PiyushPapaya/Cheirograph/08-ble-wireless-dashboard/README.md

# 08 - BLE Wireless Dashboard

**Phase 7.5, live wireless visualization, ahead of real data collection.**

Once the glove was wired and mounted, I wanted a way to actually see it working, untethered, in real time, in a browser, before committing to the effort of collecting a labeled training set. This stage streams all six IMUs over Bluetooth LE to a live dashboard that renders a 3D hand model plus per-sensor accel/gyro traces. It's also where the hardest debugging session of the whole project happened.

**Status: v4 firmware live on the glove since 2026-08-07, streaming at ~47 Hz.** Open issues are listed at the bottom.

**Firmware:** [`08_ble_dashboard.ino`](08_ble_dashboard.ino). Flash it with the Arduino IDE using the Seeed nRF52 Boards package (the Adafruit-based core, see Toolchain below).
**Dashboard:** `handrig_dashboard.html`, open it directly in Chrome or Edge, desktop or Android, no build step, no server. The canonical copy is `tools/handrig_dashboard.html` (the `tools/verify_*.mjs` scripts read it). Byte-identical copies sit [here](handrig_dashboard.html) (this stage's deliverable) and in `Data/html/`; copy the canonical file over both after every edit and compare with `md5sum`.

## Why this is v4, not v1

The first two firmware attempts fed all six IMUs through the same library I'd used since Phase 2, and got garbage back from four of the five fingers. Not noise, actual stuck values. One gyro axis pinned at exactly `246.0938` on every single frame. Another axis ramping by an exact, constant step every frame, like a counter, not like a physical rotation. Real evidence of this is saved in this folder's CSV captures.

I chased this as a fusion or calibration bug for a while, "garbage in, garbage out no matter how I calibrate," and that was the wrong layer to be looking at. The actual problem was two layers below any math: the sensors themselves were never fully waking up.

```mermaid
flowchart TD
    A["Symptom: 4 of 5 fingers stream garbage"] --> B{"Assumed cause: fusion or calibration bug"}
    B -->|hours of tuning, no fix| C["Root cause is two layers lower"]
    C --> D["Read WHO_AM_I on all five fingers"]
    D -->|4 report 0x72, 1 reports 0x68| E["Same clone-family discovery as Stage 02, now at full scale"]
    E --> F["Library never sends the wake-up write these clones need"]
    F --> G["Drive fingers with raw I2C register writes instead"]
    G --> H["All five fingers read clean"]
```

**Root cause:** the five finger modules are MPU-6500/9250-family clones, same discovery as Phase 2, just five sensors deep into the build before it mattered this much. The library I'd been using talks to them fine at the bus level, I²C acknowledges, addresses respond, but it never sends the specific register write that fully wakes this chip family. So the clones boot into a half-asleep state and return a fixed internal pattern instead of live sensor data. One finger, the pinky, happened to be a genuine MPU-6050 and worked from the start. That "always the same four broken, always the same one working" pattern was the actual clue that pointed at initialization, not wiring or a bad batch.

**The fix:** drop the library for the fingers and drive them with raw I²C register writes: explicit reset, wake, enable-all-axes, configure. That last step, enabling all six accel and gyro axes explicitly, is the one the clones specifically need and the library was silently skipping.

## What changed between v3 and v4

v3 fixed the wake sequence but still assumed every write actually landed. v4 closes that assumption, one gap at a time:

- **Every I²C write's acknowledgment is now checked.** Previously a failed write, including a failed mux channel select, passed silently. A NACKed mux select is a specific kind of dangerous, since it means one finger's configuration can get written to whichever channel was still latched from before.
- **Config gets read back and compared after every init.** An acknowledgment only proves something on the bus answered. It doesn't prove that specific chip actually stored what you sent it. A matching readback does. This is what makes "the sensor initialized successfully" something you can actually trust instead of hope.
- **A runtime "stuck" watchdog runs continuously, not just at boot.** The earlier boot-only check couldn't catch a sensor that froze ten minutes into a session. Now, all six raw values are compared frame to frame, and 50 consecutive bit-identical frames, about one second, means the sensor is frozen. The reasoning behind that threshold isn't a guess: at this sensor's resolution, one unit of precision represents about 122 micro-g, while the chip's own noise floor is several milli-g. A working sensor physically cannot repeat exactly, even sitting motionless on a table. This test is meaningfully stronger than just checking "is the reading close to 1 g," the original stuck thumb passed that weaker check just fine, which is exactly why it went unnoticed for a while.
- **The bus can now recover from a wedge.** If a sensor holds its data line low mid-transaction, the entire bus locks up and every sensor starts reading garbage at once, which looks like total hardware failure but is actually a twenty-line software fix: bit-bang the clock line a few times to force the stuck line free.
- **A cleared "valid" bit now actually means invalid.** Before, a failed read still got sent as zeros with the validity flag left on, meaning a value of exactly zero gravity got fused into the orientation math as though it were real data, a claim that gravity briefly vanished, which is a much worse failure than just dropping the frame.
- **A checksum byte was added to the BLE frame.** The frame's sync byte isn't rare enough to trust on its own, it shows up inside normal sensor payload data often enough that one dropped byte can cause the parser to lock onto the wrong position and render a full screen of plausible-looking garbage.

```mermaid
stateDiagram-v2
    [*] --> OK
    OK --> OK: new frame differs from last
    OK --> Stuck: 50 consecutive identical frames
    Stuck --> Reinit: soft re-init attempt
    Reinit --> OK: reads differ again
    Reinit --> HardReset: every 4th failed attempt
    HardReset --> OK: full wake sequence succeeds
    HardReset --> Reinit: still stuck, retry later
```

## Boot diagnostic

Every boot, before BLE advertising starts, the firmware checks all six channels and prints the result to serial at 115200 baud, with the glove held flat and still:

```
#   sid 1 who=0x72  |a|=1.01g  -> OK
#   sid 2 who=0x72  |a|=1.00g  -> STUCK (bit-identical, output registers frozen)
#   sid 3 who=0x72  |a|=0.98g  -> RAMP (constant per-frame delta = digital artifact)
#   sid 4           -> NOT FOUND (no ACK / init or readback failed)
# 5/6 sensors initialised.
```

Read this after every flash before trusting anything downstream of it. If a channel isn't `OK` here, the problem is now electrical, a cold solder joint, wiring, wrong mux channel, not firmware. The init path is verified by readback at this point, so software is no longer a plausible suspect.

## Sensor mounting axis convention

The firmware always streams raw, sensor-frame data. The axis remap into a common frame lives in the dashboard, not the firmware, so every capture stays reinterpretable even if the remap changes later. Measured directly on the mounted glove: for the finger sensors, the sensor's own −Y axis points toward the fingertip and +Z points up. The hand sensor uses a different convention entirely, it's a different chip, mounted differently, which is confirmed by it reading roughly −0.98 g on its Z axis with the glove lying flat, palm down.

## Pre-collection checklist

Before any real labeled-data session, the checklist below has to pass. Bad data collected now becomes an unexplained problem in the classifier much later, far more expensive to catch there than here.

1. Flash the current firmware, hold the glove flat and still, and confirm the boot diagnostic reports all six sensors `OK`.
2. Connect the dashboard, run the calibration routine once, glove flat and still. Every sensor should calibrate clean, no flag raised on any card.
3. Record 60 seconds flat and still, export the CSV, and run it through the noise-baseline check script. It has to print GO. On a NO-GO, fix the flagged sensor's connection and repeat from step 1 rather than pushing ahead anyway.
4. Only once that passes: start real data collection.

## The evidence that cracked it

These two captures are the actual raw data that made the clone-chip diagnosis possible, exported directly from the dashboard before the fix landed.

- [`capture_01_pre_fix_garbage.csv`](capture_01_pre_fix_garbage.csv)
- [`capture_02_pre_fix_garbage_calibrated.csv`](capture_02_pre_fix_garbage_calibrated.csv)
- [`data-notes.md`](data-notes.md), original notes on what these captures show.

## First live session (2026-08-07)

The first time v4 ran on the glove, the dashboard connected and sat at 0 Hz with bad frames climbing. The serial report line showed why. Reading all six sensors took a flat ~5.9 ms the whole time, but `bleuart.write()` blocked for over 100 ms and the loop rate fell from 50 to 8.3 Hz. The sensors were fine. The BLE link was configured far below what the chip can do. `Bluefruit.configPrphBandwidth(BANDWIDTH_MAX)` before `begin()` plus a relaxed connection interval fixed it: **~47 Hz, 3.7 KB/s, confirmed live.** Reasoning in [DECISIONS.md](../DECISIONS.md#2026-08-07--widen-the-ble-link-instead-of-shrinking-the-data).

## Still open

- **Pinky accel reads 25–28 % low** (`|a|` ≈ 0.72–0.77 g instead of ~1.00 g), on and off. The dashboard flags it and freezes that finger instead of drawing garbage. Next step: check the solder joint at the knuckle.
- **Curl sign and model hand** (left vs. right) are options in the dashboard. The model hand defaults to left. The hand axes are no longer an option: since 2026-10-31 the dashboard measures how the XIAO sits (tilt from gravity at calibration, in-plane angle from the gyros).
- **Tilted, palm-down hand drifts on its own.** Needs a controlled flat-vs-tilted retest at a known β.
- The October dashboard redesign and several August features (curl readout, thumb pose, gesture rule) haven't been tried live.
- No classifier yet. That depends on clean data from this stage, collected with [stage 09](../09-firmware-hardening/)'s firmware.

## Toolchain

Read from the build machine on 2026-10-19 (Arduino IDE, `%LOCALAPPDATA%/Arduino15`), not logged at flash time.

- Board package: **Seeed nRF52 Boards 1.1.13** (the Adafruit-based core; `bluefruit.h` only exists in this one), board *Seeed XIAO nRF52840 Sense*.
- Libraries: Seeed Arduino LSM6DS3 **2.0.7**. Bluefruit and `Wire` come with the board package. The finger IMUs use the sketch's own raw-register driver, no MPU-6050 library.
