PiyushPapaya/Cheirograph/02-single-mpu6050/README.md

# 02 - Single MPU-6050 Test (Direct I²C)

**Phase 2. Status: done. Sensor alive, raw accel and gyro verified and plotted. No mux yet.**

Before wiring five sensors behind a multiplexer, I wanted one working sensor I actually understood. Debugging one chip is a lot easier than debugging five behind a mux, so this stage is deliberately narrow: wire a single MPU-6050 straight to the XIAO, no mux, and get clean data out.

This is also where I ran into the first real problem of the project.

## Wiring

Four wires, plus one that fixes the address.

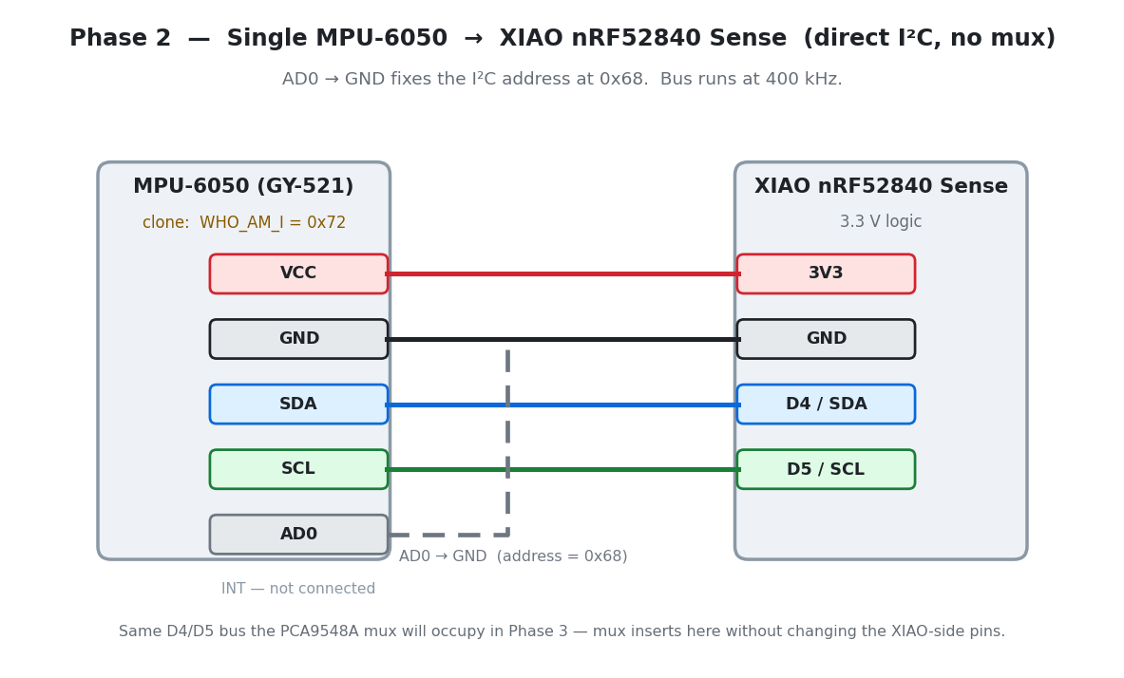
[picture p11: hardware/wiring_mpu6050_direct.png]
MPU-6050 → XIAO direct wiring


| MPU-6050 pin | XIAO pin | Purpose |
|---|---|---|
| VCC | 3V3 | Power |
| GND | GND | Ground |
| SDA | D4 / SDA | I²C data |
| SCL | D5 / SCL | I²C clock |
| AD0 | GND | Sets I²C address to `0x68` |
| INT | (unused here) | |

This is the same D4/D5 bus the mux sits on later. Proving one bare sensor here means that if a finger misbehaves once the mux is in, the sensor and driver are already known good. The mux becomes the first suspect, not the last.

## The clone chip

My first attempt used the Adafruit_MPU6050 library. It printed `Failed to find MPU6050 chip!` and stopped dead. I ran an I²C scanner and it clearly found something at `0x68`, so the wiring wasn't the problem. Then I read the `WHO_AM_I` register (0x75) directly instead of trusting the library's judgment, and it came back `0x72`.

```mermaid
flowchart TD
    A["Adafruit_MPU6050.begin()"] -->|"Failed to find MPU6050 chip!"| B[Run I2C scanner]
    B -->|device found at 0x68| C[Wiring is fine]
    C --> D["Read WHO_AM_I register directly (0x75)"]
    D -->|returns 0x72, not 0x68| E[This is an MPU-6500/9250 clone]
    E --> F[Switch to MPU6050_light, which doesn't gate on chip identity]
    F --> G[Sensor works immediately]
```

A genuine MPU-6050 reports `0x68` there. `0x72` belongs to the MPU-6500/9250 family. What I had was a clone, a very common situation with cheap "MPU-6050" breakout boards, and Adafruit's library checks that register strictly and refuses anything that doesn't match exactly.

Switched to `MPU6050_light`, which doesn't gate on that check, and it worked immediately. It's lenient about chip identity and still does bias calibration in one call. Full reasoning is in [DECISIONS.md](../DECISIONS.md#2026-07-14--mpu6050_light-over-adafruit_mpu6050). All five finger modules came from the same order, so I assumed they were all the same clone. That assumption mattered a lot later: in [stage 08](../08-ble-wireless-dashboard/) the same clone issue broke four of five fingers.

## What's in this folder

| File | What it prints | Role |
|---|---|---|
| [`02_single_mpu6050_test.ino`](02_single_mpu6050_test.ino) | `millis,sensor_id,aX,aY,aZ,gX,gY,gZ` | The real milestone sketch, full serial contract |
| [`diagnostics/i2c_scan/`](diagnostics/i2c_scan/i2c_scan.ino) | text | Scans the bus and reads `WHO_AM_I`, the sketch that found the clone |
| [`diagnostics/gyro_raw/`](diagnostics/gyro_raw/gyro_raw.ino) | `gX,gY,gZ` | Minimal gyro-only stream, used to build the gyro plot below |
| [`diagnostics/accel_raw/`](diagnostics/accel_raw/accel_raw.ino) | `aX,aY,aZ` | Minimal accel-only stream, used to build the accel plot below |

Arduino IDE only compiles one sketch per folder, which is why the diagnostics are split into their own subfolders instead of living side by side.

## How I knew the sensor was actually healthy

- Sensor answers at `0x68`, streams cleanly, no I²C hangs or garbage values.
- Flat and still, accel reads roughly `0, 0, 1` g, gravity sitting on Z. Tilting moves the axes the way you'd expect.
- Gyro sits near 0 deg/s at rest (after calibration), swings out to a couple hundred deg/s on a fast twist, comes back down.
- Both captures saved and plotted in 3D below.

## The plots

Built with a small Python script (`plot_imu_3d.py`, in the project's `tools/`) from the two diagnostic captures. Each point is one sample; color goes from dark to bright over time, so you can read the order of motion, not just where the points ended up.

Accelerometer 3D trajectory

This is the real sanity check. Gravity has constant magnitude, so every point should sit roughly on a sphere of radius 1 g, and it does. The bright cluster is where I set the sensor down and let it sit still at the end. The couple of points past 2 g are real linear acceleration from a quick shake, not sensor noise.

Gyroscope 3D trajectory

The gyro path loops out during each twist and comes back toward zero once I stop moving, angular rate, not angle, so it's tracking speed of rotation, not position. It never quite returns to a perfect zero. That small leftover bias, a couple deg/s, is exactly the kind of drift the Madgwick filter has to fight later.

## Still missing

No mux, no fusion, no other sensors. One sensor, proven honest.

## What's here

- CSV captures: [`accel_raw.csv`](accel_raw.csv), [`gyro_raw.csv`](gyro_raw.csv)
- [`data-notes.md`](data-notes.md), original notes on how these captures were taken.
- [`story.md`](story.md), the narrative version of this session.

## Toolchain

Read from the build machine on 2026-10-19 (Arduino IDE, `%LOCALAPPDATA%/Arduino15`), not logged at flash time.

- Board package: not recorded when this stage was flashed. This machine has both **Seeed nRF52 Boards 1.1.13** and **Seeed nRF52 mbed-enabled Boards 2.9.3** installed; either builds this sketch. Use 1.1.13 to match stage 08.
- Libraries: MPU6050_light **1.2.1**.
