PiyushPapaya/Cheirograph/DOCUMENTATION.md

# Build log

The dated ledger of this project: what I planned each session, what actually worked, and what broke. Newest entry first.

Rules I keep:
- One entry per work session.
- Failures go in. A log that only shows wins is useless as evidence.
- The log is updated in the same commit as the code it describes.
- Past entries aren't edited to look better. The 2026-10-31 docs pass changed wording and fixed old paths to match the current folder layout. Facts and results were left as they were.

Roadmap: [GENERAL_PLAN.md](GENERAL_PLAN.md). Design choices: [DECISIONS.md](DECISIONS.md).

---

## Where things stand (2026-11-07)

| Area | State | Evidence |
|---|---|---|
| Six IMUs on one I²C bus via mux | Works, ~94 Hz raw | [04](04-all-six-imus-raw/) |
| Madgwick fusion per sensor | Works on the bench, roll/pitch drift ≤ 0.35 °/min | [05](05-madgwick-fusion/) |
| Glove mount | 30 min wear test passed | [07](07-full-glove-assembly/) |
| BLE stream + live 3D dashboard | Live on the glove since 2026-08-07, ~47 Hz | [08](08-ble-wireless-dashboard/) |
| Hand-relative quaternion | In the dashboard (JS), not in firmware | [tools/](tools/) |
| v5 firmware (runtime fault recovery) | **v5 plus the self-healing dashboard works on the glove (user-observed, 2026-10-31). Motion tests not re-run, no new numbers.** Dashboard also learns accel offsets live (synthetic test only). Flashed 2026-10-31. Motion tests found gyro clipping, a 17 Hz frame rate and a dashboard calibration bug. Fixes written and compiled (gyro ±2000 °/s, BLE link requests, closed-form calibration settle). Updated v5 flashed: serial shows 50 Hz connected, MTU 527, 15 ms interval. Dashboard RATE and CSV rate not yet confirmed, motion tests not re-run. Dashboard now has self-healing (stillness-based bias tracking, adaptive snap-back, auto re-zero on a flat hand, HEALTH readout): replay on the old captures cut end-of-test finger error to under 5 deg in most tests, not yet tried on the glove. Recovery paths still untested | [09](09-firmware-hardening/) |
| Thumb rig (dashboard) | Reworked twice on 2026-11-07 (see the correction in that entry). Now: anchor under the palm, tip sensor's rotation split over base and tip joint (`THUMB_BASE_FRAC` 0.5, a guess). Checked offline with `tools/verify_thumb_rig.mjs`. **Not yet tried on the glove (unverified).** The single measured flex axis was dropped | [tools/](tools/) |
| Thumb tracking | **Dashboard changes made 2026-11-07 (anchor under the palm, rotation split over two joints, readout is total rotation). Not tried on the glove, no clean 50 Hz thumb CSV yet.** Verified only with injected rotations and `tools/verify_thumb_rig.mjs`. The thumb sensor is on the tip segment per the user (not visible in the July photo). | [tools/](tools/), [motion tests](09-firmware-hardening/motion-tests/README.md) |
| Thumb curl | Works on the glove (user-observed, 2026-11-07, no CSV). The split rotation fix is confirmed visually only | [tools/](tools/) |
| Touch detection | Built 2026-11-07: pose-to-touch label table, trainer, dashboard readout, guided calibration (now 17 steps, about 4.6 min, no stillness gate) that records per-session touch templates, plus Self-test, coach, live "04 Touch" section and Export calibration (now v3, the black box). **First real export 2026-11-07:** 13 of 15 holds kept, replay detection right on all of them (old capture). **First v3 session 2026-11-07:** guided calibration 16 of 16 holds kept, but Self-test 0 % on all four touches (flat hand 100 %). Repeat touches land 2.1x to 3.5x the template radius from their hold, about as far as the near miss, so no radius separates them. Open, see DECISIONS.md. The trainer's gate failed on first synthetic data, see the 2026-11-07 entry | [10-touch-detection](10-touch-detection/). Dashboard audited the same day, five bugs fixed (see the audit entry). Nothing from the audit has run on the glove (unverified) |
| Dashboard black box | Export calibration saves raw frames of all six sensors, events, stage marks, holds and self-test as version 3 JSON, even after a stopped or disconnected run. `tools/analyze_touch_calibration.py` reports frozen sensors and pinned gyros. Tested on simulated runs (`tools/verify_blackbox.mjs`). **Ran on the glove 2026-11-07:** 15609 frames, 0 lost, 0 bad, 50.0 Hz, no clipping. The export was enough to find the cause of the Self-test failure offline | [10-touch-detection](10-touch-detection/) |
| 3D hand and contact display | `fitHand` was removed after the real hand rejected it (gap 0.83). Now: learned thumb base movement (pose-space interpolation of offsets learned from the touch holds), finger roll from the fist hold, 3-segment fingers, display-only contact correction. Replay of one real session: mean tip gap 1.84 default, 0.11 learned, 0.009 drawn (small partly by construction). **2026-11-07 live test:** the 3D thumb lay along the palm during a thumb-to-middle ring. Fixed in the dashboard with nearest-anchor weights and a near-pair contact (detection unchanged). On the recorded file the drawn thumb gap during self-test touches is 0.03 to 0.46, down from 0.20 to 0.47 (guided holds stay at or under 0.045). **Fix not tried on the glove (unverified).** Joint shares, `NEAR_GAP` and `THUMB_BASE_FRAC` are guesses | [10-touch-detection](10-touch-detection/) |
| Dataset tooling (checker, kNN baseline) | Built, tested on synthetic data only | [tools/](tools/) |
| Real labelled data, classifier, BLE HID | Not started | |

Pinky accel "25–28 % low" (2026-08-07): explained on 2026-10-31. It is a zero-g offset of about (0.250, 0.190, -0.165) g, not a scale error. Corrected by a constant in the dashboard. Root cause of the offset is unverified. Not yet re-checked on the glove.

---

## Entry template

```
### YYYY-MM-DD | Phase N: short name

**Plan:** what I meant to do.
**Achieved:** what actually works, with evidence.
**Problems:** what broke or surprised me.
**Next:** the first thing to do next session.
```

---

## Entries

### 2026-11-07 | Phase 8: first real black box session, thumb display

**Plan:** run the new guided calibration and Self-test on the glove, export the v3 black box, and see whether the detector holds up.

**Achieved:** the black box worked. File: `10-touch-detection/calibration_2026-11-07_v3.json` (3.8 MB, mirrored in `Data/csv/`), report: `10-touch-detection/report_2026-11-07_v3.txt`.
- Link: 15609 frames, 0 lost, 0 bad, firmware at 50.0 Hz. No clipping, no errors.
- Guided calibration: 16 of 16 holds kept, replay 100 % on every hold, 0 retries.
- Flat check read 10.7 deg bent. The first export's SPREAD read about 25.
- Hand IMU mount tilt 16.6 deg. Finger rolls: index 0, middle 4, ring 2, pinky -7 deg.
- Pinky learned offset (0.257, 0.186, -0.161) g, matching the (0.25, 0.19, -0.17) g from 2026-10-31.
- Template radii 0.072 to 0.193, all limited by the near-miss holds.
- Thumb display fixed (below), checked by replaying the file (`tools/verify_selftest_replay.mjs`). All `tools/verify_*.mjs` and `verify_*.py` exit 0, the three dashboard copies match by md5, the page loads with no script errors.

**Problems:**
- Self-test: all four touches 0 %. The flat hand was 100 % (150 of 150 frames read nothing).
- I also saw the 3D thumb lying along the palm face during a live thumb-to-middle ring.
- Cause of the 0 %: I replayed the raw frames through the dashboard's real pipeline. It reproduces all 16 holds within 0.058 per digit, so it is not a code bug. A repeat touch lands about as far from its guided hold as the near-miss hold does. Distance vs radius: TI 0.33/0.156, TM 0.47/0.179, TR 0.36/0.102, TP 0.25/0.072, so 2.1x to 3.5x. A near miss sits at 2x by construction, so no radius accepts these touches without accepting the near misses.
- Ruled out: timing (distance is flat before scoring) and a global shift (on the flat step the fingers sit 0.06 to 0.10 from FLATCHECK). The error is in the touching digits: thumb heading 6 to 31 deg off its hold, in a different direction per pair, and the target finger 8 to 23 deg less curled. Each self-test touch sits closest to its NEAR hold. The right pair was still the nearest relative to its radius in 4 of 4 touches.
- Cause of the thumb on the palm: the thumb warp weights had a 1e-3 floor. Once the pose was more than about 0.6 from every anchor, all weights fell under it and the thumb went back home.
- Unverified: 16 s between the end of the guided run and Self-test were not recorded. The live meters were 0.1 to 0.27 worse than the replay. A zero of all sensors in that gap fits better (rms 0.17 to 0.11) but that is a guess. At FLATCHECK the hand and thumb were 13 and 11 deg off the calibration "up", outside the 8 deg auto re-zero gate.

**Display fix (dashboard only, detection unchanged):**
1. `thumbWarp` weights are relative to the nearest anchor: `w_i = exp(-(d_i^2 - d_min^2) / 2 sigma^2)`, normalised. The weight floor is gone. Rest poses still stay home because FLAT, FIST, SPREAD and FLATCHECK are anchors with zero offset.
2. New `nearPair`, `NEAR_GAP` 0.75 (about two finger widths, a guess). With no detected touch, the fingertip nearest the drawn thumb tip gets the existing contact correction if it is within 0.75. A detected touch still wins. The 40 deg cap stays.
3. Result on this file: drawn thumb-tip gap during self-test touches TI 0.33 to 0.12, TM 0.46 to 0.07, TR 0.37 to 0.03, TP 0.20 to 0.12. Guided holds stay at or under 0.045. Flat hand: no contact drawn.
4. Detection stays at 0 % on these touches. The data cannot separate them, so I did not fake it. See "Open: separating a touch from a near miss" in DECISIONS.md.
5. Known risks, unverified on the glove: thumb to middle may draw closing onto the ring finger (seen in one replay variant, gap 0.55), a fist may draw the thumb snapped onto a finger, and `NEAR_GAP` and `THUMB_BASE_FRAC` 0.5 are guesses. A near miss is now drawn closed too.

**Next:** on the glove, reload, run guided calibration, go straight into Self-test with nothing in between, and use the same firm curled pose as in the guided hold. Watch whether the 3D thumb lands on the right fingertip, especially thumb to middle, and whether a fist snaps the thumb onto a finger. Record that session. Then decide the open detection question (several holds per touch, drop the radius cap, or fingertip pads).

### 2026-11-07 | Phase 8: dashboard audit and black box

**Plan:** end the day with a dashboard that works on the next glove run, and make one run produce everything needed to find what is still wrong. An earlier attempt stopped partway: the recording code was done, but the audit was unfinished and never tested end to end.

**Achieved:**
- Black box (`DASH_VERSION` "touch-calibration v3 · black box · 2026-11-07"). Export calibration now saves a version 3 JSON with raw frames of all six sensors, the event log, stage marks, session facts, holds, results and the self-test. It works after a stopped or disconnected run. Caps: 20000 frames (6.7 min at 50 Hz) and 3000 events. A 5 minute run is about 3.5 MB (scaled from 1.61 MB measured for 6800 frames). Raw values are rounded to 3 decimals in the file.
- Report script `tools/analyze_touch_calibration.py`: new `raw_faults` flags a sensor with 50 or more identical frames in a row, and a gyro axis pinned at 240 deg/s or more for 5 or more samples. Each report section now runs on its own, so a partial or damaged file prints what is missing instead of crashing. It still reads the version 1 file.
- New test `tools/verify_blackbox.mjs`. It runs the page's real export code on simulated 17-stage runs and feeds the result through the Python report. Passing cases: clean, stopped, disconnected, frozen sensor, invalid sensor, frame loss, clipped gyro, buffer full, self-test failure.
- Audit of the dashboard. Five bugs fixed in `tools/handrig_dashboard.html`:
  - `onNotify`: a throw in `parseFrame` left the bad frame in `rxBuf`, so every later packet hit it and the stream froze. Now caught, logged with `noteError("frame")`, skipped.
  - `setTouchModel` was called but never defined (also in the last commit). The touch model file picker always showed "not a valid touch model JSON", and a saved model never reloaded. Added.
  - `validTouchModel` accepted unknown pair names, which would have made `contactFix` throw in `render()` on every frame. Now rejected.
  - The 3D loop had no try/catch, so one throw would stop the view for good. Wrapped, reported with `noteError("render")`. I found no real way to trigger this, and its check only inspects the page text.
  - Coach text from the previous run stayed on screen during a new guided run. Cleared in `startGuided`. No automated check, it needs the DOM.
- Audited with no bug found: buttons and state conflicts, timers and listeners, disconnect mid-run, bad sensors, left/right model switch, on-screen text, render helpers, batch quality gate logic.
- Accepted, not fixed (low risk): `setMountTilt` gives NaN if two fingers saw exactly opposite up; Zero stays enabled during batch capture; `rawHist` is not cleared on reconnect; a drop between `startNotifications()` and `onConnected()` would leave `linkUp` true.
- Verification: all `tools/verify_*.mjs`, `verify_touch_model.py` and `verify_check_dataset.py` exit 0. The three dashboard copies match by md5. The page loads in a real browser with no console errors and the 3D canvas is present.

**Problems:**
- `verify_touch_js.mjs` broke after the pair name fix. It loaded only the touch section of the page and `PAIR_FINGER` sits outside it. The page itself was fine. The test now loads that constant. With no argument it prints "skipped", because `verify_touch_model.py` supplies its fixture.
- Limits, all unverified: nothing here has run on the glove. Simulated exports leave replay, rolls and flat check empty, so those report sections have only run on the version 1 file or on missing data. The live frame handler's lost-frame and clip counters were not exercised by the black box test. Self-test has never run on the glove.

**Next:** hard-reload the dashboard, connect, run Guided calibration, run Self-test, Export calibration, then `python tools/analyze_touch_calibration.py <file>`. Compare with the first export (kept holds, SPREAD reading, flat check, rolls, replay). Then record the pose set. Steps are in `10-touch-detection/PLAN.md`.

---

### 2026-11-07 | Phase 8: README rewrite, thumb rig check

**Plan:** rewrite the main README from scratch. The project has come a long way since the first version, there are new images and videos, and the front page should work as a full tech showcase: explain everything and be impressive to a recruiter. Also record the thumb rig and flex-axis fix.

**Achieved:**
- `README.md` is fully rewritten. Structure: centered hero with the glove photo and badges, "In one minute", an "At a glance" table, a 2x2 "See it" media grid, the `q_rel` idea, a mermaid pipeline (including the planned ML branch), a status table, measured results with the before/after table from the 2026-10-31 motion tests, the 7 bugs, a stage table with thumbnails, an ASCII roadmap, scope, skills, hardware, run steps and a repo map.
- The media grid uses committed images only: the stage 04 gif, `docs/media/dashboard-before.png` and the two stage 07 photos (finger wired, hand top).
- Every number was carried over from the old README. Nothing new was measured today.
- New status row for the thumb rig and flex-axis fix. Findings: the thumb sensor data is healthy (best T5 error of all five digits, mount tilt only 16 deg). The problem was interpretation. The model thumb was buried inside the palm box, and thumb bend was read as pitch, while the real thumb moves about an axis close to the palm normal. This is fixed in the dashboard.
- `tools/verify_thumb_rig.mjs` (new) checks the thumb rig and flex-axis maths offline.
- Video is now on the front page (second request today). Source: a finished 9:16 before/after clip of the T2 fast fist (13.1 s, glove video on top, dashboard 3D model below, cut from before to after at 7.47 s, hook text "My hand was flat. My glove said my ring finger was bent 163°."). From it I made three small files in `docs/media/`: `t2-fast-fist-before-after.mp4` (540 px wide, CRF 28, silent, 1.4 MB), `t2-fast-fist-before-after.gif` (270 px, 10 fps, 64 colours, 3.8 MB) and `t2-fast-fist-cover.jpg` (4:5 cover frame).
- README "See it" shows the GIF inline and links the mp4 and the cover. It says the 163° is read off the dashboard by eye, and that the after run is video only, not re-measured.
- The raw before/after screen and hand recordings (45 MB and 50 MB) are too big for git and stay local.
- Resolved the open README-video item in [DECISIONS.md](DECISIONS.md): committed GIF for inline playback plus committed mp4 for quality.
- New photos and a fresh dashboard screenshot (third request today). I got a current-dashboard screenshot and eight phone photos, had them rotated where needed, and saved them in `docs/media/` with plain names. The photos are compressed JPEGs (max 1600 px, about 220 to 340 KB each).
  - `dashboard-current.png`: the live dashboard at 50 Hz, with the health readout, calibration and batch capture.
  - `glove-live-in-front-of-dashboard.jpg`: the glove worn in front of the dashboard.
  - `hand-worn-flat-fingers-up.jpg`, `hand-worn-thumb-out-fingers-up.jpg`, `hand-worn-cupped-side-view.jpg`: these three were sideways, so I rotated them 90 degrees clockwise to put the fingers up. Checked by eye.
  - `glove-back-flat-wired.jpg`, `glove-back-curled-on-table.jpg`, `glove-side-view-xiao-and-breadboard.jpg`, `finger-imu-closeup-status-leds.jpg`: bench views.
- The README "See it" section is rebuilt in four parts: the dashboard now vs before, the glove worn in front of the dashboard, a 3x2 grid of the glove (worn poses and bench views), and earlier-stage media. The hero photo is now `hand-worn-flat-fingers-up.jpg`.
- The originals stay untouched in the Downloads folder. The new media adds about 2.6 MB to git history. No data was measured.

**Problems:**
- The thumb fix is not tried on the glove (unverified). `THUMB_FLEX_AXIS` was derived from the 17 Hz captures. Superseded later the same day: that axis was removed, see "Correction" in the "thumb tracking" entry below.
- The motion-test mp4s (`before-fix_2026-10-31` and `after-fix_2026-10-31`, T0 to T6) are gitignored, so the README cannot embed them. Only the T2 fast-fist clip is shown, as the small copies in `docs/media/`. The other tests link to the motion-tests folder for protocol and findings.
- How the GIF renders on GitHub is unverified until pushed. GitHub does not play repo mp4 files inline in a README, which is why the GIF is the inline version. The GIF is 270 px and 10 fps, so it is soft and the fast snap looks choppy.
- `glove-back-curled-on-table.jpg` is saved but not used in the README yet. How the new image grid renders on GitHub is unverified until pushed.
- The edited clip folder `edited_2026-10-31/` from the 2026-10-31 entry was not found on disk under `09-firmware-hardening/motion-tests/`. Where it went is unverified.

**Rock-and-roll pose not detected (user report, later 2026-11-07):**

Report: on the glove I made a rock-and-roll style pose, ring finger touching the thumb with the other fingers straight, and the system cannot detect it. I asked why and how to fix it. I also proposed many more tests (ring to thumb, middle to thumb, ring and pinky, and so on) to fully configure the hand to the glove, so every action is picked up and ML gets easier.

Findings:
- No recording of this pose exists: no CSV newer than 2026-11-01 in the repo or Downloads. "Cannot detect" is my visual report, so the exact symptom is unverified.
- The glove measures the orientation of six segments. It has no contact sensing, so touch is never measured, only inferred.
- The dashboard has one rule, thumb-to-index (`detectGesture`, thresholds are guesses). Nothing exists for ring, middle or pinky, and no classifier exists yet.
- The 3D hand uses generic proportions, not mine. Model geometry check (curl 0 to 130 deg, thumb reach 1.8 units from its base), closest fingertip distance to the thumb base: index 0.68, middle 1.13, ring 1.66 (only at about 130 deg curl), pinky 2.19 (0.39 units short, cannot reach). This is a calculation on model geometry, not glove data.
- One sensor per digit, so joint angles are estimated and position errors stack up.
- The thumb's sideways motion is gyro-only when the hand is flat, so it can drift.

Conclusions:
- The test idea is good, but its purpose changes. The classifier does not need the 3D fingertips to touch. It needs each pose to give repeatable, distinct readings.
- "Every action perfectly" is not reachable with 6 IMUs. Touching and nearly touching may look identical (unverified until tested).
- Scope stays static hand shapes.

Plan: a "Touch-pose test set" section in [ml/future-data-collection-plan.md](ml/future-data-collection-plan.md). Planned, nothing recorded. 13 poses (references, thumb to each fingertip, rock pose and two other combinations, two 1 cm near misses), 10 reps each, 2 sessions, 130 reps per session. Prerequisite: confirm the thumb curl fix on the glove. Unverified: whether Batch Capture and `check_dataset.py` accept non-letter labels. After recording: leave-one-session-out with `train_baseline.py`, then optionally fit the 3D model using the touch poses as constraints, and only if the data cannot separate touch from near miss, add fingertip contact pads. Both are in [DECISIONS.md](DECISIONS.md) as open items (guided functional calibration, real contact sensing vs inferred touch).

**Touch detection built (user requests, later 2026-11-07):**

Reports and requests, in order:
- Thumb curl now works on the glove (user-observed, no CSV). The split rotation fix is confirmed visually only.
- I want the computer to detect touching, for example thumb and index forming a ring, and I want dataset labels that say which fingers touch, for better recognition and more possible gestures. I asked for a detailed plan, then for it to be implemented.
- My own idea, also implemented: calibrate in several stages. First still, then touch each finger with the thumb and hold 10 s, once as a ring and once with both digits as straight as possible.

Built (all uncommitted, tools and dashboard only; the three dashboard copies are identical, md5 `ac92366b0d80de339ab76e7c40176d89`). Plan in [10-touch-detection/PLAN.md](10-touch-detection/PLAN.md).

Dataset path:
- `tools/pose_labels.py`: 14 poses mapped to touch sets over four pairs (TI, TM, TR, TP). The CSV format does not change, the touch labels come from the pose name.
- Dashboard: pose list on the batch label, pose coverage cells (goal 20 reps).
- `tools/train_touch.py`: one logistic regression per pair on the 15 `dir` numbers, leave-one-session-out. Prints GATE PASS or GATE FAIL (recall >= 90 %, near-miss false alarms <= 10 %) and exports JSON.
- Dashboard "touch model" file input with a live readout. `check_dataset.py` accepts `POSES` files. `make_synthetic_batch.py` has `--poses`, `--curl-offset-sd`, `--near-deg`.

Live path (guided calibration, added today, not in the first plan):
- New button "Guided calibration": 20 s still, then 8 stages (index, middle, ring, pinky, each as a ring and as straight as possible), 5 s to get into position, 10 s hold. About 140 s in total.
- Samples count only while the hand, thumb and that finger are still. A hold needs 30 samples and a spread of 0.2 or less, otherwise it repeats, up to 3 tries, then it is reported as missed.
- Each hold becomes a template of this session. A pair touches when the thumb and that finger are near one of its templates. Only those two digits count, so several pairs can be on at once.
- Radius = max(0.3, 3 x spread), capped at half the distance to the flat hand. Templates under 0.15 are reported as too close to flat. Leaving a touch takes 1.3 x radius, and only when no other touch matches.
- GESTURE readout order: session templates, then the loaded model, then the old thumb-index rule. `touchStatus` shows the nearest template, its distance and its limit, for tuning.
- Auto re-zero is blocked during the guided run. Templates are cleared on disconnect and live in memory only.

Findings:
- The first synthetic run of `train_touch.py` printed GATE FAIL. The implementer stopped instead of weakening the gate. I then checked whether the linear model was the limit, leave-one-session-out on synthetic poses, recall / near-miss false alarm:
  - No session offset, near miss 30 deg: linear 1.00 / 0.00 on all pairs. kNN: TI 1.00 / 0.15, TR 1.00 / 0.12.
  - Session curl offset sd 6 deg, near miss 12 deg: linear TI 0.90 / 0.28, TR 0.76 / 0.25.
  - Plus yaw drift 10 deg, near 12: linear TI 0.95 / 0.53, TR 0.46 / 0.03. Near 30: TI 1.00 / 0.23, TR 0.76 / 0.12.
  - So the model is not the limit. Session-to-session offset is. Linear beats kNN on near misses. This is synthetic data, a warning and not a glove result.
- The gate was not changed. `verify_touch_model.py` now checks both ways: clean data must print GATE PASS, and data with offsets bigger than the near-miss gap must print GATE FAIL. Shuffled labels must also fail.
- The offset finding is why session templates are the better live path: a template and the live pose share the session offset. Verified on synthetic numbers only: a 15 deg offset is still detected by a same-session template and defeats a template from another session.
- A real bug showed up in the browser run and was fixed test-first: moving from an index touch to a straight middle touch showed both pairs, because hysteresis kept the old one.

Verified: `verify_touch_model.py`, `verify_guided_touch.mjs`, `verify_thumb_rig.mjs`, the batch and noise verify scripts and `verify_check_dataset.py` all exit 0. Real page with simulated sensors and simulated time: 8 of 8 stages, the retry fired on a deliberately moving hold, and the live readout was right for ring TI, ring TR, and thumb on middle and ring (both pairs). Flat, fingers only and fist read no touch.

**Problems:**
- Nothing is verified on the glove. Model file loading through the real file picker and the saved-model restore were not exercised. The 0.3 radius is a guess. The guided timing was simulated, not run in real time.
- It detects "this pose matches your touch pose", not contact. Touching and nearly touching may look alike.
- Straight touches may sit close to a flat hand, so they may be flagged weak.
- Auto re-zero can still erase a straight touch held on a flat hand after about 1 s, outside the guided run.
- Sideways drift ages the templates during a session. Rerun guided calibration if detection degrades.
- Guided holds are not saved to the dataset yet. Batch Capture is still the dataset path.

Decisions logged in [DECISIONS.md](DECISIONS.md): touch labels from the pose name, and session templates as the live detector.

**Touch not drawn, hand fit and self-check (user report, later 2026-11-07):**

Report: on the glove the 3D model does not show the touch when fingers touch, as a ring or straight. I feel the touch, but touch and finger position recognition is not fully realised and I cannot check it. I asked for a deep dive, all flaws listed and fixed, more calibration steps to map out my fingers and hand, and a smart assistant for touch recognition and display accuracy.

Flaws found and fixed (all in `tools/handrig_dashboard.html`, three copies identical, uncommitted):
1. Touches were never drawn. Detection only changed a label. Added a contact correction: while a touch is detected, the touching digits turn at their base toward the point between the tips (8 passes, capped at 40 deg per digit, eased in and out). Display only.
2. The hand was generic. Added `fitHand`: Levenberg-Marquardt over thumb base, thumb length and 4 finger scales, using each touch hold as the constraint that two tips are in the same place. Bounds: base +-0.5, length 2.2 to 3.1, scale 0.85 to 1.2. Starts from the default each session. Rejected when the mean gap stays over 0.35. Saved in `localStorage`.
3. Fingers bent wrongly. A middle-phalanx sensor's rotation was applied at the knuckle in 2 segments with a cosmetic 40 % tip bend. Now 3 real segments (0.45 / 0.30 / 0.25), joint shares q^0.5, q, q^1.35. The shares are guesses, only the sensor's segment is measured.
4. The thumb was too short. It pivots near the wrist but had only the phalanges' length, so it reached the index only at about 100 deg of curl and a straight touch could not be drawn. Now len 2.6, z -1.1 (a 2.6 palm is about 10 cm, unverified against my hand).
5. The touch radius was a blind guess. Guided calibration now has near-miss, fist and spread stages. Each template's radius is capped at half the distance to the nearest non-touch pose. A pair's tightest radius applies to all its poses, because only ring poses have a near-miss hold.
6. Combined touches had no stage. Added a rock stage. A two-pair template needs all its digits.
7. Auto re-zero could erase a held straight touch. It is now blocked while a touch is detected.
8. The mount check was outside calibration. Added a hand-turn stage.
9. It could not be checked. Added Self-test (5 prompts, pass at 70 %), a coach (plain rules naming weak or missed holds and the fit status), a live meter for all four pairs (for example `TI 0.18/0.30`), and Export calibration (JSON: holds with rows, templates, fit, self-test).

Guided calibration is now 20 s still plus 16 steps of about 15 s, about 4.5 minutes.

Found by testing, also fixed: the first full run showed a fit dragging the thumb base onto the palm on poses that were not real touches, and an off-template pose reading as a touch through a wide straight radius. Both got tests first, then the fixes above (rejection, tighter bounds, shared pair radius). The coach also said "learned cleanly" above a rejected fit. Fixed.

Measured, simulated only:
- Before: on a simulated different hand the old model left ring-pose tips about 0.64 to 0.73 apart (finger width about 0.38). The simulation was rough, indicative only.
- `tools/verify_hand_fit.mjs` (new), on a second parameter set of the same joint model, 7 of 8 holds real, 2 deg noise: default gap 0.46, fitted 0.03, with contact 0.001. A nearly straight touch beyond thumb reach: 1.01 to 0.18. This shows the fit and solver work. It does not show the joint model matches a real hand.
- Real page, simulated sensors and time, default hand with deliberately non-touching fake poses so the fit was correctly rejected: 16 stages ran. Scene vs maths 0.0000 with and without a touch. Drawn gaps (before to after correction): ring TI 0.80 to 0.01, ring TM 1.12 to 0.00, ring TR 1.75 to 0.01, ring TP 2.50 to 0.56, straight TI 1.35 to 0.32, straight TM 1.69 to 0.61, straight TP 1.67 to 0.57, rock 1.08 to 0.18. Near misses, fist, flat, spread and an off-template pose read no touch. Corrections release to 0 deg. Self-test passed.
- All verify scripts exit 0.

Limits:
- Nothing here has been tried on the glove.
- One sensor couples the thumb's joints, so its tip reaches a thin shell of positions. Straight touches depend on the capped correction, so a gap can remain (up to about 0.6 in the fake-pose run, where the fit was rejected).
- Touch is inferred, not measured. Near-miss separation depends on real data.
- Radii on real data will differ. Sideways drift ages the templates during a session.
- Guided holds are in the JSON export, not in the Batch Capture dataset.
- The thumb-index gesture rule was not retuned. Model loading through the real file picker has not been exercised.

Decisions logged in [DECISIONS.md](DECISIONS.md): three finger segments, fitted hand with rejection, contact correction as a display-only cap. The thumb length change updates the earlier anchor decision, and the "guided functional calibration" open item has an update.

**First real calibration, and a third pass (user report, later 2026-11-07):**

Report: I ran guided calibration on the glove and exported it. It did not work out well. The coverage grid sat on top of the 3D view and covered the thumb. I asked for an additional section, a plan to fully improve the dashboard, and both problems fixed, especially calibration.

**Correction to the entries above.** The "fitted hand" (`fitHand`, thumb base, thumb length, 4 finger scales, rejected at a mean gap over 0.35) was built on simulated data and the real hand refused it. It is deleted, see below. The "Next" list from the previous pass is done: the export exists (`10-touch-detection/calibration_2026-11-07.json`, mirror `Data/csv/10-touch-detection__calibration_2026-11-07.json`).

What the first real export showed (analysed with a replay, numbers from that one file):
- 13 of 15 holds kept. NEARTM and NEARTP were missed.
- Samples kept per hold: 35 to 82 of about 100. Spread was only 0.007 to 0.017. So the stillness gate was far too strict, not the hand. Cause of the strictness beyond that is unverified.
- Self-test was not in the export (null). It has never run on the glove.
- Detection replay on those holds: every touch 100 %, every non-touch 0 %, rock read both pairs. Ring and straight are close (distance 0.25 to 0.33): on this hand they are nearly one pose.
- Hand fit rejected, gap 0.83. Exploring it offline: current bounds 0.88, wide bounds 0.59, wide plus a free joint share 0.51 (per-hold up to 0.92). So a rigid length fit cannot work. The thumb sensor turned only 29 to 45 deg for every touch. The thumb's base joint travels, and a sensor on the tip cannot see it.
- The fist hold shows the finger sensors are rolled: 11, 27, 29, 34 deg for index to pinky. The T5 gyro fit gave the same pattern (10, 17, 21, 30 deg). This reopens the open item on mount correction, and for display it is now solved from the fist hold.
- SPREAD read about 25 deg bent on all fingers. Cause unknown (unverified). The new flat check should show whether it is drift.

Changes (all in `tools/handrig_dashboard.html`, three copies identical, uncommitted):
1. New section "04 Touch" at the top of the right column: a live bar per thumb-finger pair (distance / limit), status, coach notes, and the coverage grid. The grid no longer overlays the 3D view. Checked at 1400 px and 375 px, no overflow.
2. Capture: the stillness gate is gone. The last 7 s of each 10 s hold are used and spread <= 0.1 decides. New final FLATCHECK stage, so 17 steps, about 4.6 min.
3. Finger roll: `rollFromFist` and `unrollQs` correct the drawn fingers. Display only. Detection and exports keep the raw orientation.
4. `fitHand`, `solveN` and the saved hand are deleted. Replaced by a learned thumb movement: each touch hold stores the thumb base offset that puts the tip on the fingertip. Live poses blend those offsets with a Gaussian weight on whole-hand similarity (sigma 0.18). Non-touch poses anchor at zero, near misses use their pair's ring offset. This is pose-space interpolation, not a model of the thumb.
5. A replay check runs after each guided run, and the coach reports it, plus a drift warning over 15 deg. Export is now version 2: q for all holds, replay, flat check, rolls and anchors.

Results:
- `tools/verify_real_calibration.mjs` (new, runs on the real export): held-out rows (templates from the first half of each hold, tested on the second) 13 of 13 holds correct. Mean tip gap on the real holds: 1.84 default, 0.11 with the learned thumb, 0.009 drawn.
- The real page was fed the real holds through the actual guided code: 17 steps, 9 touches learned, none missed, replay 16 of 16. NEARTM and NEARTP were synthesised because the real ones were missed, and the flat check was synthetic too. Drawn gaps 0.000 to 0.026. Fist, spread and near misses read no touch. Fist sideways lean at most 0.05. A flat thumb moved 0.
- All verify scripts exit 0.

Limits:
- All of this replays one session. The gaps are small partly by construction, because the offsets were learned from those same holds. Poses between the holds are blended and unmeasured.
- The new capture, flat check and live behaviour have not run on the glove.
- Touch is inferred, and this is one person and one fit of the glove.
- Self-test has never run on the glove.
- Guided holds are still not in the Batch Capture dataset.

Decisions logged in [DECISIONS.md](DECISIONS.md): learned thumb base movement (supersedes the fitted hand), finger roll from the fist hold, stillness gate removed from guided holds. Open items updated: per-finger mount correction, guided functional calibration, and a new one for SPREAD at 25 deg.

**Next:**
- Rerun guided calibration on the glove (17 steps), run Self-test, export, and compare with `calibration_2026-11-07.json`. Check the flat check and the SPREAD reading.
- Then record the pose set (14 poses, see [ml/future-data-collection-plan.md](ml/future-data-collection-plan.md)).
- After the first push, check how the GIF and the mp4 link render on GitHub. If the GIF is too soft, swap it for a better one.
- Re-run the motion tests on the current dashboard and firmware, then start Phase 8 data collection.

---

### 2026-11-07 | Phase 7.5/8: thumb tracking

**Plan:** status check, then fix the thumb before any data collection. The rest of the hand looks right on the glove (visual only, no CSV recorded on the current dashboard). The thumb is the one part with bad bending and tracking.

**Achieved:**

Status given: phases 0-3 and 7 done, v5 firmware live, dashboard self-calibrating. Caveats: "works" is a visual observation. 50 Hz is confirmed only by the serial report, not by the dashboard or a CSV. Phase 8 has tooling and no real data. Recovery paths, the Phase 5 closing test and the curl sign are still open.

Thumb diagnosis, from the 2026-10-31 before-fix CSVs (17 to 43 Hz, gyro at +-500 deg/s, so indicative only).

Ruled out:
- Bad sensor. Thumb T0 gyro std 0.7 / 0.7 / 1.4 deg/s, bias under 2.1 deg/s, |a| 0.992 g.
- Bad mounting. The T5 gyro fit puts the thumb sensor 16.0 deg from the hand frame (yaw -6.5, pitch -2.9, roll 14.5). Middle 16.7, ring 20.7, pinky 29.8, index 10.2.
- Bad tracking. T5 finger-vs-hand p90, Python replay of Madgwick and `q_rel` without healing: thumb 14.3 deg, index 20.3, middle 20.3, ring 21.7, pinky 32.0. The thumb is the best of the five.
- A per-finger mount correction. Gravity mount gives thumb p90 12.2, full gyro mount 12.7. Index 17.4 / 15.3, middle 16.9 / 16.9, ring 17.8 / 17.6, pinky 29.2 / 27.9. Not a clear win on these captures, so not added. Re-test on a clean capture.

Two root causes found:
1. **Rig geometry.** The model thumb pivoted level with the palm at x 1.45, y 0.1. I walked its axis in 200 steps. Inward swing about Y: 15 deg puts 65.0 % of the thumb inside the solid palm box, 30 deg 77.5 %, 45 deg 82.5 %, 90 deg 86 %. The 2026-08-08 check only covered the rest pose (7.5 %). Screen recording t3 of the after-fix run shows the thumb mostly hidden at rest and visible only when it swings outward. The default camera (camYaw 0.7) also looked from +X, while the left model's thumb is at -X, so it sat behind the palm.
2. **Wrong bend axis.** The curl readout and tip bend used pitch about X. PCA of the thumb gyro on thumb-dominant samples: T3 axis (0.16, 0.95, 0.28), 93 % explained, 19 deg off Y. T4 axis (-0.02, 0.89, 0.45), 91 % explained, 27 deg off Y. So the thumb bends about roughly Y, not X. Range per capture, old pitch vs new flex: T1 -9.0..21.7 vs -25.3..44.8; T2 -11.4..22.4 vs -13.7..51.9; T3 -14.0..4.1 vs -39.8..2.1; T4 -25.6..1.0 vs -44.3..40.4; T6 -17.2..39.2 vs -29.9..18.0. These are unhealed replays, and T4 and T6 include drift. Fists read positive, outward spreads negative.

Changes in `tools/handrig_dashboard.html`, copied to `08-ble-wireless-dashboard/` and `Data/html/` (md5 `a1c9bcf0bd19bbe53ca896f0e2447e18` on all three):
- THUMB anchor now x 1.3, y -0.6, z -0.9, yaw 0.11 (measured rest direction, 6.5 deg outward). It passes under the palm: 0.0 % buried at 0 / 15 / 30 / 45 deg about the measured axis.
- New `THUMB_FLEX_AXIS` (mean of the T3 and T4 axes, normalised) and `thumbFlexRad(q) = 2 atan2(v.n, w)`, wrapped. It drives the thumb's curl readout and tip bend. The tip bends inward only.
- The card's curl sign control no longer applies to the thumb (inward is positive).
- Default camera on the thumb's side for the left model (camYaw -0.7).
- Display only. Raw CSV, `S[].rel` and the batch export do not change.
- New `tools/verify_thumb_rig.mjs`. It failed before the fix and passes now. All other verify scripts pass.

Browser check with injected rotations, no glove: page loads, no console errors, flex reads 0 / 30 / -30, tip joint x -1.41 / -0.93 / -1.85, thumb visible at rest and tucks under the palm.

**Problems:**
- **Not tried on the glove.** There are no thumb numbers from a clean 50 Hz capture.
- `THUMB_FLEX_AXIS` comes from low-rate captures and mostly from outward motion. It is stored in the thumb sensor frame, so it can shift if the sensor is remounted.
- One IMU sits on the proximal phalanx. The tip joint is cosmetic, and the sensor sees only the proximal segment. **Wrong, see the correction below: the sensor is on the tip segment per the user.**
- Physics: the thumb's main axis is near vertical when the hand is flat, so gravity cannot correct it. It is gyro-only there and will drift. The T4 replay ended 53.7 deg off before healing and 13.9 deg after (17 Hz capture).
- **Auto re-zero may erase small thumb poses.** `HEAL_POSE_DEG` 8 cannot tell a held thumb pose from drift. With the axis 19 to 27 deg off vertical, about 18 to 25 deg of thumb motion still looks like "home" and slides to zero after about 1 s still, on a flat hand only. A gate was considered and not added, because it would also stop re-zero from healing real drift like T4. Calculated, not measured on the glove. See the open decision.
- **ML blind spot.** The `curl` feature set in `train_baseline.py` uses d_y only, so it is nearly blind to the thumb's main motion. Letters that differ by thumb position need `dir` or `quat`, which carry yaw drift. Open.
- The thumb-index gesture rule's thresholds (TOUCH_DIST 0.9, UP_MIN 0.35) were guesses, and the anchor moved, so the rule may behave differently now. Unverified, not retuned.
- **Correction to the 2026-10-31 note on `alignHeadings()`.** That entry says it cut T5 p90 from 15 to 12 deg. Algebra and a numeric check (difference 5.6e-17) show that premultiplying the same yaw onto `qRef` and `q` cancels in `rel = qRef^-1 q`, which is also what its own code comment says. So under formula (a) it cannot change the displayed angles. The cause of the earlier 15 to 12 deg change is unknown (unverified). The code was not changed.
- The folder `09-firmware-hardening/motion-tests/edited_2026-10-31/` described in the uncommitted notes was not found on disk during this session.

**Next:** (updated after the correction below)
1. Reload the dashboard (Ctrl+F5, local file), reconnect, recalibrate. No firmware re-upload: today's changes are dashboard only.
2. Glove test of the thumb on the current dashboard.
3. The thumb re-test in the [motion tests README](09-firmware-hardening/motion-tests/README.md). Record before Calibrate.
4. From that CSV: check the tip direction against the video and the joint split, check thumb return error, decide the re-zero gate and the ML feature items (DECISIONS.md, open items).
5. Then the first Phase 8 session.

#### Correction (later the same day)

Parts of the text above are wrong. They stay visible on purpose.

**What I got wrong.** On the glove the user reported that the thumb does not curl while the fingers do. I explained it by saying the sensor sits on the proximal phalanx and cannot see the tip joint, and recommended moving it to the tip. That was wrong. The claim came from the docs (the pre-build decision, `hardware/WIRING.md`, the 2026-10-31 note "one IMU on the proximal phalanx") and I did not check it against the glove. The user corrected it: the thumb sensor is already at the tip, which is why the thumb "points straight down" when bent. The July photo does not show the thumb clearly, so the position rests on the user's report (unverified by photo). When the sensor moved there is unknown (unverified). So the lines above that say "one IMU on the proximal phalanx, the tip joint is cosmetic" no longer hold.

**Root cause of "points straight down".** The model applied the tip sensor's full rotation to the whole digit from its base, then added an extra cosmetic tip bend. The whole thumb went where the tip points.

**The single-axis idea was incomplete.** Thumb axis per capture (relative to the hand, thumb sensor frame), X / Y / Z energy share: T1 0.16 / 0.74 / 0.10, T2 0.12 / 0.65 / 0.23, T3 0.07 / 0.90 / 0.03, T4 0.05 / 0.78 / 0.17, T6 0.62 / 0.28 / 0.09. T1 to T4 are mostly sideways swing, T6 is mostly about X (downward bend). The thumb moves on two axes, so one measured flex axis cannot describe it. These are still low-rate captures. Fist rotation vs hand, T1, p95: thumb 32, index 93, middle 120, ring 118, pinky 122 deg (rough). The numbers stay valid, the earlier explanation of them does not.

**Dashboard changes** (`tools/handrig_dashboard.html`, all three copies identical):
- Removed `THUMB_FLEX_AXIS` and `thumbFlexRad`. This supersedes the decision "thumb bend as twist about a measured axis".
- New: the rotation is split over the two joints. The base gets `q^f`, the tip gets the rest, with `THUMB_BASE_FRAC = 0.5`, because `q^f q^(1-f) = q`. The tip segment ends exactly where the sensor points, about any axis. `f = 0.5` is a guess at how the joints share the bend. Only the tip direction is measured.
- The thumb bend readout is now the total rotation from rest, `2 acos|w|`. It has no direction, so an outward swing also reads as bend. The curl sign control does not apply to the thumb.
- The anchor below the palm and the camera change stay as they were.
- `tools/verify_thumb_rig.mjs` was rewritten. It failed first and passes now: 0.0 % inside the palm for swing up to 90 deg and tip bend up to 90 deg. The other verify scripts pass.
- Browser check with an injected 90 deg bend, no glove: tip direction (0, -1, 0), base (-0.08, -0.71, 0.70), bend reads 90.0, only a favicon 404 from the test server.
- **Not tried on the glove after this change.**

**Re-upload question.** The user asked if code must be re-uploaded. No: the changes are dashboard only. Reload with Ctrl+F5 using the local file, reconnect, recalibrate.

**Lesson.** I trusted a documented sensor position without checking the glove, and recommended a physical move because of it. When the docs and the hardware could disagree, ask the user or look at the glove first. Any statement about where a sensor sits needs a source from the glove, not from the docs.

**New problems.** The joint split of 0.5 is a guess. The readout has no direction. If the thumb tip is on the tip segment, the earlier ML note (curl feature blind to the thumb) still holds, but the cause is the axes, not the flex axis.

---

### 2026-10-31 | Phase 7.5/8: v5 flashed, finger drift found

#### Motion-test videos edited and synced (evening)

**Plan:** cut every motion-test video down to the essential part, with the glove video and the dashboard recording of each test synced, oriented the same way and directly comparable before vs after.
**Achieved:** the result is in `09-firmware-hardening/motion-tests/edited_2026-10-31/` (local only, mp4 is gitignored, about 1.1 GB). Its README lists every trim, sync offset, rotation and crop.
- `clips/`: per test and run, a 1080x1080 real-glove clip and a 1080x1080 dashboard 3D-model clip, trimmed and frame-synced. Cut: calibration countdowns, black and blurry frames (T3 before), a browser context menu (T5 before) and long idle ends. A short still hold stays at the end of each test, because it shows whether the model returns to the rest pose. Hand videos are rotated so the fingers point up.
- `sync/`: side-by-side glove | dashboard per test (T0 to T6 before, T1 to T6 after).
- `picks/`: before-vs-after comparisons for T2 fast fist, T4 spread and T6 mixed fast (9:16 and 4:5 videos plus an end-frame PNG).
- Sync method: cross-correlation of motion energy in the glove video and the dashboard 3D view, then checked by eye on distinct poses.
- Mapping of the after-fix run, found while syncing: screen recording tN = test TN, hand video tN = TN (t1 to t6). The exception is T6: the hand video t6 matches screen recording t7 (offset -0.6 s), not t6. With t6 the model ends curled while the real hand is flat. With t7 both end flat. So t7 is the dashboard recording of the T6 hand video, and screen t6 is another T6 attempt without a hand video. This was found by matching poses on video, not with data.
- What the videos show (visual only): T2 before, the real hand ends open and flat while the model ends with fingers splayed in different directions. T2 after, the model ends flat. T6 before ends with the model's fingers crossed while the hand is flat. T6 after ends flat. T4 before droops, T4 after is flat. T1 before is a weak comparison, because the hand ends clenched.

**Problems:** the after-run hand videos t3 to t6 are blurry and the glove fills the frame. The after-run recordings also predate the mount-angle learner and the tilt fix, so they do not show the final dashboard.
**Next:** no numbers were re-measured. For numbers, record the dashboard CSV on the current dashboard and run `analyze_motion_test.py`.

---

#### What changed today, and why the glove works now

**The symptom.** With v5 flashed, the fingers drifted while held straight. After big or fast moves they did not come back to the rest pose. The pinky worked only some of the time. After the fixes below were flashed and the new dashboard loaded, it works on the glove. That is a visual, qualitative observation. No new CSV has been recorded, so there are no new numbers yet.

There was no single bug. There were four, and a missing safety net on top.

1. **The glove sent 16.7 frames per second, not 50.**
   - Cause: the firmware waited on every Bluetooth write. The link was moving small packets (most likely the default 23-byte MTU), so one 80-byte frame took four packets, at one packet per 15 ms. That is one frame per 60 ms.
   - Why it hurts: gyro integration loses angle when samples are far apart. Even the hand IMU, which never clipped, ended 24 to 35 deg off in two tests.
   - Fix: on connect, the firmware now asks the browser for a 247-byte MTU, 2M PHY, longer packets and a 15 ms interval.
   - Evidence: the serial report now shows `mtu=527 ci_ms=15.0 hz=50.0 tx_fail=0`.
2. **The gyros clipped at ±500 deg/s.**
   - Cause: a fast finger snap goes well past that. In the fast-fist test 11 to 15 % of finger samples sat at the limit, and those fingers ended 43 to 127 deg off.
   - Fix: ±2000 deg/s on all six sensors. Firmware and dashboard scale were changed together.
3. **The dashboard's calibration was wrong by 17 to 27 deg on every sensor.**
   - Cause: it "settled" each filter with 40 small steps that can turn about 92 deg in total. Every sensor starts about 100 deg away (the model's up is +Y, the filter's is +Z). So the model kept moving after every calibration and never sat at zero.
   - Fix: compute the settled orientation directly (shortest rotation from the measured up to +Z).
   - Evidence: it matches a fully converged filter within 0.2 deg.
4. **The pinky's accelerometer has a fixed offset of (0.25, 0.19, -0.17) g.**
   - Cause: its scale is fine (sphere radius 1.005 g), but the zero point is off. That tilted its gravity reading by up to about 20 deg. Its |a| of about 0.75 g also sat right on the dashboard's "bad accel" cutoff, so the sensor was switched off in some tests and not in others. That is the "pinky worked sometimes".
   - Fix: subtract the offset before fusion.
5. **Self-healing on top (all in the dashboard).**
   - Snap-back: when a finger stops, trust the accelerometer more, scaled by how far off it is. It settles in about a second without jitter.
   - Auto re-zero: hand flat and still for about 1 s slides every finger's zero back. This is the only cure for sideways (yaw) drift, because the sensors have no yaw reference.
   - Live gyro-bias tracking, trust flags with the HEALTH readout, and a smoothed 3D display.
   - Evidence (replay of the 7 recorded tests, worst finger at the end): T0 9 to 2.5 deg, T1 16 to 5, T3 15 to 0.8, T5 5.5 to 0.4, T6 94 to 0.5. T2 is unchanged because the hand never held still for a full second at the end of that recording.

**What is still limited.** Yaw has no absolute reference, so only the re-zero fixes it. Fingers spread on a flat palm-down hand get zeroed too. All thresholds are first guesses tuned on the old captures. The motion tests have not been re-run on the fixed system, so the glove is "works by eye", not measured.

---

**Plan:** Compile and flash v5 on the glove for the first time and see how it behaves with the current dashboard.

**Achieved:**
- v5 (`09-firmware-hardening/09_firmware_hardening/09_firmware_hardening.ino`) compiles and is flashed. The Arduino IDE moved the sketch into a subfolder with the same name as the sketch (it requires that), so the folder layout changed.
- Wrote a motion test protocol in `09-firmware-hardening/motion-tests/README.md`. Tests T0 to T6: still baseline, slow fist, fast fist, single fingers, spread, whole-hand rotation, mixed movement then hold. Each test records a hand video, a dashboard screen recording and the dashboard raw CSV. The CSV is the raw sensor frame (g and °/s), so clipping would show as a gyro trace sitting flat at ±500. The CSVs get committed, the videos stay local.
- Decided to run the dashboard's full 20 s calibration before every motion test, not once per session (DECISIONS 2026-10-31). Order per test: ● Record, Calibrate (20 s), clap, 5 s flat, movement, 5 s flat, Stop. The dashboard clears its buffer on Record, so one test is one CSV. The CSV is raw (no bias correction, no remap, no calibration markers), so keeping the calibration hold inside the recording lets the analysis recompute the bias and zero the dashboard used. The clap marks the end of calibration.
- Checked in `tools/handrig_dashboard.html`: `finishCalibration()` re-estimates gyro bias, noise and accel offset per sensor, flags bad sensors (|a| off by more than 0.25 g, bias over 40 °/s, noise over 15 °/s), re-settles each Madgwick filter from the averaged gravity vector and captures a new zero reference.

**Problems:**
- The first compile failed with `'LSM6DS3' does not name a type`. Two libraries ship an `LSM6DS3.h`, and the IDE picked `Arduino_LSM6DS3` instead of `Seeed_Arduino_LSM6DS3` 2.0.7. Fix: uninstall `Arduino_LSM6DS3`. After that it compiled and flashed.
- With v5 and the current dashboard, the fingers drift and tilt by themselves while held straight. Small movements look fine. After big movements the fingers don't return to the rest pose. Nothing is confirmed yet. Suspects:
  - **Gyro clipping.** The finger gyros are at ±500 °/s (`GYRO_CONFIG 0x08`, `GYR_SCALE 65.536` in firmware and dashboard), and the hand LSM6DS3 is at 500 dps too. A fast finger snap can go over 500 °/s. A clipped rate integrates less rotation, so the finger ends up in the wrong place. Accel slowly pulls pitch and roll back, but yaw never comes back. That fits "small is fine, big doesn't return".
  - **Leftover gyro bias** that moves with temperature after the one-time calibration.
  - **Yaw drift.** No magnetometer, so nothing anchors yaw (DECISIONS 2026-07-14).
  - **Weak accel correction.** The dashboard smoothing slider (Madgwick β) defaults to 0.1, range 0.1 to 0.3.
  - **Tape wobble** on a single finger.
- Not tested yet: the v5 recovery paths (SDA-to-GND test, hand IMU re-init). Unverified.
- Recalibrating every test hides bias drift between tests (for example gyro warm-up). T0 and T6 still show drift inside one test. Mitigation: power the glove about 5 minutes before the first calibration (unverified for these sensors).
- If the dashboard flags a sensor after calibration, the calibration is redone before the test starts.

**Motion tests, later the same day (evening).** I ran all seven tests (recorded as t1 to t7, renamed to T0 to T6) with a hand video, a dashboard screen recording and the dashboard CSV each. What I saw: fingers drift and don't return after movement, and the pinky "didn't work in between but at the end it did". Deviations from the protocol: calibration was done before pressing Record (so no 20 s hold in the CSVs, only about 3 s of stillness), no clap, and the hand-axes setting differed between tests (T0 "fwd +X, up -Z", T2 "fwd +Y, up -Z"). Results are in `09-firmware-hardening/motion-tests/README.md`. I wrote two scripts to analyse them: `tools/analyze_motion_test.py` (rate, dropped frames, clipped samples, |a|, return error) and `tools/fit_accel_offsets.py` (sphere fit of accel zero-g offsets).

**Findings:**
1. **Frame rate collapsed.** Six of seven tests ran at 16.5 to 20 Hz instead of 50 Hz (median dt exactly 60 ms). T5 ran at 43 Hz. The dashboard showed RATE 15 to 17 Hz, LOSS 0.0 %, BAD FRAMES 0. Zero loss with a steady 60 ms means the firmware itself only sent a frame every 60 ms, so `bleuart.write()` blocks until the link drains. 60 ms fits an unraised 23 byte MTU (an 80 byte frame is 4 packets) at one packet per 15 ms connection event. **Unverified:** needs the firmware's 2 s serial report line (mtu, hz, write_us, tx_fail). v4 reached about 47 Hz with the same BLE config, so link conditions vary between connections.
2. **Gyro clipping at ±500 °/s confirmed.** T2 fast fist: 84 to 120 clipped samples per finger (11 to 15 % of samples). T6: 13 to 34 per finger. Single samples elsewhere.
3. **Return error** (gyro integrated from the start hold to the end hold, compared with the accel-measured up direction, yaw not included). T0 still: 2 to 4 deg. T1 slow fist: hand 7, thumb 4, index 15, middle 24, ring 37, pinky 30. T2 fast fist: thumb 18, index 127, middle 95, ring 43, pinky 69. T3: middle 29, pinky 25, others 3 to 8. T4: 14 to 25. T5 (43 Hz): 10 to 15. T6: 25 to 35, pinky 78. The hand IMU (LSM6DS3, never clipped) still lost 24 to 35 deg in T4 and T6 at 16.7 Hz, so the low sample rate is a cause on its own, not only clipping. Slow fist already fails (T1), so clipping is not the whole story.
4. **Dashboard calibration bug.** `finishCalibration()` settled each filter with 40 Madgwick steps at beta 1.0, dt 0.02. One step turns at most 2 * beta * dt = 0.04 rad, so 40 steps cover about 92 deg. Every sensor starts about 97 to 109 deg away (viewer "up" is +Y, the Madgwick reference is +Z). Replaying the CSVs left 17 to 27 deg of error in every sensor's zero. The live filter then corrected it slowly, so the model drifted after every calibration and never sat at zero. 100+ steps converge to under 1.6 deg.
5. **Pinky accel zero-g offset.** Sphere fit over all quasi-static samples: pinky centre (0.250, 0.190, -0.165) g, radius 1.005 g, rms 0.014. The other five sensors are within 0.025 g of zero with radius 0.98 to 1.01. So the pinky's scale is fine and its zero point is off. This is the old "pinky reads 25 to 28 % low" item. It tilts the measured gravity direction by up to about 20 deg. It also explains "pinky works sometimes": the dashboard flags a sensor "bad accel" when calibration |a| is off by more than 0.25 g, and the pinky's calibration |a| was 0.74 to 0.82, right at the 0.75 cut, so it was dropped in some tests and not in others. **Unverified:** why the offset exists (the pinky is the only genuine MPU-6050, `WHO_AM_I` 0x68).
6. **Video vs dashboard.** At the end of T2 the real hand is flat, the dashboard shows index pitch 44 deg and yaw -105 deg, middle pitch 58 deg. Yaw is never corrected (6-DOF, no magnetometer). Pitch is corrected by Madgwick at beta 0.1 (about 11 deg/s at most), so it recovers over seconds.
7. **No firmware dropouts** (no all-zero frames) and no accel clipping in any test.
8. **Tried in a replay, not changed:** switching the finger-vs-hand formula from `rel_h^-1 * rel_f` to `(qRef_h^-1 qRef_f)^-1 (q_h^-1 q_f)`, beta 0.3, and removing the deadband. None was a clear win on these captures. Left open (DECISIONS, open).

**Changes (committed and pushed the same day, `e344839` firmware, `cf04ace` dashboard):**
- Firmware `09_firmware_hardening.ino` (compiles: 133312 B flash, 14688 B RAM, `Seeeduino:nrf52:xiaonRF52840Sense`): gyro ±2000 °/s (`GYR_SCALE 16.384`, finger `GYRO_CONFIG 0x18` plus its readback check, hand LSM6DS3 `gyroRange 2000`). `connect_callback` now asks the central for 2M PHY, data length update, MTU 247 and a 15 ms connection interval (non-blocking SoftDevice requests, the central may refuse). The 2 s report line also prints `ci_ms`.
- Dashboard `tools/handrig_dashboard.html` (copied byte-identical to `08-ble-wireless-dashboard/` and `Data/html/`, md5 `0c660afef0af30e9457dab7fa8eada33`): `GYR_SCALE 16.384` to match v5. **Breaking:** this dashboard now reads v4 (stage 08) gyro 4x too large (v4 sends 65.5 counts per deg/s, the dashboard divides by 16.4). Corrected later the same day, it first said "too small". `ACC_OFFSET` per sensor (pinky [0.250, 0.190, -0.165], others 0) subtracted in the raw sensor frame before remap, fusion and calibration checks. The CSV export stays raw. Calibration settle is now a closed form: shortest rotation taking measured up onto +Z, `q = normalise(1+uz, uy, -ux, 0)`, upside-down case handled. Checked against the dashboard's own Madgwick run to convergence: within 0.2 deg including heading. A frame with dt == 0 (same-ms catch-up) now integrates 0 instead of 0.02 s. Not seen in these captures, preventive.
- Verification done: firmware compiles. All existing `verify_*.mjs` and `verify_check_dataset.py` tests pass with the new dashboard. The closed-form settle was compared with the iterative one offline. Not done: flash, link rate, anything on the glove.

**Result of the updated v5 (serial log, 14:15 to 14:17):**
- Before the browser connects: `# link=down hz=50.0 read_us=3906 write_us=0 tx_fail=0 bus_rec=0 stuck=none failing=none`.
- After connecting: `# link=up mtu=527 ci_ms=15.0 hz=50.0 read_us=3906..3925 write_us=0 tx_fail=0 bus_rec=0 stuck=none failing=none`.
- So the loop holds 50 Hz while connected. The central granted a 15 ms interval and offered an MTU of 527, more than the 247 the firmware asked for. No tx failures, no stuck or failing sensors, no bus recoveries. Reading all six sensors takes about 3.9 ms.

**Problems (additional):**
- `write_us=0` while connected is suspicious (unverified). A real notify should take tens of microseconds. It may mean the dashboard had not subscribed to notifications yet, so the firmware skipped the writes. Until the dashboard RATE readout and a recorded CSV show about 50 Hz, the throughput fix is not verified.
- The motion tests were recorded with the wrong order (calibrate before Record), so the bias and zero the dashboard used cannot be recomputed from the CSVs.
- Data recorded before these fixes should not be used for ML training: 17 Hz frames, clipped gyro, off pinky accel and a wrong calibration zero.

**Self-healing dashboard (later the same day).** After the 50 Hz serial line I asked for the dashboard to fix drift on its own, using what the seven test captures showed, and to do it during live viewing so the hand looks smooth. Everything is in a "self-healing" block in `tools/handrig_dashboard.html` (copied byte-identical to `08-ble-wireless-dashboard/` and `Data/html/`, md5 `f1f6480f8a8cac7a6e2a8b99648b366a`). None of it changes the raw CSV.
1. **Stillness detector** per sensor. A sensor is still if its gyro is within max(3 °/s, 4x its calibration noise) of its own recent average on every axis, its accel direction is not creeping (fast average vs slow average differ by under 0.03 g, so a slow steady turn does not count), and |a| is within 0.1 g of 1. Time is measured in seconds of frame time, not frame counts. Counted in frames, "1 s" took 3 s at the 16.7 Hz of the motion tests and short end holds never qualified.
2. **Live gyro-bias tracking.** After 1 s still (and calibrated), the bias moves toward the current reading by 0.002 per frame (about a 10 s time constant at 50 Hz), only for residuals under 1.5 °/s. It fine-tunes warm-up drift and cannot swallow real motion.
3. **Adaptive snap-back.** After 0.2 s still, Madgwick beta rises from the slider value toward 1.0 in proportion to the tilt error (full at 20 deg, 2 deg gives 0.19, 0.5 deg gives about 0.12). A fixed big beta chatters once converged, because Madgwick steps a fixed beta along a normalised gradient. Tilt error is the angle between the filter's predicted up and the smoothed accel. Max correction is 2 * beta rad/s, 115 °/s. The beta slider now sets the user value.
4. **Auto re-zero on a flat hand.** When every non-bad sensor (hand required) has been still for 1 s or more, has tilt error under 2 deg, and its up is within 8 deg of the up it had at calibration, each sensor's zero is slerped toward its current orientation with a 0.4 s time constant (about 95 % in 1.2 s, no visible jump). This removes yaw drift, which a 6-DOF IMU cannot observe. Letter poses are not palm-down flat, so they do not trigger it.
5. **Trust and HEALTH readout.** Each sensor records the time of its last clipped gyro sample (|g| at or above 1990 °/s) and its last dropped frame. A sensor is trusted if neither happened since its last zero (calibration, Zero Orient or auto re-zero). The header has a new HEALTH cell: "—" disconnected, "slow link" under 40 Hz, "re-zero" while auto re-zero runs, "zero? index,pinky" for untrusted sensors, else "OK". Batch Capture now rejects a rep (flashes red, stays armed) if the link is under 40 Hz or any sensor is untrusted. The batch CSV format is unchanged.
6. **Display smoothing.** The drawn palm and finger rotations ease toward the true ones (slerp, 40 ms time constant, frame-rate independent). The fingertip curl uses the same easing. Display only: stored quaternions, cards and exports keep the unsmoothed values.
7. The Connect panel text now says to flash `09-firmware-hardening` (v5) and that v4 gyro reads 4x too large in this dashboard.

Verification so far:
- Replay of all seven motion-test CSVs in a Python port of the pipeline (with ACC_OFFSET and the closed-form settle). Displayed finger-vs-hand angle averaged over the last 1 s, in degrees, thumb/index/middle/ring/pinky, before then with healing:

| Test | Before | With healing |
|---|---|---|
| T0 still | 6.4 / 9.0 / 8.8 / 6.0 / 6.7 | 2.5 / 2.1 / 2.1 / 1.5 / 1.7 |
| T1 slow fist | 1.5 / 5.6 / 7.7 / 15.7 / 11.6 | 0.4 / 1.9 / 2.5 / 4.9 / 3.6 (re-zero still sliding when the CSV ended) |
| T2 fast fist | 26.8 / 106.4 / 70.0 / 78.8 / 162.0 | unchanged (hand never still for a full second at the end) |
| T3 each finger | 5.6 / 9.8 / 4.7 / 1.9 / 14.5 | 0.4 / 0.6 / 0.4 / 0.2 / 0.8 |
| T4 spread | 53.7 / 2.8 / 10.0 / 6.9 / 18.6 | 13.9 / 0.8 / 2.5 / 1.5 / 5.1 |
| T5 hand rotate | 3.4 / 4.1 / 5.5 / 3.3 / 1.3 | 0.4 / 0.1 / 0.4 / 0.4 / 0.3 |
| T6 mixed | 8.1 / 18.0 / 16.8 / 5.4 / 93.7 | 0.4 / 0.3 / 0.4 / 0.3 / 0.5 |

- Synthetic frames through the real dashboard code in a browser, no console errors. Pinky with its offset calibrates to |a| 0.998 and is not flagged. A 40 deg sideways drift on a flat hand fell to 2.2 deg after 2.5 s still (auto re-zero fired). A clipped burst over 2000 °/s (115 deg error) fell to 1.2 deg after 3 s, sensors untrusted after the clip and trusted again after re-zero. A held 90 deg curl stayed at 90 deg for 3 s (no re-zero). A slow 2 °/s turn changed the bias by 0.008 °/s or less.
- Existing `verify_*.mjs` tests: 0 failures.

**Live accel-offset learning and a stricter rep gate (later the same day).** The pinky offset above was a constant from an offline fit. The dashboard now learns it live (`learnAccOffset`, `solve4` in `tools/handrig_dashboard.html`, three copies byte-identical, md5 `08e1b8bf40872c65133454cf94b659da`).
- It is the same sphere fit as `tools/fit_accel_offsets.py`, running while the glove is worn. A sensor counts as "quiet" when its gyro is steady and its accel is not creeping, for 0.5 s. While quiet, one raw accel sample is added every 0.25 s to running sums of the least-squares normal equations (`|a|^2 = 2 a.b + c`, row `(2ax, 2ay, 2az, 1)`). No samples are stored. It refits every 10 samples after the first 60.
- "Quiet" and not "still", because "still" also wants |a| near 1 g, and a sensor with a big unknown offset never shows that.
- The fit is only trusted when the samples cover enough directions (two axes spanning at least 1.0 in unit-vector terms) and it is a clean sphere (radius within 0.05 of 1 g, radial rms under 0.03 g, computed from the sums: SSE = yy - 2 x.v + x.M.x, divided by 2r).
- Once trusted, the offset is applied and saved in the browser (localStorage key `gestura_acc_offset_v1`), so later sessions start from it. The old constants are the defaults. If the offset moves by more than 0.02 g, a status message asks to recalibrate.
- Verified in a browser with synthetic frames: pinky offset wiped to 0, 14 orientations held 5 s each. It learned (0.2512, 0.1906, -0.165) against the true (0.25, 0.19, -0.165), radius 0.9975, rms 0.006, after the 5th orientation. The other five sensors stayed within 0.002 g of zero. The value was saved. **Real-glove behaviour is unverified.** It needs about 15 s of total still time spread over different hand orientations.
- Batch Capture reps now also need every sensor's tilt error under 2 deg (filter settled), so a rep grabbed mid snap-back is rejected.
- Checks: all `verify_*` tests pass, 13/13 dataset checks pass.

**Problems (self-healing):**
- Fingers spread sideways while the hand lies flat palm-down look identical to gravity, so auto re-zero erases that spread too. T4 shows it: the thumb stays at 13.9 deg and the pinky at 5.1 deg after healing.
- T2 (fast fist) is unchanged. The recording ends before the hand is still for a full second, so nothing fires. This is a test-protocol gap, not proof that healing fails there.
- Not verified in numbers on the glove. It looks right by eye (user-observed). The thresholds (8 deg pose, 2 deg tilt, 1 s still, 0.03 g creep) are first guesses tuned on these captures, which were recorded at 17 Hz with ±500 °/s clipping, not on the new firmware.
- **Tried, not kept:** down-weighting the accelerometer when |a| is far from 1 g during fast moves (a standard trick). On the 7 recordings it changed nothing measurable and made the fast-fist index slightly worse (106 to 116 deg). The error in this data comes from clipping and yaw, not from linear acceleration. Revisit with clean 50 Hz, ±2000 deg/s data. See DECISIONS 2026-10-31.

**Next (added, in order):**
- Re-run the motion tests on the fixed system, with at least 3 s of stillness at the end of each.
- Move the hand through many orientations for about 30 s so the offset learner can confirm the pinky value.
- Then start Phase 8 data collection.

**Next (earlier list, still valid):**
0. Try it live. Move fast, lay the hand flat for 1 to 2 s, and watch HEALTH go "re-zero" then "OK". Check the 3D hand looks smooth and not laggy. Then re-run the motion tests with at least 3 s of stillness at the end of each, so the end-of-test numbers can be compared with the table above.
1. Confirm 50 Hz where it counts. Connect the dashboard, check that RATE shows about 50 Hz, record a short CSV and run `python tools/analyze_motion_test.py <csv>` (expect about 50 rows per second, median dt 20 ms). Also check that `write_us` becomes non-zero once the dashboard is subscribed. If the dashboard still shows about 16 Hz, the central or browser is the limit: shrink the frame or try another host (open decision, DECISIONS).
2. Re-run the motion tests with the new firmware and dashboard. Press Record before Calibrate so the 20 s hold is in the CSV, clap at the start, use one hand-axes setting for all tests. Run `python tools/analyze_motion_test.py <csv>` on each (default `--clip 2000`). Success: 50 Hz, 0 clipped, T1 and T2 return error under about 5 deg.
3. Re-fit `ACC_OFFSET` after the re-run, using the T5 hand-rotate CSV, to check the pinky offset is stable.
4. For ML: yaw relative to the hand still drifts by physics. Use gravity-referenced features plus the re-zero pose before each capture (DECISIONS 2026-07-14). Do not train on data recorded before these fixes.
5. Later: the guided calibration routine (open decision). It comes after the re-test, otherwise it calibrates against bad data. Background gyro-bias tracking from this item is done (self-healing block above).

**Hand axes, left model and thumb (later the same day).** After the first live use I reported that there is still some drifting, the fingers keep going off, and the thumb movement looks bad. I asked to make "hand: fwd +X, up -Z" the default, since that is the option I had picked on the glove.
- **Hand axes measured, not guessed.** In T5 (whole-hand rotation, fingers straight) every finger is rigid to the hand, so each finger's gyro is the hand's gyro rotated by a fixed mount rotation. I fitted that rotation (Kabsch on the gyro vectors, 1032 samples) for all four hand-axes options:

| Hand axes | Finger tip direction vs hand forward (thumb / index / middle / ring / pinky) |
|---|---|
| fwd +Y (old default) | 84 / 81 / 88 / 80 / 86 deg |
| fwd -Y | -97 / -99 / -92 / -100 / -94 deg |
| **fwd +X** | **-7 / -9 / -2 / -10 / -4 deg** |
| fwd -X | 174 / 171 / 178 / 170 / 176 deg |

  So fwd +X is correct, and the old default was about 85 deg wrong. With the wrong hand frame, turning the hand shows up as fake finger motion. Also, switching the dropdown resets the hand's calibration (bias zeroed), so anyone who switched and did not recalibrate got an uncorrected hand gyro, which drifts. fwd +X is now the default. The fit residual is 0.20 to 0.30 (relative), so the angles are good to a few degrees. Measured on the 43 Hz T5 capture, before the firmware fixes.
- **Model hand defaults to left.** The 3D model was drawn as a right hand, thumb on the wrong side for this glove, so thumb spread swung the wrong way. The left option already existed (mirrored geometry, see the comment in the dashboard). It is now the default. The display setting's storage key moved to `gestura_display_v2` so an old saved "right" is not reused. The curl sign resets to "|pitch|" once because of that.
- **Heading alignment at calibration.** Gravity fixes each filter's tilt, but not its heading. The closed-form settle gives each sensor whatever heading the shortest rotation happens to give, which differs per sensor when a sensor sits rolled or tilted (thumb 13 to 21 deg off the hand's tilt at rest, pinky 25 to 27). `q_rel` only cancels whole-hand motion if all filters share one heading, otherwise tilting the hand moves the fingers on screen. After calibration, each finger filter is now turned about world up until its tip points the same horizontal direction as the hand's (`alignHeadings()` in `tools/handrig_dashboard.html`). Tilt is untouched (checked: 0.0000 deg change, heading difference 21.8 to 0 deg in a unit check).
- Replay on T5 (fingers should stay at 0 while the hand turns), 90th percentile finger-vs-hand angle, thumb / index / middle / ring / pinky: before 15.1 / 17.6 / 19.4 / 20.7 / 27.7 deg, with alignment 12.2 / 16.3 / 17.0 / 19.0 / 21.7 deg. A modest gain. Most of the remaining error in that capture is gyro integration at 43 Hz with ±500 °/s, which the firmware fix addresses. The other formula from the open decision (`(qRef_h^-1 qRef_f)^-1 (q_h^-1 q_f)`) was worse on T5 (thumb p90 18.9), so it stays open with (a).
- Checks: all `verify_*.mjs` tests pass, the page script parses, three copies byte-identical (md5 `a9db16398be6d8559ff1e49e60452ccf`). **Not verified on the glove.**
- What this does not fix: sideways (yaw) drift between re-zeros is physics (no magnetometer). The thumb has one IMU on the proximal phalanx, so the model can only show that segment's rotation. The tip bend is cosmetic.

**Hand IMU mount angle learned live (later the same day).** The XIAO (hand IMU) is held on by velcro and double-sided tape. It comes off and goes back on, so its orientation on the hand changes between sessions. It always sits flat on the back of the hand, but it can be straight, sideways or anywhere in between. A fixed hand-axes setting can't follow that. With the hand frame turned, a hand pitch reads as part pitch and part roll, so the finger-vs-hand math stops cancelling whole-hand motion and the fingers move on screen when only the hand moved.
- **Fix:** the dashboard learns the mount angle psi (rotation of the XIAO about the hand's up axis) from the gyros (`learnMount()` in `tools/handrig_dashboard.html`). When the whole hand turns with the fingers straight, the mean gyro of index to pinky equals the hand gyro turned by psi. The least-squares psi has a closed form: `psi = atan2(sum(hz fx - hx fz), sum(hx fx + hz fz))` over the in-plane (x, z) parts.
- **Gating:** a sample counts only if the hand turns faster than 60 °/s, the four fingers agree with each other (within 30 %) and with the hand in size (ratio 0.7 to 1.3), and nothing clips. Fists and single-finger moves fail that, so finger motion can't teach a wrong angle. The thumb is left out. The sums fade over 20 s, so a re-stuck XIAO is picked up. About 1 s of turning is enough.
- **Applied at the output only:** bias, calibration, fusion and self-healing stay in the sensor frame. The hand's relative rotation is re-expressed in the hand frame, `rel_h' = M rel_h M^-1` with `M = Ry(psi)`. The angle is saved in the browser (`gestura_hand_mount_v1`) as the starting guess for the next session. Heading alignment now uses the hand's true forward and works on the zero pose (`qRef`), turning both the filter and its zero, so it can run at any time without moving the picture. It also runs during auto re-zero.
- **Visible check:** after calibration the status line asks to tilt and roll the whole hand for about 2 s. HEALTH shows "turn hand" until the angle has been checked once this session, then "hand IMU mount checked" or "updated: X°". Batch Capture rejects reps until then, so training data can't be recorded with an unchecked mount.
- **Evidence:** offline on T5 with the hand data turned by 0/35/90/180 deg, the learner recovered 4/39/94/-176 deg (the extra ~4 deg is how the XIAO sat that day), stable within ±3 deg once learned. On T0 to T4 and T6 (still, fists, single fingers, spread) it never triggered. In the browser with synthetic frames (XIAO turned by 0, 70, 180 deg, hand tilting and rolling at 120 °/s, fingers rigid): it learned exactly 0, 70, 180 deg. Finger-vs-hand error before learning was up to 0 / 74 / 134 deg, after learning 0 / 0.4 / 0.3 deg. No console errors, all `verify_*.mjs` tests pass. Copies byte-identical, md5 `a0c86fffc01531207d7425f8e1db8b0b`.
- **Not covered:** a XIAO stuck on upside down or tilted out of the hand plane. A small tilt is absorbed by the calibration zero. **Not verified on the glove.**

**Hand IMU tilt measured at calibration, hand-axes picker removed (later the same day).** On the glove the whole 3D hand moved wrong. I tested three moves from a flat, calibrated hand: tipping the fingertips up made the 3D hand swing sideways, turning the hand 90 deg left made it tip up or down, and roll looked correct. I asked for that mapping to be fixed and to be the only option.
- **Cause:** up/down and left/right swapped with roll intact is exactly what a hand frame rolled 90 deg about the forward axis does: the dashboard has the XIAO's "up" axis wrong. That happens when the XIAO goes back on tipped (for example on its edge) instead of flat. The fixed remap assumes sensor -Z is up. The in-plane learner from earlier today only covers a XIAO that lies flat. Nothing compared the XIAO's measured up with the fingers' measured up, so calibration accepted it silently. **The real mount was not checked by eye or in a capture.** The diagnosis comes from the symptom pattern.
- **Fix:** instead of hard-coding a 90 deg swap, which breaks again at the next remount, every calibration now measures the tilt. The XIAO's measured up `u_h` (its own frame) is compared with the mean measured up of index to pinky `u_f`. `mountT` is the shortest rotation taking `u_h` onto `u_f` (`setMountTilt()`, closed form `normalise(1 + u_h.u_f, u_h x u_f)`). The in-plane angle psi is then learned from the gyros as before, on the tilted-back data. The full mount is `M = Ry(psi) mountT`, applied to the hand's relative rotation (`rel_h' = M rel_h M^-1`). Together this covers any mount: flat, turned, tipped or upside down. If the tilt is over 15 deg, the status line says so ("XIAO sits tipped 90°, corrected").
- **Only one option:** the hand-axes dropdown is gone. The hand has one base remap (fwd +X, up -Z), and the actual mount is measured on top of it. The other remaps (fwd +Y, -Y, -X, raw) are deleted. The saved angle moved to `gestura_hand_mount_v2`, since psi is now measured after the tilt correction.
- **Evidence (browser, synthetic frames, fingers rigid, hand tilting and rolling at 120 °/s):**

| XIAO mount (turn / tip) | Tip measured | Palm vs real hand after a 30 deg pitch up, before any turning | Fingers vs hand after learning | psi learned |
|---|---|---|---|---|
| 0 / 0 deg | 0 deg | 1.2 deg | 0 deg | 0 deg |
| 0 / 90 deg (your case) | 90 deg | 1.2 deg | 0.3 deg | 0 deg |
| 0 / -90 deg | 90 deg | 1.2 deg | 0.3 deg | 0 deg |
| 40 / 90 deg | 90 deg | 20 deg (turn not learned yet) | 0.4 deg | 40 deg |
| 25 / 0 deg | 0 deg | 12.7 deg (turn not learned yet) | 0.3 deg | 25 deg |

  The palm matched the real hand within 2.4 deg in every case after learning. A tipped XIAO is fixed immediately at calibration. A turned one needs about 2 s of turning the hand. All `verify_*.mjs` tests pass, no console errors, copies byte-identical (md5 `a8c4ec4ad9277e1e109ccacf749f4fa5`). **Not verified on the glove.**
- **Limit:** the tilt fix assumes the hand is flat with straight fingers during calibration. That is the calibration pose, so it holds as long as calibration is done properly.

**Motion tests re-run after the fixes (afternoon, videos only).** I re-ran the motion tests on the fixed system and saved them as the "after" set: 8 dashboard screen recordings (t0 to t7) and 6 real-hand videos (t1 to t6). They are logged in `09-firmware-hardening/motion-tests/README.md` ("Second run, after the fixes") and stored locally in `09-firmware-hardening/motion-tests/after-fix_2026-10-31/` (gitignored, about 286 MB). No CSVs were recorded, so there are no numbers, and the mapping of t0 to t7 onto T0 to T6 isn't recorded. From the file times, the recordings came before the mount-angle learner and the tilt fix, so they don't show the final dashboard (unverified).

**Ideas raised today, not built yet:**
- Keep sideways spread on a flat hand. Auto re-zero erases it (T4). Option: only re-zero yaw for fingers that were straight at calibration, or skip re-zero while the spread gesture is active. Needs the re-run data first.
- Revisit accel down-weighting during fast moves once there is clean 50 Hz, ±2000 °/s data (rejected for now, DECISIONS 2026-10-31).
- If a browser refuses the link requests and the rate stays near 17 Hz: shrink the frame or send fewer sensors per frame (open decision, DECISIONS).
- Hardware watchdog for a stuck SCL line (open decision).
- Find out why the pinky has its offset at all. It is the only genuine MPU-6050 (`WHO_AM_I` 0x68). Unverified.
- Re-tune the healing thresholds (1 s still, 2 deg tilt, 8 deg pose, 0.03 g creep) on the re-run data. They were tuned on 17 Hz, clipped captures.

**Known loose ends:**
- Two comments in `09_firmware_hardening.ino` are stale: the header says the frame works with either dashboard (the gyro scale changed, so the v4 dashboard reads v5 gyro 4x too small, and this dashboard reads v4 gyro 4x too large), and the MTU comment says the firmware never requests an MTU exchange (it now does). Code is correct, comments are not.
- The thumb's tip bend in the model follows the pitch of its one IMU, like the fingers. Thumb flexion across the palm is mostly a sideways rotation, so the bend may look off for the thumb. Display only. Revisit if it looks wrong on video.
- Before and after per test, with an empty column for the re-run: `09-firmware-hardening/motion-tests/README.md`, "Before and after the fixes".
- The motion-test folder is split into two sibling folders: `before-fix_2026-10-31/` (first run: 7 CSVs and videos, moved there from the folder root) and `after-fix_2026-10-31/` (second run, videos only). The `Data/csv/` mirror names are unchanged.

---

### 2026-10-31 | Docs pass: public ledger, plan and decision log

**Plan:** Bring the docs in line with reality and make the repo readable for someone seeing it for the first time.

**Achieved:**
- GENERAL_PLAN.md, DOCUMENTATION.md and DECISIONS.md are now tracked and public. Before this they were gitignored, so nobody on GitHub could see the actual engineering record.
- Fixed the phase status. Phase 7.5 had said "v3 not yet reflashed", but v4 has been streaming live since 2026-08-07. Phase 4 still described the first `delay(20)` sketch.
- Fixed a merged DECISIONS entry (the readback/watchdog decision had lost its heading) and added open decisions: the watchdog, the numpy pin and samples per letter.
- Replaced pre-reorg paths (`firmware/…`, `data/phase…`, `docs/media/…`) with the current stage folders, in the docs and in code comments.
- Rewrote the README for a first-time reader.

**Problems:** The Phase 8 drop-in folder from 2026-08-13 (`data/phase8_labelled_gestures/`) didn't survive the folder reorg. Its README now lives at `ml/future-data-collection-plan.md`. Exports will go in `ml/dataset/`, where `ml/**/*.csv` is already gitignored.

**Next:** The glove. Compile and flash v5, then work through the next-steps list in GENERAL_PLAN.md.

---

### 2026-10-19 | Phase 8/9 prep: dataset checker, kNN baseline, drift tool, v5 firmware (no hardware)

**Plan:** Do the work that doesn't need the glove: a quality gate for batch exports, a baseline classifier, the Phase 5 drift A/B tool, version pinning, and the firmware recovery bugs from the 2026-10-06 review.

**Achieved:**
- **`tools/check_dataset.py`** (+ `batch_io.py` loader). Fails on:
  - pre-2026-10-06 exports (not hand-relative)
  - NaN
  - quaternions that aren't unit length or have `qw < 0`
  - a sensor not reading ~1 g
  - raw values identical to the previous rep (frozen register)
  - duplicate rows
  
  It also prints a letters × sessions coverage table. `verify_check_dataset.py` plants each fault in synthetic data: **13/13 caught**.
- **`tools/make_synthetic_batch.py`**: fake exports in the exact format, with 10 rough letter shapes, random hand tilt and a per-session yaw error. Every file is marked `# SYNTHETIC` and the checker warns about it.
- **`tools/train_baseline.py`**: kNN on three feature sets. `quat` is the raw `q_rel`, `dir` is the finger direction in the hand frame, `curl` is only the palm-ward part. Synthetic only, not a glove result:
  - A random split scores 100 % at every yaw error, which shows how optimistic it is.
  - Leave-one-session-out for `quat` drops 100 → 96 → 87 % as yaw error goes 0 → 10 → 25°.
  - `curl` holds ~90 % but can never split U from V.
  
  That's the 2026-07-14 yaw tradeoff, now measurable.
- **`tools/analyze_drift.py`** fits a line instead of comparing the first and last sample, and has `--compare` for the bias on/off pair. Re-running the old capture corrected a number: finger 1 roll drift was 1.70 °/min by endpoints and **0.01** by line fit. Roll/pitch are all ≤ 0.35 °/min now, yaw is 0.03–2.2.
- **Toolchain versions** added to every stage README: Seeed nRF52 Boards 1.1.13, LSM6DS3 lib 2.0.7, MPU6050_light 1.2.1.
- **`09-firmware-hardening/` (v5):**
  - runtime I²C bus recovery
  - hand IMU re-init (the old loop started at sensor 1)
  - a hand read that can actually report failure
  - checked `bleuart.write()`
  - re-init for sensors whose reads keep failing
  - the MTU on the report line
  
  The BLE frame is unchanged.
- Reading the core's source showed two things. First, the hand IMU is on **Wire1**, not the finger bus, so v4's `tcaDisable()` before each hand read did nothing. Second, with SDA stuck low the nRF52 sees every ACK, so a jammed bus reads as zeros, not errors. The bus check now uses "all six axes exactly 0".
- Later the same day:
  - Firmware fixes 14–16: the full name in the scan response, the MTU logged from the exchange event, and `loop()` sleeping in `delay()` instead of spinning.
  - The dashboard got display options for the curl sign and for a left vs. right model hand. Both are display-only. Export and noise-check output is identical in every mode (checked in headless Chromium).
  - `verify_*.mjs`: 24/24 pass.

**Problems:**
- v5 is **not compiled or flashed**. An `arduino-cli` build stalled in library detection, and the retry was stopped when the machine ran low on memory.
- A stuck SCL hangs the nRF52 `Wire` driver forever, so only a hardware watchdog can recover from it. That's an open decision.
- `requirements.txt` pins numpy 2.2.6, but the scripts were tested on 2.5.3.
- The coverage target is read two ways: 90 per letter in the plan, 30 in the dashboard.

**Next:** Compile and flash v5 and run its test plan. On the dashboard, set the hand axes, curl sign and model hand on the glove. Then the first real Phase 8 session.

---

### 2026-10-06 | Phase 8: dashboard redesign and bug sweep

**Plan:** Redesign `tools/handrig_dashboard.html` as a clean black-and-white UI, and hunt for bugs across the code.

**Achieved:**
- **Redesign:** monochrome, 1 px lines, one monospace font, no gradients or shadows. State never depends on colour: ● LIVE / ○ NO DATA / ▲ CHECK / ▲ FAULT. X/Y/Z are solid/dashed/dotted everywhere. The 3D hand is a hidden-line wireframe. Checked at 1440, 820 and 390 px.
- **Document hygiene:** proper doctype (it was rendering in quirks mode), one font request instead of three, an SRI hash on Three.js r128, and a clear error if the library fails to load.
- **Bugs fixed (17):**
  - Reconnecting kept stale buffers, which showed a false loss %.
  - Listeners were added after notifications started, so the first packets were lost.
  - A failed connect left the GATT link up behind a "Connect" button.
  - Recording and calibration survived a disconnect.
  - A dropout latch froze a finger until recalibration.
  - Changing the hand axes kept a bias measured in the old frame.
  - Calibration finished on `requestAnimationFrame`, so it stalled in a hidden tab.
  - One exception in the refresh loop froze the UI.
  - The stuck detector was off by one (49 frames vs. 50).
  - A NaN could poison the filter.
  - **The big one: batch export wrote each sensor against its own zero instead of the hand-relative quaternion. Tilting the hand changed the finger features in the training data.** It now exports `conj(q_hand) ⊗ q_finger` with `w ≥ 0`, and the storage key was bumped so old and new rows can't mix.
- **Evidence:** the three `verify_*.mjs` scripts pass (24 checks). A headless-Chromium harness feeds synthetic 80-byte frames through the real parser and mocks `navigator.bluetooth`: 26 behaviour checks and 22 connection-flow checks pass.
- "Before" screenshot: `docs/media/dashboard-before.png`.

**Problems:**
- Not tested on the glove. Everything ran against synthetic frames and a mocked Bluetooth stack.
- Curl uses `|pitch|`. Which pitch sign means "curl" hasn't been measured.
- The model is a right hand (thumb at +X), but the glove is a left hand. Spread may look mirrored.
- Firmware bugs found but not fixed here, since they need a reflash. They became v5 (2026-10-19).

**Next:** Connect the real glove, calibrate, and check the curl sign and the thumb side. Take an "after" screenshot.

---

### 2026-08-13 | Phase 8: letter coverage grid and data folder

**Plan:** Show A–Z coverage in the dashboard and set up a folder and naming rule for exports.

**Achieved:**
- An A–Z grid on the 3D stage. Each letter shows its rep count and turns "done" at 30. It refreshes from the same function as the batch counter, so the two can't disagree.
- A drop-in folder and naming rule: `handrig_batch_<letter>_<session#>_<timestamp>.csv`.
- `tools/verify_batch_persist_js.mjs` covers the localStorage round trip and the grid math: 12/12 pass.

**Problems:** None. UI and tooling only.

**Next:** A real labelling session on the glove.

---

### 2026-08-12 | Phase 8: batch capture survives a crash

**Plan:** A tab crash between exports would lose every rep since the last one. For a 30+ rep session that's the biggest risk to collection.

**Achieved:**
- Batch rows are mirrored into localStorage after every capture and restored on page load.
- The backup is cleared once the CSV is exported.
- Labels are uppercased at capture time.

**Problems:** None.

**Next:** The coverage grid and the drop-in folder.

---

### 2026-08-11 | Phase 7.5: Batch Capture needs a GO noise check first

**Plan:** Make it impossible to collect training data before the noise floor has passed this session.

**Achieved:**
- `window.BatchGate`, a small state machine. A GO from the noise check unlocks Batch Capture until the next disconnect.
- A later NO-GO doesn't undo an earlier GO.
- The capture function re-checks the gate itself.
- Merged as two PRs to keep the diffs reviewable.
- `tools/verify_batch_gate_js.mjs`: 8/8 pass.

**Problems:** None.

**Next:** Keep the GO result across page reloads.

---

### 2026-08-10 | Phase 7.5: noise check moved into the dashboard

**Plan:** Port the GO/NO-GO checks from `tools/analyze_noise_baseline.py` into the browser, so a recording can be checked without exporting it first.

**Achieved:**
- `nbAnalyze(frames)`, pure math with no DOM or BLE. It checks dropped and stuck frames, per-sensor gyro bias and noise, and a 50 s minimum length.
- The thresholds are named constants copied from calibration, so the two can't drift apart.
- A "Noise Check" button shows a GO/NO-GO overlay with the same per-sensor breakdown as the Python script.
- `tools/verify_noise_baseline_js.mjs` tests three synthetic cases:
  - a clean 60 s capture → GO
  - a bit-identical capture → NO-GO
  - a 5 s capture → NO-GO

**Problems:** None. The only trap was the column order, which I checked against the parser's loop.

**Next:** Run a real 60 s still capture through both the browser and Python checks and confirm they agree.

---

### 2026-08-09 | Pre-Phase-8 checks (2/2): capture length

**Plan:** The noise baseline needs a 60 s still hold, but the script never checked how long the capture actually was.

**Achieved:** Under 50 s now forces NO-GO, however clean the stats look. Verified with a 10 s capture (now NO-GO, before it was a false GO) and a 60 s capture (still GO).

**Problems:** None.

**Next:** Run the full checklist on the glove.

---

### 2026-08-09 | Pre-Phase-8 checks (1/2): real exit code

**Plan:** `analyze_noise_baseline.py` must "print GO" before collection, but it always exited 0. The rule depended on someone reading the output correctly.

**Achieved:** It exits 0 on GO and 1 on NO-GO, so the gate can be scripted. Verified with a clean synthetic capture and a stuck one.

**Problems:** None.

**Next:** Check the capture length too.

---

### 2026-08-08 | Live dashboard: thumb geometry and calibration gate fix

**Plan:** Fix two bugs seen while wearing the glove. The 3D thumb looked wrong, and every finger showed a fixed 20–29° pitch right after calibration, even though the hand didn't move.

**Achieved:**
- **Thumb, four iterations.** I checked each one with coordinate math in a scratch Node script after the first guesses failed:
  1. The bend rotated about X, which lifted the thumb out of the hand's plane.
  2. Switched to Y, but with the sign backwards, so it flared away from the index.
  3. The anchor sat inside the solid palm box, so most of the segment was hidden.
  4. A two-axis kink cleared the box at the endpoint, but a 200-step walk along the segment found 22.8 % still buried.
  
  The final version is a straight segment anchored outside the box, with 7.5 % clipping at the tip only. See DECISIONS.md.
- **Calibration gate.** The pitch offset came from motion at the start of the 10 s hold getting averaged in.
  - My first fix rejected samples with raw gyro above 6 °/s. **That was a regression.** A still MPU-6050 reads its own bias, not zero, and the pinky's bias is over 6 °/s. It never got 5 good samples, stayed uncalibrated, and showed −105° roll on a still hand.
  - The real fix gates on deviation from each sensor's own rolling average.

**Problems:** Debugging 3D geometry from phone screenshots is slow. Several plausible fixes covered the wrong failure mode. Doing the math first is the default from now on. Also, before filtering on a threshold, check whether the value has a real non-zero baseline.

**Next:** Verify the thumb and the calibration gate on the glove across several calibrations, including moving on purpose during the hold.

---

### 2026-08-07 | Dashboard renamed Gestura, visual pass

**Plan:** A visual pass on the dashboard now that it's stable enough to demo.

**Achieved:**
- Renamed from "HandRig" to Gestura, the public product name. See DECISIONS.md.
- A copper brand palette driven from one token object, so CSS and the 3D scene can't drift apart.
- Redesigned the telemetry and finger cards.
- Fixed an invisible bar track and a grid-row clipping bug.
- BLE parsing, calibration and gesture logic are unchanged. The palette was later replaced by the monochrome redesign on 2026-10-06.

**Problems:** About 440 lines of CSS/JS. Real UI fixes and pure rebranding went into one change instead of two. Not re-checked on the glove after the restyle.

**Next:** Open it against the live glove and check that nothing broke under real data.

---

### 2026-08-07 | Phase 7.5: calibration settle fixed properly, curl readout, first gesture rule

**Plan:** Confirm the earlier settle fix, and add the missing curl readout and thumb fix.

**Achieved:**
- **The calibration settle bug was actually fixed this time.**
  - The hand model kept rotating slowly even with the glove dead still.
  - Waiting a fixed time after resetting the filter (600 ms, then 2.5 s) can't work, because convergence time depends on the smoothing slider and the pose.
  - `finishCalibration()` now runs `Madgwick.update()` ~40 times on the calibration gravity vector with β = 1 and grabs the reference immediately. **Confirmed working on the glove.**
- **Accel low-pass before fusion.** Raw accel noise (~0.02 g) was nudging the orientation every frame. An EMA on the accel input fixes it without adding lag to the output.
- **Accel shown relative to calibration.** Cards show `raw − accBias`. The filter still gets raw accel, because it needs gravity.
- **Curl readout per finger:** a bar, a percentage and a label, from the same relative pitch that drives the model.
- **Thumb rig fix.** The render loop was overwriting the static rest pose every frame. The rig is now split into a static parent and a live child.
- **First gesture rule**, on request: thumb bent up against the index. It's a threshold on the 3D rig's geometry, not ML. The thresholds are guesses.

**Problems:**
- The settle bug took two sessions and two wrong fixes. A fixed wait for a process whose speed depends on user settings is a gamble, not a fix.
- The pinky accel issue is still open.
- Only the settle fix was confirmed on the glove. The accel smoothing, curl readout, thumb fix and gesture rule are implemented but unverified.

**Next:** Test the unverified items on the glove. Inspect the pinky solder joint.

---

### 2026-08-07 | Phase 7.5: first live BLE session on the glove

**Plan:** Flash v4 and get a live BLE session working end to end. This was the first time the hardened firmware touched the glove.

**Achieved:**
- **BLE throughput collapse found and fixed.** The dashboard sat at 0 Hz with bad frames climbing.
  - The serial report line made it obvious. `read_us` (all six sensors) stayed flat at ~5.9 ms, while `write_us` (inside `bleuart.write()`) grew past 114,000 µs and `hz` fell from 50 to 8.3.
  - The sensors were never the problem. The BLE link was starved.
  - Fixed with `Bluefruit.configPrphBandwidth(BANDWIDTH_MAX)`, a relaxed connection interval (12, 24), and callbacks that log the MTU and interval.
  - **Confirmed live: ~47 Hz / 3.7 KB/s.**
- **Calibration settle, first attempt:** the wait went from 600 ms to 2.5 s. Not confirmed. It was replaced later the same day by the real fix above.
- **New issues from the live session:**
  1. **Pinky accel reads 25–28 % low** (`|a|` ≈ 0.72–0.77 g where 1.00 g is expected) in every pose. The per-axis ratios don't match one simple failure. The dashboard flags it `bad accel` and freezes that finger instead of drawing garbage. It's intermittent.
  2. **The thumb doesn't point sideways at rest.** The suspect is the cosmetic rest yaw fighting the real sensor rotation. Fixed later that day.
  3. **The hand drifts on its own when tilted palm-down.** It could be the same settle issue or a real weakness of Madgwick near vertical. Not separated yet.
  4. No curl readout yet. Added later that day.

**Problems:** Several new problems showed up at once. I avoided guess-fixing them all in one pass and kept them separate for controlled retests.

**Next:** Controlled tilt-drift test (flat vs. tilted, known β). Fix the thumb rest pose. Add the curl readout. Check the pinky wiring.

---

### 2026-07-25 | Phase 7.5: hardening the IMU path (v4) and the axis remap

**Plan:** Review the v3 fix before reflashing. It started with "would new IMUs fix the bad readings?" The answer is no: the chips are fine, the init was wrong.

**Achieved:**
- **New hardware wouldn't help.** Replacements from the same market would be the same 0x72 clones with the same bug. "Replace the part" was the tempting wrong answer.
- **`08-ble-wireless-dashboard/08_ble_dashboard.ino` rewritten as v4.** v3 wrote the right registers but ignored every `wReg()` return, so a NACK looked like success. That includes a NACKed mux select, which configures the wrong finger. v4 adds:
  - **Config readback:** `PWR_MGMT_1/2`, `GYRO_CONFIG` and `ACCEL_CONFIG` are read back and compared. An ACK proves something answered. A readback proves the chip stored the value.
  - **Runtime stuck watchdog:** 50 bit-identical frames (~1 s) means frozen. At ±4 g one LSB is 122 µg against ~20 LSB of noise, so a live sensor can't repeat exactly. That's stronger than the `|a| ≈ 1 g` check, **which the original stuck thumb passed.**
  - **A full reset for the 6500 family:** poll `DEVICE_RESET` until it clears, then signal path reset and `ACCEL_CONFIG_2`. That register is reserved on a genuine 6050, so one sequence serves both chips.
  - **Checked writes and mux selects**, 3× init retry, and **bus recovery** (9 clocks + STOP) for a slave holding SDA low.
  - **An honest validity mask.** v3 sent zeros with the valid bit still set, which told the filter that gravity had vanished.
  - **A frame checksum** (79 → 80 bytes). `0xAB` shows up inside the payload constantly, so one dropped byte could false-sync the parser.
  - Fixed `whoami[]` being indexed by mux channel instead of sensor id.
- **Axis remap implemented in the dashboard.** Fingers use the measured `(x, y, z) → (x, z, −y)`. For the hand, only "up = `−Z`" was measured, so the four valid options are in a dropdown. All remaps are proper rotations, so the gyro and accel use the same matrix.
- The dashboard validates the checksum, counts rejected frames, skips masked sensors, and calibrates bias in the remapped frame. CSV export stays in the raw sensor frame.

**Problems:**
- **None of this ran on hardware.** That's the same state v3 was left in. Two unverified versions stacked up, and that's worth saying plainly.
- The hand remap default is a guess and will probably need the dropdown.
- The 50-frame threshold and 2 s recovery interval are reasoned, not tuned.
- v4 firmware and the new dashboard must be used together because of the frame length change.

**Next:** Flash v4, read the boot diagnostic with the glove flat and still, and confirm 6/6 `OK`. Then connect the dashboard and set the hand axes.

---

### 2026-07-19 | Phase 7.5: BLE dashboard, and the clone-IMU init bug

**Plan:** With everything on the glove, stream all six IMUs over BLE and render the hand live in a browser, to prove the whole chain end to end.

**Achieved:**
- First BLE sketch: Nordic UART service, 79-byte binary frames, ~50 Hz. Plus `tools/handrig_dashboard.html`: a Three.js hand, live traces per sensor, and 10 s in-browser calibration.
- Got live data, but **4 of 5 fingers were garbage**, either flailing or frozen. I exported two CSVs ([`08-ble-wireless-dashboard/`](08-ble-wireless-dashboard/)) and went through them numerically instead of guessing:
  - `thumb_gx` stuck at exactly `246.0938` on every row.
  - `middle_ay` stuck at exactly `1.9688`.
  - `ring_gx` stepping by exactly `±0x2000` LSB per frame.
  
  Those are digital artifacts, not noise. Only the hand and the pinky were clean.
- **Root cause:** the four bad fingers are MPU-6500/9250 clones (`WHO_AM_I = 0x72`), and `MPU6050_light` never writes `PWR_MGMT_2`, so they boot half-awake. The pinky is a genuine 0x68.
- **Fix:** a raw-register driver (reset → wake → enable all axes → configure), plus a boot diagnostic that prints each channel's health within 2 s. That's v3.
- Confirmed the mux map on the glove: thumb = ch0, pinky = ch4.
- Measured the mounting axes. On the fingers, `−Y` points to the fingertip and `+Z` points up. The hand IMU reads `az ≈ −0.98 g` lying flat, so its Z is flipped compared to the fingers.
- Ruled out the tape. It's non-conductive and can't freeze a register, though it can still cause intermittent dropouts by straining wires.

**Problems:**
- It looked like a fusion or calibration problem ("garbage no matter how I calibrate"). The real fault was two layers below, in the I²C init. Lesson: when calibration "does nothing", check whether the raw bytes are real.
- The axis remap was designed but not implemented.
- v3 was written but not flashed this session.

**Next:** Flash v3, read the boot diagnostic, then implement the axis remap.

---

### 2026-07-18 | Phase 7: everything on the glove, 30-minute wear test

**Plan:** Mount the XIAO and mux on the glove, wire all five fingers with strain relief, and re-run the six-IMU sketch.

**Achieved:**
- All five finger sensors taped on: middle phalanx, and proximal phalanx for the thumb.
- The XIAO, mux and a mini breadboard as a wiring hub went on the wrist strap.
- **All six IMUs power up and read live on the glove.** Each finger module's LED is on and serial data streams. Photos in [`07-full-glove-assembly/`](07-full-glove-assembly/).
- **30-minute wear test passed.** Continuous data, no connection drop. I took the glove off and on several times during the test, which re-flexes every knuckle and re-seats every jumper. That's harder than one continuous wear. **Phase 7 closed.**

**Problems:**
- No capture file was saved from the wear test. It was watched live in the serial monitor.
- The wires are loose jumpers, not taped at every knuckle the way `hardware/WIRING.md` says. Surviving 30 minutes is a good sign, but fatigue builds over many sessions.
- The mux channel map wasn't re-checked against this exact wiring. That was done on 2026-07-19.

**Next:** Strain relief at every knuckle. Save a capture from the glove. Then build a wireless live view.

---

### 2026-07-17 | Phase 5: plot fix, mount angles explained, finger 5 anomaly

**Plan:** Plot the two Phase 5 captures as roll/pitch/yaw, and work out why the hand reads so differently from the fingers on the same breadboard.

**Achieved:**
- **Wrote `tools/plot_fusion.py`.** The first version plotted `millis` as roll (45,000° over 30 s). I fixed the column index.
- **The hand-vs-finger gap is mounting, not a fault.** The finger modules stand upright on their pins and the XIAO lies flat, so gravity lands on a different axis for each. A fixed +90° rotation about each finger's Y (checked with quaternion math) lines up fingers 1–4 with the hand, leaving 9–16° of real tilt.
- **Finger 5 doesn't line up** (yaw stays near 56°). Together with its higher gyro noise, that points to it sitting at a different angle in its slot.
- The correction is in `plot_fusion.py` (opt out with `--no-mount-correction`) and labelled as a visual aid only. Regenerated plots are in [`05-madgwick-fusion/`](05-madgwick-fusion/).

**Problems:** The plotting bug was caught before it reached the docs. The mount-angle theory comes from the data, not from measuring the rig.

**Next:** Check finger 5's seating, then mount on the glove at known angles.

---

### 2026-07-17 | Phase 5 second pass: seeded filter, two-stage β, first drift data

**Plan:** Improve the fusion sketch, then bench-test it with a still drift capture and a movement capture.

**Achieved:**
- **`05-madgwick-fusion/05_madgwick_fusion.ino`:**
  - Each filter is seeded from its own calibration accel (`quatFromAccel()`).
  - Two-stage β: 2.0 for 1.5 s, then 0.033.
  - The output grew to `millis,sensor_id,qw,qx,qy,qz,roll,pitch,yaw` with an optional raw tail.
- **Two bench captures** in [`05-madgwick-fusion/`](05-madgwick-fusion/), analysed with the new `tools/analyze_drift.py`:
  - `capture_01_movement.csv` (~29.5 s): fusion stays stable under motion. No NaNs, no stuck values.
  - `capture_02_drift.csv` (~31.5 s, still): the drift test.
- **Calibration finally works:** gyro bias std is 0.05–0.35 °/s on all six sensors, two orders of magnitude better than Phase 4 (38–84 °/s). The fix was holding the rig still, not code.
- **No dropouts** in either capture. Finger 2's dropout didn't reproduce.
- **Drift:** roll/pitch ≤ ~1.7 °/min, mostly under 0.5. Yaw is 0.2–2.1 °/min, which matches the predicted 6-DOF drift. *(Corrected 2026-10-19: these were endpoint numbers. A line fit gives roll/pitch ≤ 0.35, yaw 0.03–2.2.)*
- **Rate fell to ~84–86 Hz** from ~93.6, because of the filter math, the Euler conversion and the extra columns.

**Verdict on sensor health:** all six IMUs are electrically fine. Finger 2's dropout is "not currently reproducing", not "fixed". Finger 5 is the noisiest unit but not faulty.

**How to get clean readings from here:**
1. Keep `SUBTRACT_GYRO_BIAS=1`. Biases are significant, e.g. −6.98 °/s on finger 5's Y axis.
2. Calibrate with the rig on a table, not in the hand.
3. Re-check finger 2's contact before mounting.
4. Test finger 5 alone to see if its noise is the chip or the contact.
5. For 100 Hz, cut per-tick serial output first.

**Problems:** No same-session bias on/off pair yet. The drift run is 31.5 s, not several minutes. The rate drop isn't profiled.

**Next:** The bias on/off pair, a 5+ minute drift run, then the glove.

---

### 2026-07-17 | Phase 4 re-check and first Madgwick sketch

**Plan:** Confirm all six sensors still read, then write the first fusion sketch.

**Achieved:**
- Re-ran the Phase 4 sketch and saved `04-all-six-imus-raw/capture_03_full_session.csv` (~15 s). Analysed and plotted it.
- **All six sensors initialise and read.**
- **Measured rate ~93.6–93.7 Hz**, not 100. Six sequential mux reads cost more than the 10 ms budget.
- **The calibration window still wasn't still** (gyro std 38–84 °/s). That's the third capture in a row. It's a capture-discipline problem.
- **Finger 2 dropped out again**: all zeros for the last ~340 ms. The same channel in two sessions points to a loose jumper.
- **Wrote `05_madgwick_fusion.ino`**: one Madgwick filter per sensor, β = 0.1, untuned. The Madgwick vs. Mahony vs. complementary choice is in DECISIONS.md.

**Problems:** The fusion sketch isn't flashed yet. The rate shortfall and finger 2's contact are both still open.

**Next:** Flash the fusion sketch, check for NaNs and flat-hold behaviour, and measure drift.

---

### 2026-07-17 | Phase 4: full six-sensor sketch, a "still" capture that wasn't

**Plan:** Add the onboard IMU and the accelerometer, use the real serial format, and add calibration and rate measurement.

**Achieved:**
- Rewrote `04-all-six-imus-raw/04_all_imus_raw.ino` with:
  - all six sensors, accel + gyro
  - the `millis,sensor_id,ax,ay,az,gx,gy,gz` format
  - a `millis()`-scheduled loop
  - a 10 s still calibration with a bias table at boot
  - a periodic rate report
- Wrote `tools/analyze_calibration.py`. All six sensors read ~1.0–1.25 g, so they're alive.
- The full session log turned up as a file (5052 lines) and became `capture_02_full_session.csv`. I added `tools/plot_6imu_3d.py` (a static 3D path plus an animated GIF).

**Problems:**
- **The "still" window wasn't still.** The hand's gZ climbed from −10 to −35 °/s across 160 ms. That's real motion, so the bias table is useless.
- **Finger 2 (ch1), not finger 5, is the one that drops out.** It goes to `0,0,0,0,0,0` at 1468 ms and never recovers (801 of 841 samples). The GIF shows one arrow freezing while the others move.

**Things worth remembering:**
- **The onboard IMU isn't a mux channel.** I thought it shared the external bus and deselected the mux before reading it. (Later, on 2026-10-19, it turned out to be on its own internal bus, Wire1, so that deselect did nothing.)
- **Axis labels differ between chips, and that's fine.** On a flat rig, gravity lands on Z for the onboard chip and on X for the breadboard fingers. Fusion has to handle each sensor's own frame.
- **Exactly 0, 0, 0 accel means a dead sensor, not a calm one.** A live accelerometer always sees gravity. A self-heal retry for that case was designed but not added yet.

**Next:** Fix finger 2's contact. Mount everything on the glove following `hardware/WIRING.md`. Re-run this sketch on the glove. Capture a real still calibration.

---

### 2026-07-16 | Phase 3/4: mux bring-up, all five fingers read together

**Plan:** Bring up the PCA9548A and read all five finger sensors, then mount everything on the glove.

**Achieved:**
- Wired the PCA9548A on a breadboard:
  - XIAO D4/D5 → mux SDA/SCL
  - A0–A2 → GND (address `0x70`)
  - RST → 3V3
  - five MPU-6050s on channels 0–4, all at `0x68`
  
  Photos in [`04-all-six-imus-raw/`](04-all-six-imus-raw/).
- The sketch has a `tcaSelect()` helper and a boot `scanChannels()`. It found `0x68` on channels 0–4, nothing on 5–7, no cross-talk. **Phase 3 closed.**
- Streamed gyro from all five at ~50 Hz (`delay(20)` at this point) and saved `movement_test.csv`. Wrote `tools/analyze_multi_imu.py` and `plot_multi_imu.py`.
- **All five track the same motion.** Correlation vs. IMU0 is 0.999, 0.994, 0.986 and 0.975, dropping with position in the read order, which fits timing skew. Cross-sensor spread is 0.6–1.4 °/s.

**Problems:**
- Gyro only. No serial format yet, and the timestamps are host-side.
- No still baseline.
- The hand IMU isn't in the loop.
- The glove mount didn't happen.

**Next:** Add the hand IMU and accel, use the real format with a timed loop, and capture a still calibration.

---

### 2026-07-14 (evening) | Phase 2: first MPU-6050 alive, and it's a clone

**Plan:** Wire one MPU-6050 straight to the XIAO and get raw data out before adding the mux. One sensor is much easier to debug than five.

**Achieved:**
- Four wires plus AD0 → GND for address `0x68`. The diagram is in `hardware/WIRING.md`.
- Adafruit's library printed `Failed to find MPU6050 chip!`. An I²C scan found `0x68`, so the wiring was fine. Reading `WHO_AM_I` (`0x75`) directly gave **`0x72`**: an MPU-6500/9250 clone. Adafruit rejects anything but `0x68`.
- Switched to `MPU6050_light`, which worked immediately. Added an `i2c_scan` diagnostic so the finding is reproducible.
- The milestone sketch streams the full format at 400 kHz. There are two stripped-down diagnostic sketches for clean gyro-only and accel-only captures.
- `tools/plot_imu_3d.py` draws each capture as a 3D path. The accel points sit on a ~1 g sphere, so axes and calibration look right. The gyro swings to ±100–240 °/s on twists and returns near zero.

**Problems:** The clone could differ from a real MPU-6050 in register defaults. If fusion misbehaves, it's a suspect. It did turn out to matter, on 2026-07-19. The gyro keeps a couple °/s of bias after `calcOffsets()`.

**Next:** The mux, then all six sensors, then the glove.

---

### 2026-07-14 (later) | Repo audit: docs matched to reality, two risks found

**Plan:** A full audit of the architecture, the working sketches, the docs and the plan.

**Achieved:**
- **Yaw drift risk:** 6-DOF sensors have no yaw reference, so the yaw of `q_rel` drifts without bound. The plan is gravity-referenced features plus a re-zero pose (DECISIONS.md).
- **I²C budget:** five muxed reads at 100 kHz take ~10 ms, the whole 100 Hz budget. 400 kHz is required.
- **Toolchain:** the README claimed PlatformIO, but the reality was the Arduino IDE. Fixed, and logged in DECISIONS.md.
- Sketch 01 now uses the serial format. Removed a stale file and added WIRING.md pre-flight checks.

**Problems:** No media captured for Phase 1, and no versions recorded.

**Next:** Phase 2, with the pre-flight checks first.

---

### 2026-07-14 | Phase 1: first light, board and onboard IMU alive

**Plan:** Get the XIAO flashing, then read its onboard IMU.

**Achieved:**
- **The board didn't show up at first.** Double-tapping RESET puts it into UF2 bootloader mode, and then it enumerated.
- **LED test passes** ([`00-led-sanity-test/`](00-led-sanity-test/)): red → green → blue. The LED is active-LOW.
- **Onboard IMU reads** ([`01-xiao-onboard-imu/`](01-xiao-onboard-imu/)) with the Seeed LSM6DS3 library. It answers at **`0x6A`**, not `0x68`.
- Board specs and pinouts saved in `hardware/datasheets/`.

**Problems:** Only the bootloader scare.

**Next:** One external MPU-6050 on D4/D5.

---

### 2026-07-10 | Phase 0: repo scaffold

**Plan:** Set up a repo that documents every milestone from the first run.

**Achieved:** README, plan, decision log and ledger, numbered milestone folders, hardware docs, `tools/`, `ml/`. Remote: `github.com/PiyushPapaya/Cheirograph`.

**Problems:** The parts were soldered but not powered yet.

**Next:** Get the XIAO talking to the laptop.

---

### 2026-07-03 | Phase 0: parts arrive, soldering

**Plan:** Unpack, inspect and solder the headers.

**Achieved:** Headers soldered on the PCA9548A and all five GY-521 boards. No visible damage.

**Problems:** Reviews mention dead-on-arrival units. Unknown until power-on.

**Next:** Set up the repo.

---

### 2025-07-27 | Phase 0: planning and research

**Plan:** Settle the architecture before buying anything. The hard questions were five sensors on one address, noisy IMU data, and running ML on the MCU.

**Achieved:** A PCA9548A mux for the address collision, Madgwick for fusion, and Edge Impulse for on-device ML. Ordered the XIAO nRF52840 Sense, 5× MPU-6050, the PCA9548A, a left half-finger glove, and tape and ties for strain relief.

**Problems:** Some reviews mention dead MPU-6050 units on arrival.

**Next:** Wait for delivery, then inspect and test each part.
