PiyushPapaya/Cheirograph/05-madgwick-fusion/data-notes.md

# 05-madgwick-fusion/ — bench captures

Serial captures from `05-madgwick-fusion/05_madgwick_fusion.ino`:
per-sensor Madgwick fusion (accel-seeded orientation, two-stage beta),
fused contract `millis,sensor_id,qw,qx,qy,qz,roll_deg,pitch_deg,yaw_deg`.

| File | What it is |
|---|---|
| `capture_01_movement.csv` | ~29.5 s bench run with deliberate hand/finger movement, `SUBTRACT_GYRO_BIAS=1`. Includes the boot log (bias table + seed-accel table). |
| `capture_02_drift.csv` | ~31.5 s of the sensors held still after calibration (the drift test). Boot log missing from the saved file — the top of the serial capture (setup + calibration echo) wasn't captured, so we don't have that run's own printed bias table, but the firmware default (`SUBTRACT_GYRO_BIAS=1`) applies unless it was edited before this run. |

Re-run the analysis:
```bash
cd tools
python analyze_drift.py ../05-madgwick-fusion/capture_01_movement.csv
python analyze_drift.py ../05-madgwick-fusion/capture_02_drift.csv
```
Note: both captures were taken with `INCLUDE_RAW=0`, so they carry only the
fused columns (`qw,qx,qy,qz,roll,pitch,yaw`), not raw accel/gyro —
`tools/analyze_calibration.py` (which expects the 8-column raw contract from
Phase 4) doesn't apply here. The gyro bias/noise table for these runs is the
one the firmware itself prints at boot (reproduced below), not something
recomputed from the CSV.

## Findings

### Calibration quality — big improvement over Phase 4

`capture_01_movement.csv`'s embedded bias table (10 s still window, 1001 samples):

| sensor | bias_x | bias_y | bias_z | std_x | std_y | std_z |
|---|---|---|---|---|---|---|
| 0 (hand) | -0.198 | -1.596 | -0.458 | 0.213 | 0.049 | 0.055 |
| 1 | 1.071 | 2.047 | 1.060 | 0.081 | 0.109 | 0.084 |
| 2 | 0.360 | 2.009 | -1.217 | 0.090 | 0.125 | 0.085 |
| 3 | -0.938 | 3.508 | -0.463 | 0.089 | 0.147 | 0.084 |
| 4 | -0.317 | 3.755 | -1.464 | 0.091 | 0.203 | 0.101 |
| 5 | 5.788 | -6.984 | -0.814 | 0.286 | 0.344 | 0.119 |

Std is now **0.05-0.35 deg/s** across all six sensors — two orders of
magnitude better than the Phase 4 captures, where the "still" window std
was 38-84 deg/s because the rig was actually being moved during
calibration. This run's window was genuinely still, and it shows: this is
the first calibration table in the project worth trusting. Finger 5 is
still the noisiest (std ~3x the others, bias also the largest in magnitude)
— consistent with every earlier capture. Not disqualifying, but worth an
isolated single-channel re-check before trusting it as much as the other
four.

### Connection health — no dropouts in either capture

Both files: all 6 sensors report `# sensor N OK` at boot, and every sensor
has the *same* sample count for the full session (2503/2503 in the
movement capture, 2719-2720/2719 in the drift capture — the ±1 is just tail
truncation, not a dropout). No all-zero rows, no NaNs. This is the first
capture where **finger 2's intermittent dead-channel issue (seen in both
Phase 4 sessions) did not reproduce.** That's good news but not proof it's
fixed — it was already intermittent (a full-session dropout once, a
340 ms dropout once, nothing this time), consistent with a marginal
physical contact rather than a resolved fault. Treat it as "not observed
this run," not "fixed," until it survives a longer session or a proper
continuity check.

### Rate — dropped further, ~84-86 Hz (was ~93.6 Hz in Phase 4)

`# rate_hz=` lines across both captures: 84.2-86.4 Hz. Adding the Madgwick
update + quaternion→Euler conversion + three extra printed columns per
sensor per tick costs real time inside the same 10 ms budget — expected,
since Phase 5 does strictly more work per tick than Phase 4's raw read.
Still short of the 100 Hz target from GENERAL_PLAN.md. Candidates to claw
time back, in rough order of expected payoff: drop `INCLUDE_RAW`-style
extra Serial.print calls in the hot loop (each one blocks on UART), profile
whether `quatToEuler` is needed every tick or only for human-readable
debugging, and re-check whether 400 kHz I²C is actually being honored by
every mux channel.

### Drift test (`capture_02_drift.csv`, sensors held still, ~31.5 s)

Run with `python analyze_drift.py`:

| sensor | droll/min | dpitch/min | dyaw/min |
|---|---|---|---|
| hand | 0.00 | 0.10 | 2.12 |
| finger 1 | 1.70 | -0.23 | -2.04 |
| finger 2 | -0.06 | 0.17 | 0.19 |
| finger 3 | 1.20 | 0.02 | -1.73 |
| finger 4 | 0.04 | -0.06 | -0.97 |
| finger 5 | 0.51 | -0.02 | -0.53 |

**Re-run 2026-10-19 with a line fit.** The table above compares only the first
and last sample. `analyze_drift.py` now fits a straight line through the whole
run (skipping the first 2 s of filter snap-in) and reports its slope, so one
noisy endpoint can't move the answer. Same file:

| sensor | droll/min | dpitch/min | dyaw/min |
|---|---|---|---|
| hand | -0.00 | 0.07 | 2.18 |
| finger 1 | 0.01 | -0.05 | -0.48 |
| finger 2 | 0.15 | 0.01 | -0.03 |
| finger 3 | -0.06 | 0.03 | -0.56 |
| finger 4 | 0.11 | -0.02 | -1.01 |
| finger 5 | 0.35 | 0.04 | -0.32 |

Roll/pitch are flatter than the endpoint numbers suggested (finger 1 roll was
1.70, is 0.01: the old figure was endpoint noise). Yaw keeps the same sign and
scale, with the hand still the largest at ~2.2 deg/min. 29.5 s is still too short
to call these final; a multi-minute bias on/off A/B run is what closes Phase 5.

**Roll and pitch are essentially flat** (≤ ~1.7 deg/min, most under 0.5) —
exactly what's expected, since Madgwick's accel correction anchors both
against gravity every tick regardless of gyro bias. **Yaw drifts at
roughly 0.2-2.1 deg/min** — small, and exactly the un-correctable behavior
CLAUDE.md's gotcha list and DECISIONS.md (2026-07-14) already predict for a
6-DOF IMU with no magnetometer: nothing anchors yaw, so any residual bias
after subtraction integrates slowly and without bound. This run used
`SUBTRACT_GYRO_BIAS=1` (the sketch's default); we don't have a same-session
`SUBTRACT_GYRO_BIAS=0` capture to do the full A/B the sketch's own comment
asks for (`# calib_end` header for this run wasn't preserved either), so
"calibration made this better" is inferred from comparison against Phase
4's uncalibrated noise floor, not proven with a controlled pair from the
same sitting. **Still open:** re-run the same still-hold test with bias
subtraction forced off to get a real paired before/after number.

**Caveat on run length:** 31.5 s is short for a deg/min estimate — the
sketch's own comment asks for "several minutes." The numbers above are
consistent in direction and small in magnitude, so the headline conclusion
(roll/pitch hold, yaw creeps slowly) is probably right, but the precise
deg/min figures should be treated as a rough first read, not a final
number, until a multi-minute capture confirms them.

### Visualizations

```bash
cd tools
python plot_fusion.py ../05-madgwick-fusion/capture_02_drift.csv \
    --save ../05-madgwick-fusion/drift_rpy.png
python plot_fusion.py ../05-madgwick-fusion/capture_01_movement.csv \
    --save ../05-madgwick-fusion/movement_rpy.png
# pass --no-mount-correction to see the raw, uncorrected per-sensor angles instead
```

Both plots apply a fixed **+90° rotation about each finger sensor's local
Y-axis** (`q_corrected = q_raw ⊗ q_offset`) before computing Euler angles,
purely to make the fingers visually comparable to the hand sensor — see
"Why hand and finger angles differ so much" below and DECISIONS.md
(2026-07-17) for what this correction is and isn't.

`05-madgwick-fusion/drift_rpy.png` — roll/pitch/yaw vs. time, one line per
sensor, unwrapped so ±180° crossings don't show as vertical jumps. With the
mount correction applied, roll and yaw for fingers 1-4 sit close to the
hand's baseline (within a few degrees), pitch settles to a small residual
9-16° per finger (their real resting tilt, not mounting error) — and
finger 5 visibly does **not** line up the way 1-4 do, sitting apart on all
three axes. Confirms the table above: everything stays flat for the full
31.5 s (no drift), and finger 5 is mounted differently, not just noisier.

`05-madgwick-fusion/movement_rpy.png` — same correction, movement capture.
Useful as a qualitative sanity check ahead of Phase 6: with the mount
correction applied, the five finger traces move together as one cluster
through every swing (finger 5 tracking the same shape but visibly offset),
while the hand sensor's trace diverges independently — exactly the
"fingers move coherently, hand is a separate reference" structure that
`q_rel = conj(q_hand) ⊗ q_finger` depends on.

### Why hand and finger angles differ so much on the same breadboard

Absolute roll/pitch/yaw are **per-sensor-local** - each IMU reports its tilt
relative to gravity in its *own* body frame, not a frame shared across
sensors. Two chips on the same breadboard can report very different
numbers simply because they're tilted differently, and that's exactly
what's happening here: the finger MPU-6050 breakout modules are plugged
straight into the breadboard rows (standing upright on their pin legs),
while the XIAO (hand, sensor 0) sits closer to flat. That's roughly a 90°
difference in physical mounting angle, and it shows up almost exactly that
way in the data - raw finger pitch sits near -75° to -80° while the hand
sits near 0°.

Verified with actual quaternion math (not just eyeballed): applying a fixed
+90° rotation about each finger sensor's local Y-axis
(`q_corrected = q_raw ⊗ q_offset`, `q_offset` = 90° about Y) brings fingers
1-4's roll and yaw into close agreement with the hand sensor, e.g. finger 1
goes from raw `(roll=-2.1, pitch=-80.7, yaw=0.3)` to corrected
`(roll=-0.4, pitch=9.3, yaw=-1.8)` against the hand's `(-1.6, -1.1, 0.0)` -
close on roll and yaw, with the remaining ~9-16° of pitch being each
finger's actual resting tilt on the bench, not mounting error.

**Finger 5 does not follow the same pattern** - the identical correction
leaves it out of alignment with the other four (its yaw stays near 56°
instead of settling near 0 like fingers 1-4's ~-2 to +3°). Combined with
finger 5's consistently elevated gyro noise across every capture so far,
this points at finger 5 being seated in its breadboard slot at a genuinely
different angle than the other four, not merely a noisier unit. Worth a
physical check before glove-mounting.

This is expected behavior, not a bug, and doesn't need fixing for the real
pipeline - it's exactly why Phase 6 computes `q_rel = conj(q_hand) ⊗
q_finger` instead of comparing absolute angles. The `+90°/Y` correction
here is a one-off, hand-picked constant for making *this rig's* plots
readable; it is explicitly not that calculation and won't carry over once
sensors are mounted on the glove at their intended angles.

### Movement capture (`capture_01_movement.csv`)

Used here only to confirm the fusion runs stably under real motion (no
NaNs, no stuck quaternions, all sensors keep reporting through ~30 s of
deliberate movement) — `analyze_drift.py`'s first/last-sample numbers on
this file are not drift figures (the rig wasn't held still), they just
show large swings because fingers were being moved, e.g. finger 1
droll/min of -32.6 is motion, not gyro error. Sanity-check only.
