PiyushPapaya/Cheirograph/tree.md

PS C:\Users\anil1\Downloads\Cheirograph> tree /F
Folder PATH listing
Volume serial number is 00000031 7A9B:7B35
C:.
│   .gitignore
│   CLAUDE.md
│   DECISIONS.md
│   DOCUMENTATION.md
│   GENERAL_PLAN.md
│   LICENSE
│   README.md
│   
├───.claude
│       settings.local.json
│       
├───.dist
├───data
│       .gitkeep
│       README.md
│       
├───docs
│   ├───log
│   │       README.md
│   │       TEMPLATE.md
│   │       
│   └───media
│           .gitkeep
│           
├───firmware
│   ├───01_xiao_imu_test
│   │       main.cpp
│   │       README.md
│   │       
│   ├───02_single_mpu6050_test
│   │       main.cpp
│   │       README.md
│   │       
│   ├───03_mux_channel_test
│   │       main.cpp
│   │       README.md
│   │       
│   ├───04_all_imus_raw
│   │       main.cpp
│   │       README.md
│   │       
│   ├───05_madgwick_fusion
│   │       main.cpp
│   │       README.md
│   │       
│   ├───06_relative_orientation
│   │       main.cpp
│   │       README.md
│   │       
│   ├───07_full_glove
│   │       main.cpp
│   │       README.md
│   │       
│   └───lib
│           .gitkeep
│           README.md
│           
├───hardware
│       BOM.md
│       WIRING.md
│       
├───ml
│       .gitkeep
│       README.md
│       
└───tools
        .gitkeep
        README.md
