PiyushPapaya/Cheirograph/docs/media/glove-back-curled-on-table.jpg

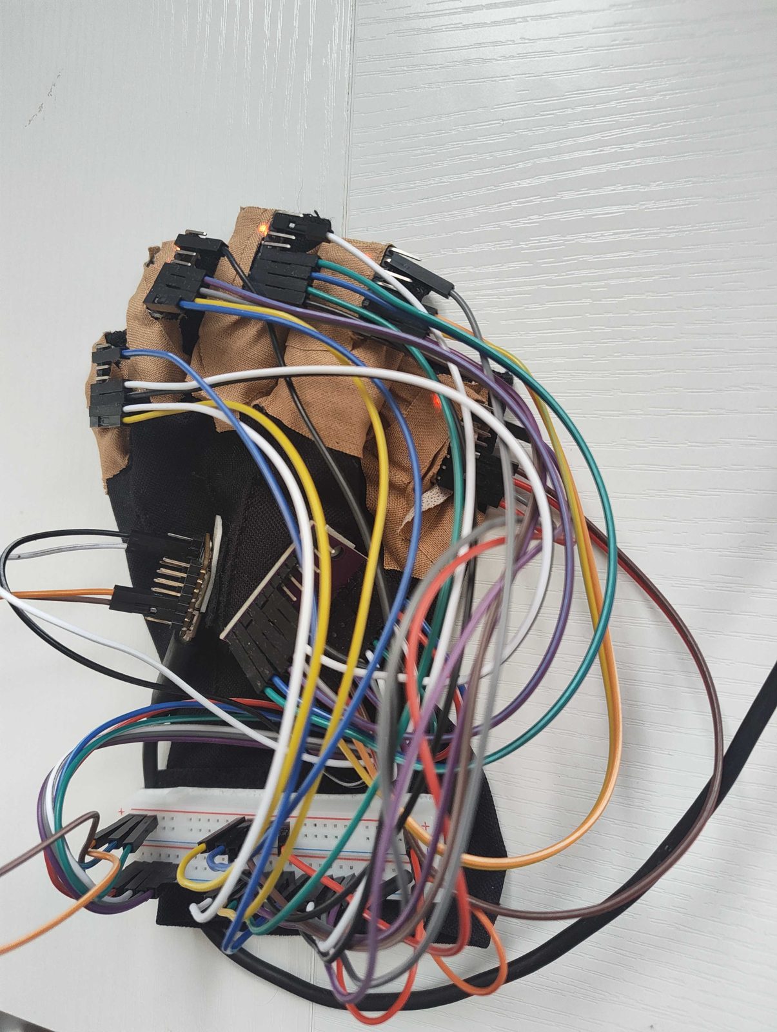
docs/media/glove-back-curled-on-table.jpg
