PiyushPapaya/Cheirograph/docs/media/phase5_drift_rpy.png

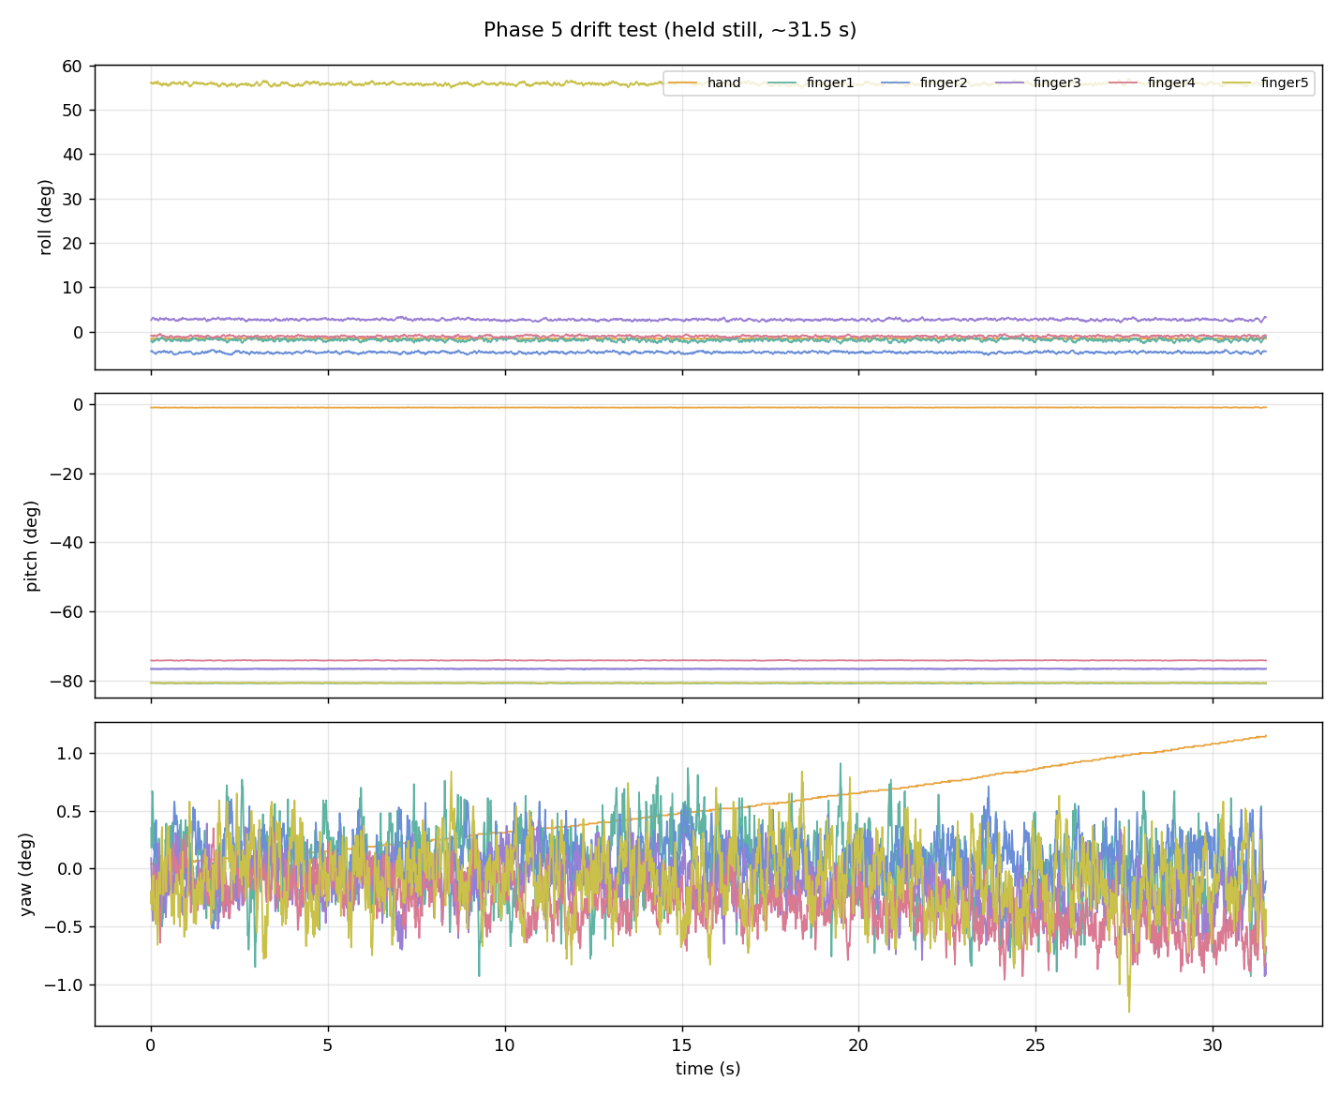
docs/media/phase5_drift_rpy.png
