PiyushPapaya/Cheirograph/docs/media/phase7_glove_mount_fingers_wired.jpg

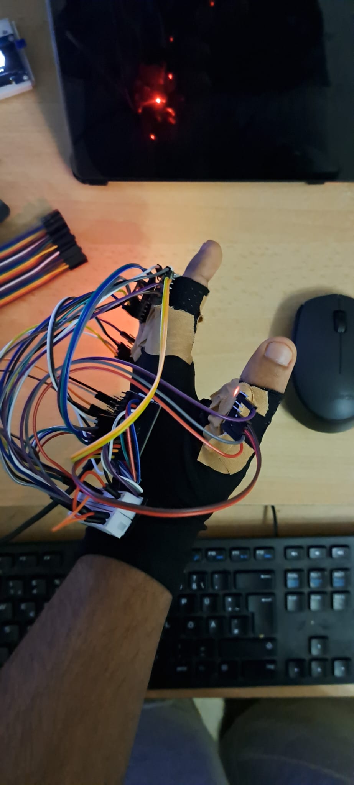
docs/media/phase7_glove_mount_fingers_wired.jpg
