PiyushPapaya/Cheirograph/docs/media/t2-fast-fist-cover.jpg

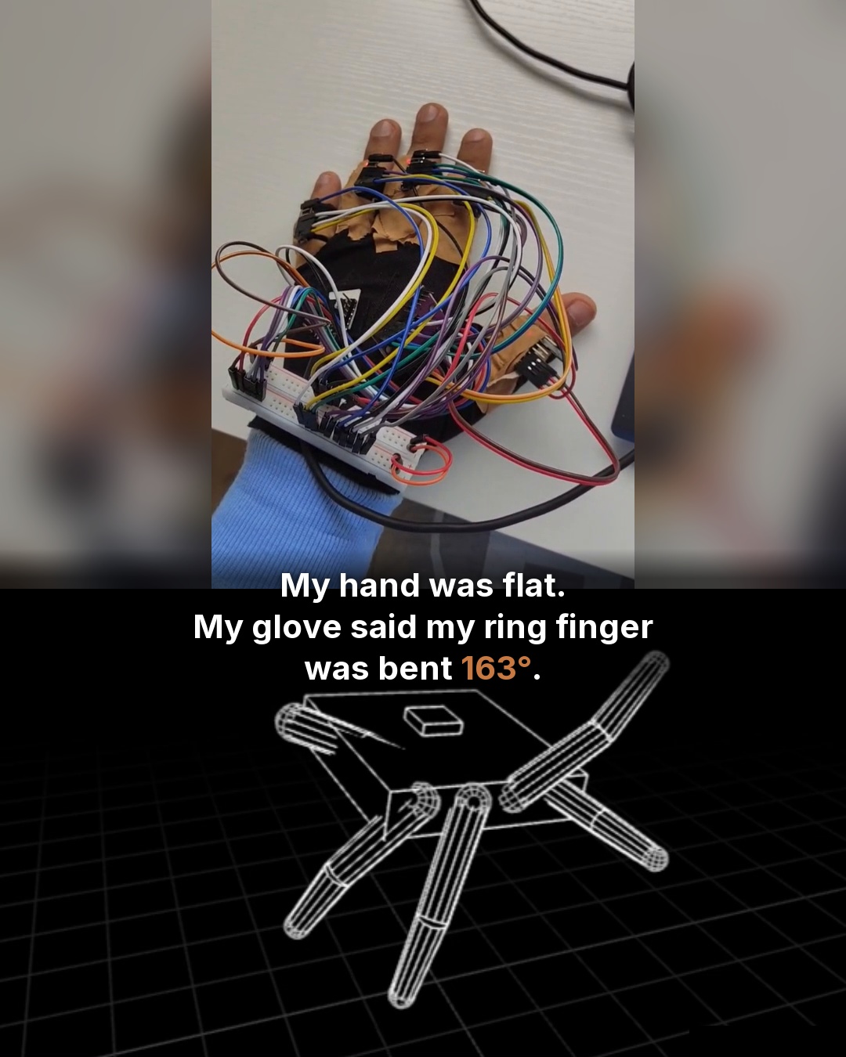
docs/media/t2-fast-fist-cover.jpg
