PiyushPapaya/Cheirograph/hardware/WIRING.md

# hardware/WIRING.md — Wiring Diagram and Pin Map

**This is the single authoritative source for the sensor ↔ mux-channel ↔ finger mapping.**
Keep it in sync with the firmware. If you change a wire, update this file in the same commit.

---

## XIAO nRF52840 Sense pin assignments

| XIAO Pin | Signal | Connected to |
|---|---|---|
| 3V3 | Power | PCA9548A VCC, all GY-521 VCC |
| GND | Ground | PCA9548A GND, all GY-521 GND |
| SDA (D4) | I²C data (external) | PCA9548A SDA |
| SCL (D5) | I²C clock (external) | PCA9548A SCL |
| Internal SDA | I²C data (onboard) | LSM6DS3 (hand reference IMU) — do not expose externally |
| Internal SCL | I²C clock (onboard) | LSM6DS3 — do not expose externally |

---

## PCA9548A channel assignments

> **Confirmed against the glove wiring on 2026-07-19 (thumb = ch0, pinky = ch4). This is the one authoritative mapping.** `sensor_id` in firmware and CSVs: 0 = hand, 1–5 = channels 0–4.

| Mux Channel | I²C Address | Finger | Sensor placement |
|---|---|---|---|
| 0 | 0x68 | Thumb | Tip segment (per the user, 2026-11-07; earlier docs said proximal phalanx; when it moved is unknown, not visible in the July photo) |
| 1 | 0x68 | Index | Middle phalanx |
| 2 | 0x68 | Middle | Middle phalanx |
| 3 | 0x68 | Ring | Middle phalanx |
| 4 | 0x68 | Pinky | Middle phalanx |
| — | — | Hand (back) | XIAO onboard LSM6DS3 |

*Channels 5–7 are unused.*

---

## Wiring diagram

No full-glove schematic yet. Photos of the glove wiring are in [`07-full-glove-assembly/`](../07-full-glove-assembly/).

**Two buses on the XIAO.** The mux and fingers sit on `Wire` (D4/D5). The onboard LSM6DS3 sits on the internal `Wire1` (pins 16/17). The Seeed library quietly does `#define Wire Wire1` for it. A jammed finger bus can't take down the hand sensor, and mux commands do nothing to it.

**Phase 2 — single sensor, direct (no mux), verified 2026-07-14:**

MPU-6050 → XIAO direct wiring

```
        MPU-6050 (GY-521)                 XIAO nRF52840 Sense
        VCC ──────────────────────────────► 3V3
        GND ──────────────────────────────► GND
        SDA ──────────────────────────────► D4 / SDA
        SCL ──────────────────────────────► D5 / SCL
        AD0 ──► GND   (sets I²C addr 0x68)
        INT ──► (not connected)
```

This is the same D4/D5 external bus the PCA9548A will occupy in Phase 3; the mux
inserts between this sensor and the XIAO without changing the XIAO-side pins.

---

**Phase 3/4 — PCA9548A mux + all 5 finger IMUs, bench breadboard, verified 2026-07-16:**

Photos: `04-all-six-imus-raw/breadboard_top.jpg`, `04-all-six-imus-raw/breadboard_angle.jpg`.

```
        PCA9548A                          XIAO nRF52840 Sense
        VIN ──────────────────────────────► 3V3
        GND ──────────────────────────────► GND
        SDA ──────────────────────────────► D4 / SDA
        SCL ──────────────────────────────► D5 / SCL
        A0, A1, A2 ──► GND   (sets mux addr 0x70)
        RST ──► 3V3          (active-low — hold high to keep the mux enabled)

        MPU-6050 #0..#4 (all identical, all AD0 -> GND -> addr 0x68)
        VCC ──────────────────────────────► 3V3 (shared rail)
        GND ──────────────────────────────► GND (shared rail)
        SDA ──────────────────────────────► mux SD0..SD4 (one channel each)
        SCL ──────────────────────────────► mux SC0..SC4 (one channel each)
```

This is a bench bring-up: sensors sit flat on a breadboard, referred to in
firmware/data as `IMU0`..`IMU4` (= mux channels 0-4). **No finger identity is
assigned yet** — that mapping (thumb/index/middle/ring/pinky) happens when
these move onto the glove in Phase 7; the table above is the plan for that
point, not the current wiring.

---

## Physical mounting (Phase 7 — glove)

- **Finger IMUs → leukoplast (fabric tape) only.** Needs to be rigidly coupled to the
  phalanx — any wobble injects noise into that finger's whole orientation signal. Tape
  can go directly over the MPU-6050 chip itself; it does not damage the IC (no pressure
  risk, no static risk from the tape).
- **XIAO + PCA9548A → velcro, or leukoplast if serviceability isn't a priority.** These
  need occasional removal (reflash the XIAO, recharge the battery); leukoplast is
  semi-permanent once stuck down hard. Velcro (hook on the board/enclosure, loop sewn or
  taped to the glove) trades a little rigidity for that removability.
- **PCA9548A has no orientation constraint** — it has no axes, so mount it however wiring
  is shortest: upstream pins (VIN/GND/SDA/SCL) facing the XIAO, channel pins facing the
  fingers.
- **Pin-header orientation on the finger breakouts**: mount so VCC/GND/SCL/SDA sit closest
  to the hand (shortest run back to the mux) and the two unused pins (AD0, INT) point
  toward the fingertip, out of the way.
- **IMU axis convention on the glove**: Y toward the fingertip (down the finger). X and Z
  follow from the board's fixed geometry once Y is chosen — don't try to align them
  independently. Verify empirically after taping: hold the hand flat, palm down, and check
  which raw accel axis reads ~-9.81 (that's local "down"); note the sign per sensor before
  trusting any relative-orientation math.
- **Leave slack in the finger→mux wire runs** and tack the slack loop down with one strip
  of tape — see strain-relief notes below; this is the #1 cause of a glove sensor that
  worked on the bench and died once mounted.

---

## Pre-flight checks (verify at first MPU-6050 power-on, Phase 2)

- [ ] **GY-521 LDO vs. 3.3 V supply:** most GY-521 boards route VCC through an onboard
  3.3 V LDO that expects 5 V in. Feeding 3.3 V *through* the LDO can undervolt the
  MPU-6050 depending on dropout. Verify these specific boards run reliably from 3.3 V
  (measure the MPU-6050 VDD pin); note the result here.
- [ ] **Master-side I²C pull-ups:** each GY-521 has pull-ups on its own (mux-channel)
  segment, but the XIAO→PCA9548A master segment needs its own — check whether the mux
  breakout provides them; add 4.7 kΩ to 3V3 if not.
- [ ] **Pull-ups do NOT parallel across GY-521s** — the mux connects one channel at a
  time, so only one board's pull-ups are ever active. Do not "fix" this.
- [ ] **I²C clock:** plan for 400 kHz (`Wire.setClock(400000)`) — required for the
  100 Hz × 6-sensor budget. Re-verify signal integrity once wiring moves onto the glove
  (long flexible runs at 400 kHz are where marginal edges bite).

---

## Strain relief notes

- All wire runs crossing a knuckle must be anchored with Leukoplast tape on both sides of the flex point.
- Use stranded 28–30 AWG wire for all glove runs; solid-core wire will fracture at the knuckle.
- No solder pad should take a bend directly — the anchor must be on the wire insulation, not the pad.
- After mounting, flex each finger 20× and check continuity before running firmware.

---

## IMU axis convention — confirmed on-glove (2026-07-19)

With all 5 finger sensors taped to the glove and the hand IMU seated flat:

- **Finger sensors**: sensor **−Y points toward the fingertip**, sensor **+Z
  points up** (out of the back of the finger). X follows from board geometry.
- **Hand sensor (XIAO onboard LSM6DS3)**: reads `az ≈ -0.98 g` with the glove
  lying flat, palm down — i.e. its **Z axis points down** in that pose, the
  opposite sense from the finger sensors' Z. The hand IMU and the finger
  MPU-6050/clones are different chips with different internal axis
  conventions; do not assume they share a frame.
- **Consequence**: `tools/handrig_dashboard.html`'s 3D model uses
  `+Z = forward (fingertip), +Y = up`, which does not match either sensor's
  raw frame directly. A per-sensor axis remap is needed before the data feeds
  Madgwick. This is **implemented** in the dashboard (`REMAPS` / `applyRemap`, dashboard v4); the finger
  remap is measured, the hand's forward axis is picked from the UI. See
  `08-ble-wireless-dashboard/README.md` and `DECISIONS.md` (2026-07-19).
- Leukoplast tape used to mount the finger sensors was checked and ruled out
  as a source of bad *initial* readings (non-conductive, can't cause a stuck
  digital register) — see `DECISIONS.md` for the actual root cause found that
  session. Tape can still cause *intermittent* dropouts if it strains a wire
  during finger flex; distinguish the two by checking the firmware boot
  diagnostic with the glove flat and untouched.

## Change log

| Date | Change | Changed by |
|---|---|---|
| 2026-11-07 | Thumb sensor location corrected to the tip segment, on the user's report. The table said proximal phalanx. Docs only, no wiring change. When the sensor moved is unknown (unverified). | Piyush |
| 2026-10-31 | Channel table marked confirmed; noted the hand IMU's separate `Wire1` bus (found 2026-10-19). Docs only, no wiring change. | Piyush |
| 2026-07-19 | All 6 IMUs mounted and wired on the glove; mux channel map confirmed against physical build (thumb=ch0 `SD0/SC0`, pinky=ch4 `SD4/SC4`, matching the table above). Confirmed finger sensor axis convention (`-Y`=fingertip, `+Z`=up) and that the hand IMU uses a different Z sense (`az≈-0.98g` flat, palm down). Axis remap to the visualization's model frame flagged as an open item, not yet applied. | Piyush |
| 2026-07-16 | Added Phase 3/4 mux + 5-finger-IMU bench wiring (breadboard, no finger identity assigned yet). Mux channel switching verified via `scanChannels()` — 0x68 on channels 0-4, no cross-talk. | Piyush |
| 2026-07-14 | Added Phase 2 single-sensor direct-connect diagram (MPU-6050 → D4/D5, AD0→GND = 0x68). Verified on the bench. | Piyush |
