PiyushPapaya/Cheirograph/09-firmware-hardening/motion-tests/T0_still_v5_2026-10-31.csv

# raw sensor frame (no axis remap | no bias correction)
t_ms | hand_ax | hand_ay | hand_az | hand_gx | hand_gy | hand_gz | thumb_ax | thumb_ay | thumb_az | thumb_gx | thumb_gy | thumb_gz | index_ax | index_ay | index_az | index_gx | index_gy | index_gz | middle_ax | middle_ay | middle_az | middle_gx | middle_gy | middle_gz | ring_ax | ring_ay | ring_az | ring_gx | ring_gy | ring_gz | pinky_ax | pinky_ay | pinky_az | pinky_gx | pinky_gy | pinky_gz
789327 | -0.2477 | 0.4137 | -0.8625 | 0.0458 | -1.8005 | -0.6256 | -0.2593 | 0.1267 | 0.9486 | 0.4120 | 2.1973 | -0.9766 | -0.4656 | 0.2053 | 0.8761 | 0.9155 | 2.2125 | 1.0681 | -0.5789 | 0.2582 | 0.7866 | -0.7477 | 3.4790 | -0.9003 | -0.6187 | 0.2292 | 0.7277 | -0.4120 | 3.6926 | -1.4343 | -0.5010 | 0.2404 | 0.4969 | 5.8746 | -7.1259 | -0.8240
789386 | -0.2454 | 0.4143 | -0.8597 | 0.2136 | -1.8616 | -0.5035 | -0.2562 | 0.1276 | 0.9498 | 0.4425 | 2.0905 | -1.2512 | -0.4634 | 0.2054 | 0.8815 | 1.1139 | 2.0905 | 0.9155 | -0.5793 | 0.2566 | 0.7863 | -0.6409 | 3.4332 | -0.9460 | -0.6174 | 0.2286 | 0.7303 | -0.2747 | 3.6316 | -1.5259 | -0.5013 | 0.2395 | 0.4974 | 5.8899 | -7.0190 | -0.8698
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
