PiyushPapaya/Cheirograph/09-firmware-hardening/motion-tests/T1_slow-fist_v5_2026-10-31.csv

# raw sensor frame (no axis remap | no bias correction)
t_ms | hand_ax | hand_ay | hand_az | hand_gx | hand_gy | hand_gz | thumb_ax | thumb_ay | thumb_az | thumb_gx | thumb_gy | thumb_gz | index_ax | index_ay | index_az | index_gx | index_gy | index_gz | middle_ax | middle_ay | middle_az | middle_gx | middle_gy | middle_gz | ring_ax | ring_ay | ring_az | ring_gx | ring_gy | ring_gz | pinky_ax | pinky_ay | pinky_az | pinky_gx | pinky_gy | pinky_gz
1040790 | -0.2374 | 0.4441 | -0.8470 | -0.2747 | -1.6174 | -0.1526 | -0.2866 | 0.1412 | 0.9376 | 0.5341 | 2.1057 | -1.1902 | -0.4901 | 0.2201 | 0.8671 | 1.1749 | 1.8768 | 0.9460 | -0.6178 | 0.2736 | 0.7450 | -0.6256 | 3.7384 | -1.0529 | -0.6650 | 0.2036 | 0.6895 | -0.2899 | 3.9673 | -1.6174 | -0.5500 | 0.2410 | 0.4399 | 5.8899 | -6.9885 | -0.5798
1040850 | -0.2314 | 0.4410 | -0.8325 | -0.4425 | -1.8616 | -0.9155 | -0.2847 | 0.1387 | 0.9346 | 0.7782 | 3.1738 | -0.8240 | -0.4883 | 0.2186 | 0.8588 | 1.2665 | 2.6398 | 1.0376 | -0.6195 | 0.2706 | 0.7369 | -0.6561 | 4.3182 | -1.0376 | -0.6619 | 0.2046 | 0.6833 | -0.3815 | 4.8065 | -1.6785 | -0.5472 | 0.2401 | 0.4325 | 5.6915 | -5.9509 | -1.2054
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
