PiyushPapaya/Cheirograph/09-firmware-hardening/motion-tests/T3_each-finger_v5_2026-10-31.csv

# raw sensor frame (no axis remap | no bias correction)
t_ms | hand_ax | hand_ay | hand_az | hand_gx | hand_gy | hand_gz | thumb_ax | thumb_ay | thumb_az | thumb_gx | thumb_gy | thumb_gz | index_ax | index_ay | index_az | index_gx | index_gy | index_gz | middle_ax | middle_ay | middle_az | middle_gx | middle_gy | middle_gz | ring_ax | ring_ay | ring_az | ring_gx | ring_gy | ring_gz | pinky_ax | pinky_ay | pinky_az | pinky_gx | pinky_gy | pinky_gz
1327894 | -0.2699 | 0.3929 | -0.8630 | -1.4801 | -1.9226 | 0.2747 | -0.2621 | 0.1438 | 0.9453 | 0.7782 | 3.0518 | -1.3123 | -0.4860 | 0.1919 | 0.8684 | 1.0834 | 2.4872 | 0.5188 | -0.6206 | 0.2610 | 0.7472 | -0.6714 | 4.2572 | -1.2817 | -0.6782 | 0.2012 | 0.6823 | -0.4730 | 4.7607 | -1.9226 | -0.5626 | 0.2703 | 0.4189 | 5.7678 | -6.2714 | -0.7172
1327954 | -0.2704 | 0.3958 | -0.8610 | 0.3204 | -1.8921 | 0.0458 | -0.2665 | 0.1433 | 0.9504 | 0.3967 | 1.4954 | -1.2512 | -0.4902 | 0.1917 | 0.8751 | 1.2665 | 1.1749 | 0.9155 | -0.6254 | 0.2621 | 0.7487 | -0.8698 | 3.2501 | -1.0529 | -0.6808 | 0.2004 | 0.6837 | -0.4120 | 3.1586 | -1.5869 | -0.5698 | 0.2693 | 0.4142 | 5.7831 | -8.3923 | -0.6714
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
