PiyushPapaya/Cheirograph/08-ble-wireless-dashboard/capture_02_pre_fix_garbage_calibrated.csv

t_ms | hand_ax | hand_ay | hand_az | hand_gx | hand_gy | hand_gz | thumb_ax | thumb_ay | thumb_az | thumb_gx | thumb_gy | thumb_gz | index_ax | index_ay | index_az | index_gx | index_gy | index_gz | middle_ax | middle_ay | middle_az | middle_gx | middle_gy | middle_gz | ring_ax | ring_ay | ring_az | ring_gx | ring_gy | ring_gz | pinky_ax | pinky_ay | pinky_az | pinky_gx | pinky_gy | pinky_gz
130250 | 0.1174 | -0.0935 | -0.9800 | -0.0916 | -1.6327 | -0.5951 | -2.6257 | 2.1071 | 0.0621 | 246.0938 | 14.7705 | -11.6882 | -0.9799 | -0.0007 | -0.0133 | -0.5951 | -328.2471 | -267.8528 | 0.0621 | 1.9688 | 0.1168 | -11.8103 | -122.5586 | -0.0763 | -0.0137 | -0.0046 | -2.6560 | 200.9125 | 7.7820 | 246.0938 | 0.1168 | -0.0951 | -0.9811 | -0.0763 | -1.7395 | -0.6714
130731 | 0.1172 | -0.0946 | -0.9806 | -0.0458 | -1.8005 | -0.6104 | -2.6277 | 1.1075 | 0.0624 | 246.0938 | 14.6790 | -11.7493 | -0.9811 | -0.0017 | -0.0132 | -0.5493 | -328.3081 | -396.6980 | 0.0624 | 1.9688 | 0.1169 | -11.8713 | -122.4976 | -0.1221 | -0.0140 | -0.0049 | -2.6536 | 72.0673 | 7.8125 | 246.0938 | 0.1166 | -0.0929 | -0.9802 | -0.1984 | -1.7395 | -0.4883
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
