PiyushPapaya/Cheirograph/09-firmware-hardening/motion-tests/before-fix_2026-10-31/T5_hand-rotate_v5_2026-10-31.csv

# raw sensor frame (no axis remap | no bias correction)
t_ms | hand_ax | hand_ay | hand_az | hand_gx | hand_gy | hand_gz | thumb_ax | thumb_ay | thumb_az | thumb_gx | thumb_gy | thumb_gz | index_ax | index_ay | index_az | index_gx | index_gy | index_gz | middle_ax | middle_ay | middle_az | middle_gx | middle_gy | middle_gz | ring_ax | ring_ay | ring_az | ring_gx | ring_gy | ring_gz | pinky_ax | pinky_ay | pinky_az | pinky_gx | pinky_gy | pinky_gz
1794888 | -0.3044 | 0.3529 | -0.8580 | -1.3428 | -1.3885 | -0.9918 | -0.1064 | 0.0872 | 0.9825 | -0.4883 | 2.7313 | 0.5188 | -0.4613 | 0.2245 | 0.8701 | 1.0529 | 3.3722 | 1.4954 | -0.5854 | 0.2452 | 0.7788 | -0.5035 | 5.5695 | -0.5035 | -0.6196 | 0.2006 | 0.7280 | -0.6104 | 5.7068 | -1.1444 | -0.4744 | 0.2817 | 0.5219 | 5.7983 | -5.7220 | -0.4730
1794940 | -0.3044 | 0.3516 | -0.8644 | -0.0305 | -1.5106 | -0.6256 | -0.1057 | 0.0880 | 0.9854 | 0.2289 | 2.5635 | -1.8158 | -0.4639 | 0.2268 | 0.8767 | 1.0223 | 1.8921 | 0.7629 | -0.5873 | 0.2419 | 0.7765 | -0.9003 | 3.9215 | -0.9613 | -0.6187 | 0.1995 | 0.7305 | -0.5035 | 4.0436 | -1.5869 | -0.4857 | 0.2852 | 0.5266 | 5.8594 | -7.2479 | -0.7935
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
