PiyushPapaya/Cheirograph/(commit log)

2026-07-10 chore: scaffold repo structure and documentation
    Full repository scaffold for Cheirograph — 6-IMU gesture-tracking glove.
    Includes README, GENERAL_PLAN, DOCUMENTATION, DECISIONS, .gitignore, LICENSE,
    seven firmware milestone stubs (01–07), hardware BOM + wiring map, tools/,
    data/, ml/, and docs/log/ devlog template. No implementation — structure only.
2026-07-14 feat(phase-1): first light — flash XIAO, blink LED, read onboard IMU
    - add firmware/00_led_sanity_test: RGB LED blink to prove board+toolchain
    (double-tap RESET to flash; LED is active-LOW)
    - fill firmware/01_xiao_imu_test: real LSM6DS3 read via Seeed lib, addr 0x6A
    - add hardware/datasheets/XIAO_nRF52840_Sense.md: specs, pin map, both
    pinout images, and the two-library install note
    - log 2026-07-14 session in DOCUMENTATION.md
2026-07-14 refactor(phase-1): rename IMU sketch to .ino for Arduino IDE consistency
    Match the LED sanity test — both milestone sketches are now .ino,
    reflecting the actual Arduino IDE workflow used to flash them.
2026-07-14 audit: align docs with reality, surface yaw-drift + I2C-budget risks
    - DECISIONS.md: log Arduino-IDE-vs-PlatformIO fork; log 6-DOF yaw-drift
    mitigation (gravity-referenced features + re-zero pose)
    - README: replace fictional PlatformIO instructions with actual Arduino
    IDE workflow; fix past-tense skills claim; add 00/datasheets to tree
    - GENERAL_PLAN: tick Phases 0-1; bake 400kHz I2C, measured-drift, and
    wear-time acceptance criteria into Phases 4-6
    - WIRING.md: add pre-flight checks (GY-521 LDO at 3.3V, master-side
    pull-ups, 400kHz plan)
    - sketch 01: emit contract format (millis,sensor_id,...), mark
    while(!Serial) as bench-only
    - CLAUDE.md: five new hard-won gotchas
    - delete stale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
2026-07-14 feat(phase-2): single MPU-6050 on direct I2C — raw accel + gyro verified, 3D-plotted
    Wire one GY-521 straight to D4/D5 (no mux, AD0->GND = 0x68) and prove it before
    the PCA9548A layer goes in.
    - 02_single_mpu6050_test.ino: milestone sketch, full serial contract
    (millis,sensor_id,aX..gZ) at 400 kHz via MPU6050_light 1.2.1 + calcOffsets()
    - diagnostics/{gyro_raw,accel_raw}: the minimal single-stream sketches actually
    flashed for the captures (one .ino per folder for Arduino IDE)
    - data/phase2_single_mpu6050/: the two raw bench captures (deg/s, g)
    - tools/plot_imu_3d.py + requirements.txt: 3D time-coloured trajectory plotter;
    accel sits on the ~1g gravity sphere, gyro loops out and bac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
2026-07-14 docs(phase-2): correct the clone-chip story, add refs + i2c_scan + wiring diagram
    The MPU-6050 module is a clone: it ACKs at 0x68 but WHO_AM_I (0x75) returns 0x72,
    which is why Adafruit_MPU6050 rejected it and MPU6050_light worked. Earlier docs
    framed the library swap as a preference — corrected to the real debugging story.
    - DECISIONS: reframe library choice around the 0x72 WHO_AM_I mismatch
    - DOCUMENTATION: rewrite Phase 2 entry with the actual bring-up (scanner -> WHO_AM_I
    -> clone -> library swap); flag clone as a Phase-5 watch-item
    - CLAUDE.md: new gotcha for "chip not found but scanner sees 0x68"
    - diagnostics/i2c_scan: pure-Wire scanner + WHO_AM_I reader that reproduces the find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
2026-07-14 docs(log): write narrative devlog for phases 0–2
    The devlog is the human-story lane (prose + photos, one entry per completed phase),
    distinct from DOCUMENTATION.md's terse per-session ledger. Composed from the ledger
    + DECISIONS.md and reshaped into narrative.
    - phase-00: architecture decisions, BOM, soldering, repo scaffold
    - phase-01: first flash (double-tap RESET / UF2), onboard IMU at 0x6A
    - phase-02: the clone — Failed-to-find -> scanner 0x68 -> WHO_AM_I 0x72 -> library swap;
    embeds wiring diagram + both 3D plots
    - README index updated; left explicit *(to capture)* placeholders for missing photos
2026-07-16 feat(phase-3/4): PCA9548A mux verified, 5 finger IMUs reading coherently via mux
    All five MPU-6050 clones bring up through the mux (scanChannels finds 0x68
    on channels 0-4, no cross-talk - closes Phase 3). Bench-captured a hand
    motion run and confirmed all five track the same rigid-body rotation
    (r=0.999 down to r=0.975 vs IMU0, falling off with sequential-read skew).
    Phase 4 still open: onboard hand IMU, accel, the project's serial contract,
    and a measured 100 Hz loop are not yet in the sketch.
2026-07-16 feat(phase-4): full 6-sensor sketch + full-session capture finds a dead finger channel
    Sketch now reads onboard hand IMU + 5 fingers, accel+gyro, real serial
    contract, calibration window, rate reporting. The complete bench capture
    (saved as a file, not pasted) shows finger 2 (mux ch1) drops to permanent
    all-zero at millis=1468 and never recovers, and that the declared 10s
    "still" calibration window contains a large hand rotation instead. Added
    analyze_calibration.py and plot_6imu_3d.py (static 3D trajectory + animated
    vector GIF) to find and show this. Logged as the next session's first fix
    before moving everything onto the glove.
2026-07-17 feat(phase-5): Madgwick fusion implemented + bench-verified, Phase 4 re-checked
    Two work sessions bundled: re-ran Phase 4's 6-sensor sketch to re-verify
    connection health (all 6 alive, finger 2's dropout intermittent not fixed,
    rate ~93.6 Hz not 100 Hz), then wrote and bench-tested the Phase 5 Madgwick
    fusion sketch (accel-seeded orientation, two-stage beta, roll/pitch/yaw
    output). Calibration is now genuinely trustworthy (gyro std 0.05-0.35 deg/s,
    down from 38-84 deg/s), drift is small (roll/pitch flat, yaw creeps as
    expected for 6-DOF), no dropouts in either new capture. Logged the
    Madgwick-vs-Mahony and seeded-orientation design forks in DECISIONS.md.
2026-07-17 docs(phase-5): add roll/pitch/yaw visualizations for drift + movement captures
    New tools/plot_fusion.py plots unwrapped roll/pitch/yaw per sensor over time.
    Visually confirms the drift-test finding (roll/pitch flat, yaw creeps slowly)
    and the movement-test finding (5 fingers move as one coherent cluster, hand
    sensor diverges independently) ahead of Phase 6's relative-orientation math.
2026-07-17 fix(phase-5): correct plot_fusion.py column bug, add mount-angle correction + finding
    plot_fusion.py had an indexing bug plotting raw millis as roll. Fixed, and
    added a verified +90deg/local-Y correction for finger sensors so plots are
    comparable to the hand sensor - the ~90deg gap between hand and finger
    absolute pitch is a breadboard mounting-angle artifact (fingers plugged in
    upright, hand lying flatter), not a sensor fault. Finger 5 doesn't line up
    under the same correction, pointing at a genuinely different mount angle
    for that sensor rather than just higher noise. Logged as a decision.
2026-07-18 feat(phase-7): mount XIAO+mux, wire all 5 finger IMUs to glove, confirm live 6-sensor read
    All finger IMUs and the XIAO/mux are now physically on the glove instead of
    loose on the bench. Re-flashed 04_all_imus_raw and confirmed all 6 sensors
    read live (per-sensor LEDs + serial data). Strain relief taping, a saved
    capture, and the 30-min wear test are still open before Phase 7 fully closes.
    Also logs the leukoplast-vs-velcro mounting-material decision and adds a
    physical-mounting section to WIRING.md, and plans a Phase 7.5 wireless
    live-visualization tool ahead of Phase 8 data collection.
2026-07-19 feat(phase-7.5): BLE live dashboard, diagnose+fix clone-IMU init bug
    Built firmware/08_ble_dashboard (v3) and tools/handrig_dashboard.html for
    live wireless visualization. Diagnosed 4/5 finger IMUs returning frozen
    registers / linear ramps via raw CSV capture, traced it to MPU-6050 clones
    (WHO_AM_I=0x72) that MPU6050_light never fully wakes, and fixed it with a
    raw I2C reset->wake->enable-axes sequence plus a boot-time liveness check.
    Confirmed mux channel map and finger-sensor axis convention on the mounted
    glove; ruled out mounting tape as the garbage-data cause. Axis remap to the
    dashboard's model frame is designed (DECISIONS.md) but not yet implemented,
    and v3 firmware has not yet been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
2026-07-25 feat(phase-7.5): v4 IMU hardening — verify-by-readback, stuck watchdog, axis remap
    v3 wrote the correct clone-init registers but discarded every write's ACK, so
    a NACK was indistinguishable from success — including a NACKed mux select,
    which silently writes one finger's config to whichever channel was latched.
    Firmware (08_ble_dashboard.ino v4):
    - verify config by readback (PWR_MGMT_1/2, GYRO_CONFIG, ACCEL_CONFIG); an ACK
    only proves something answered, a readback proves that chip stored it
    - runtime stuck watchdog: 50 consecutive bit-identical frames = frozen output
    registers. At +/-4g/8192 LSB/g one LSB is 122ug vs a ~2-3mg RMS noise floor,
    so a live sensor cannot repeat exactly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
2026-08-06 fix(phase-7.5): resolve BLE throughput collapse and calibration-settle drift
    First live BLE session on v4 firmware showed hz collapsing 50->8.3 while
    bleuart.write() blocked for 100ms+ per frame — a starved BLE link, not the
    sensor/fusion loop (read_us stayed flat). Fixed with a wider peripheral
    bandwidth config (MTU + notification queue) and a relaxed connection
    interval; confirmed live at ~47 Hz / 3.7 KB/s.
    Also fixed the dashboard's post-calibration settle delay (600ms -> 2.5s),
    which was too short to let the Madgwick filter reconverge before capturing
    the zero-orientation reference at low smoothing settings, causing the model
    to visibly drift/spin while the glove sat still.
    Session a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
2026-08-06 fix(phase-7.5): root-cause calibration-settle drift, add curl readout + thumb rig fix + first gesture rule
    The previous session's calibration-settle fix (waiting 600ms, then 2.5s, for the
    Madgwick filter to reconverge from identity before capturing the zero reference)
    was still not enough — reported live as the hand model continuing to rotate on
    its own with the glove dead still. Root cause: a fixed wall-clock wait can't
    cover every combination of smoothing setting and how far the calibration pose
    is from flat. Fixed for real: finishCalibration() now runs the existing
    Madgwick.update() synchronously ~40 times against the calibration-average
    gravity vector (beta forced to 1.0), converging t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
2026-08-07 feat(dashboard): rebrand handrig_dashboard.html as Gestura, UI overhaul
    Full visual pass on the live dashboard: copper/graphite brand palette
    driven from a single BRAND token object, Gestura wordmark + hand-topology
    mark, redesigned telemetry cluster and finger cards, hero treatment for
    the hand-reference card, ambient grain background, and a warm rim light
    on the 3D scene's reference cube. Drops the internal "HandRig" name in
    favor of "Gestura" for this file only, per explicit decision (see
    DECISIONS.md) — everything else in the repo stays Cheirograph-branded.
    Functionally unchanged (same BLE/calibration/gesture logic).
    Also documents today's other addition, the nine gestura-* social-pip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
2026-08-08 fix(dashboard): rebuild thumb rig geometry after box-clipping failures
    Three straight-guess iterations on the thumb's rest pose each fixed one
    symptom while leaving another: bend on the wrong axis popped it out of
    the fingers' plane, a sign error flared it away from the hand, and even
    after fixing both the anchor sat partly inside the solid palm box,
    rendering hidden.
    Dropped the two-axis kink entirely after verifying (200-step path walk
    in a scratch Node script, not eyeballing) that 22.8% of its length was
    buried in the box — the "broken/twisted" look reported live. Replaced
    with a straight segment matching the four fingers' already-proven
    zero-clip design: verified clip fraction now 7.5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
2026-08-08 fix(dashboard): gate calibration average on gyro deviation, not absolute value
    A still hand read a fixed ~20-29 deg offset on all four fingers right
    after calibrating, root-caused to the calibration average including
    motion from before the hand actually settled at the start of the hold.
    First fix attempt gated samples on absolute raw gyro (<6 deg/s), on the
    assumption a still sensor reads near zero. Wrong, and a live regression:
    a stationary MPU-6050 reads near its own fixed per-chip bias (this file
    already tolerates bias up to ~40 deg/s elsewhere), and one real sensor's
    bias exceeded the 6 deg/s cutoff, locking it out of calibration for the
    whole hold and leaving it permanently stuck on ra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
2026-08-08 chore: add start_dev_setup.bat dev convenience launcher
    Opens the dashboard, Arduino IDE, and VS Code together for faster
    session startup during Phase 8 prep work.
2026-08-08 feat(tools): add analyze_noise_baseline.py — pre-Phase-8 noise QA gate
    Reads a 60s flat-still capture from the dashboard's existing raw CSV
    export and reports per-sensor gyro bias/noise, accel |a| deviation,
    and heuristically-detected dropped/stuck frames (excluded from the
    stats so a few bad frames can't skew the numbers). Thresholds mirror
    finishCalibration()'s bad-sensor flags in handrig_dashboard.html so
    this script and the live dashboard agree on what counts as OK. Gives
    a go/no-go before starting real Phase 8 labelled data collection.
2026-08-08 feat(dashboard): extend calibration hold 10s -> 20s, make startCalibration reusable
    Doubling the hold roughly halves the standard error of the gyro-bias
    estimate (more samples averaged) for zero added complexity. Also
    parameterizes startCalibration(durationMs, onDone) so the upcoming
    Batch Capture mode can reuse the exact same averaging/gating logic
    for its short between-rep recalibration instead of duplicating it.
2026-08-08 feat(dashboard): add Batch Capture mode for rapid labelled static-pose collection
    Adds the Phase 8 rapid-capture workflow: 20s initial calibration, then
    ARMED -> [Space] -> save a sample -> 5s recalibration -> ARMED, looped,
    so many labelled reps can be captured back-to-back instead of hand-
    running calibrate/record/export per rep.
    Noise reduction: each saved sample is a MEDIAN over a ~0.6s rolling
    window of raw per-sensor readings (new pushBatchRaw/rawHist), not one
    instantaneous noisy frame. A stillness gate (std-dev over that same
    window, bias-agnostic for the same reason the existing STILL_DEV_DPS
    calibration gate is) rejects in-transition poses before they can enter
    the dataset -- in p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
2026-08-09 docs(phase-7.5): add pre-Phase-8 noise QA checklist to BLE dashboard README
    Codify the boot-diagnostic -> calibrate -> 60s-flat-still noise-baseline ->
    Batch Capture sequence so real labelled-data sessions can't start on
    silently-bad hardware.
2026-08-09 feat(tools): analyze_noise_baseline.py exits nonzero on NO-GO
    The pre-Phase-8 checklist says the script "must print GO" before real
    collection starts, but it always exited 0 -- makes the gate scriptable
    instead of relying on someone reading the verdict text correctly.
2026-08-09 feat(tools): analyze_noise_baseline.py forces NO-GO on short captures
    Checklist requires a 60s flat-and-still hold, but the script never
    verified the exported CSV covered that window -- a short capture could
    still print a clean per-sensor GO built on too little data to trust.
2026-08-10 feat(dashboard): port dropped/stuck-frame detectors from analyze_noise_baseline.py
    nbFindDropped/nbFindStuck are a direct JS port of the Python script's
    heuristics (|a|<0.05g for dropped, >=50 consecutive bit-identical rows for
    stuck), operating on a plain Nx6 sensor block so they stay pure and
    independently testable against hand-built synthetic arrays.
2026-08-10 feat(dashboard): add per-sensor noise-floor stats + verdict
    nbAnalyzeSensor() computes accel-magnitude, gyro bias, and gyro noise-floor
    over the clean (non-dropped, non-stuck) samples in a sensor's block and
    verdicts it against the same thresholds finishCalibration() already applies
    live (BAD ACCEL / BAD GYRO / NOISY / OK), mirroring
    analyze_noise_baseline.py's per-sensor row.
2026-08-10 feat(dashboard): add nbAnalyze() GO/NO-GO aggregator with 50s duration guard
    Ties the detectors and per-sensor stats together into a single report:
    overall GO/NO-GO, per-sensor breakdown, and the checklist's 50s
    minimum-duration guard (mirrors analyze_noise_baseline.py's short_capture
    check) — a capture that's otherwise clean but too short still fails NO-GO.
2026-08-10 feat(dashboard): expose window.NoiseBaseline console API + DOM result bridge
    window.NoiseBaseline.analyze is the console/scratch-testable entry point
    (NoiseBaseline.analyze(myFrameArray)). runNoiseBaselineCheck()/showNoisePanel()
    bridge that pure result into the recorded-buffer + on-screen overlay the UI
    wires up next. Guards the not-yet-added Noise Check button lookup since the
    markup lands in a follow-up commit.
2026-08-10 feat(dashboard): add Noise Check button and GO/NO-GO overlay markup
    Wires the "Noise Check" button next to Export CSV (enabled whenever a
    recorded buffer exists, same gating as csv) and the dismissible result
    overlay (#noisePanel) that runNoiseBaselineCheck()/showNoisePanel() from the
    previous commit already targets. The refreshCards()/event-listener wiring
    for these elements landed with the initial styling commit; this closes the
    loop by adding the DOM nodes they reference.
2026-08-10 test(tools): add verify_noise_baseline_js.mjs synthetic-frame verification
    Node-runnable check for window.NoiseBaseline.analyze(), extracted directly
    from handrig_dashboard.html's <script> so it always tests the shipped code,
    not a copy. Covers the three cases the port needed to handle correctly: a
    clean 60s noisy-still capture (GO), an all-bit-identical 60s capture
    (NO-GO via the stuck-frame detector), and a clean-but-5s capture (NO-GO via
    the duration guard) -- the same throwaway-synthetic-CSV method already used
    to validate analyze_noise_baseline.py, kept as a permanent regression check
    since it's cheap to run (`node tools/verify_noise_baseline_js.mjs`).
2026-08-11 feat(dashboard): flip batch-capture gate flag from Noise Check result
    runNoiseBaselineCheck() is the sole writer of the GO-baseline flag --
    this is the missing link that actually connects the Noise Check
    button's result to Batch Capture's availability.
2026-08-11 feat(dashboard): guard startBatchCapture() against the gate directly
    Belt-and-suspenders check inside startBatchCapture() itself, so the
    gate holds even if something other than the button click handler ever
    calls it (keyboard shortcut, console, future entry point).
2026-08-12 feat(dashboard): add localStorage persist/restore helpers for batch capture
    A tab crash/reload mid-session currently loses every rep captured since
    the last manual "Export Batch CSV" click -- for a long labelling
    session that's the single biggest risk. Adds
    persistBatchRows/restoreBatchRows/clearPersistedBatchRows mirroring
    batchRows/batchRepCounts into localStorage. Not wired into the
    capture/export/startup flow yet -- that's the next commit.
2026-08-12 feat(dashboard): persist batch rows to localStorage on every capture
    Calls persistBatchRows() right after a rep is pushed into batchRows in
    captureBatchSample(), so the localStorage backup stays current with
    every successful capture rather than only at manual export time.
2026-08-13 feat(dashboard): add CSS for a per-letter batch coverage grid
    Styling for a small A-Z overlay grid on the 3D stage: neutral graphite
    cells matching the existing instrument-panel language, green + glow
    once a letter's rep count clears the coverage goal. No markup wired up
    yet -- next commit adds the container and cell contents.
2026-08-13 feat(dashboard): add batchgrid container to the stage overlay
    Empty container for the A-Z coverage grid, positioned alongside the
    existing batchhint/batchflash overlays. Populated by buildBatchGrid()
    in the next commit.
2026-08-13 feat(dashboard): update coverage grid counts from updateBatchUI
    updateBatchGrid() writes each letter's current batchRepCounts value
    into its cell and toggles the "done" state at BATCH_GOAL_REPS, called
    from the single updateBatchUI() choke point so the grid can never
    drift out of sync with the batch-count label next to it.
2026-08-13 feat(data): add phase8_labelled_gestures drop-in folder + naming convention
    Creates data/phase8_labelled_gestures/ as the target for CSVs exported
    from the dashboard's Batch Capture flow, with a README documenting the
    handrig_batch_<letter>_<session#>_<timestamp>.csv naming convention so
    files don't collide across the ~3 sessions/class collection target.
2026-09-28 chore(git): stop tracking internal planning docs
    CLAUDE.md, GENERAL_PLAN.md, DOCUMENTATION.md, and DECISIONS.md are
    Claude-workflow-internal (roadmap, dated ledger, decision log) and were
    never meant to be public. Untrack them and add to .gitignore; files stay
    on disk locally. History scrub happens in a later step.
2026-09-28 refactor(stage-00): promote LED sanity test to top-level stage folder
    Renames firmware/00_led_sanity_test -> 00-led-sanity-test at repo root,
    as the first milestone in the public progress story.
2026-09-28 refactor(stage-01): promote XIAO onboard IMU test to top-level stage folder
2026-09-28 refactor(stage-02): promote single MPU6050 test to top-level stage folder
    Includes its diagnostics/ subfolder (i2c_scan, gyro_raw, accel_raw).
2026-09-28 refactor(stage-03): promote I2C mux channel test to top-level stage folder
2026-09-28 refactor(stage-04): promote all-six-IMU raw read to top-level stage folder
2026-09-28 refactor(stage-05): promote Madgwick fusion to top-level stage folder
2026-09-28 refactor(stage-06): promote relative orientation to top-level stage folder
2026-09-28 refactor(stage-07): promote full glove assembly to top-level stage folder
2026-09-28 refactor(stage-08): promote BLE wireless dashboard to top-level stage folder
2026-09-28 feat(stage-02): fold in accel/gyro CSVs + 3D plots as proof material
    Moves the phase2 raw capture CSVs and their 3D trajectory plots into
    02-single-mpu6050/ so the stage folder is self-contained evidence.
2026-09-28 feat(stage-04): fold in phase3-4/phase4 CSVs, breadboard photos, visualizer, gifs
    Moves all five-IMU and six-IMU raw capture data, breadboard rig photos,
    the standalone 3D visualizer, and accel plots/gifs into
    04-all-six-imus-raw/ as proof material for this stage.
2026-09-28 feat(stage-05): fold in movement/drift CSVs + RPY plots
2026-09-28 feat(stage-07): fold in glove-mount photos
2026-09-28 feat(stage-08): fold in BLE pre-fix diagnostic CSVs + dashboard copy
    Moves the phase7.5 pre-fix garbage-data captures (evidence of the clone-
    IMU frozen-register bug) into 08-ble-wireless-dashboard/, and copies the
    dashboard HTML in as this stage's deliverable (canonical runnable copy
    stays in tools/).
2026-09-28 docs(stage-00): move devlog narrative into story.md
2026-09-28 docs(stage-01): move devlog narrative into story.md
2026-09-28 docs(stage-02): move devlog narrative into story.md
2026-09-28 feat(data): add Data/firmware — type-sorted copy of all firmware code
    Curated mirror of every .ino/.cpp across all 9 stages, prefixed by stage
    slug, for anyone who wants the code without reading the story.
2026-09-28 feat(data): add Data/csv — type-sorted copy of all raw/fused captures
    Curated mirror of every CSV capture across all stages that have data
    (02, 04, 05, 08), prefixed by stage slug.
2026-09-28 feat(data): add Data/images — type-sorted copy of all photos/plots/gifs
    Curated mirror of every image (breadboard photos, 3D trajectory/RPY
    plots, glove-mount photos) across all stages, prefixed by stage slug.
2026-09-28 feat(data): add Data/html — visualizer + dashboard copies
2026-09-28 feat(data): add Data/datasheets — board datasheet + pinout copies
    Copies (not moves) of hardware/datasheets/*; the canonical reference
    copy stays in hardware/ since it's shared across multiple stages.
2026-09-28 chore: retire empty docs/ wrapper folder after redistribution
    All media has been redistributed into stage folders + Data/images.
    docs/log/README.md, docs/log/TEMPLATE.md, and docs/REFERENCES.md remain
    on disk locally (already untracked, hidden) but the docs/ folder no
    longer holds any publicly tracked content.
2026-09-28 refactor: rename firmware/lib -> lib (top-level shared placeholder)
    Promotes the shared-code placeholder to root now that firmware/ no
    longer wraps the per-stage milestone folders.
2026-09-28 chore(gitignore): update ignore rules for new layout
    Drops stale data/ path rules (that top-level folder no longer exists —
    its contents are now in the stage folders and Data/) and points the
    large-artefact ignore rules at ml/ instead, where future labelled-
    gesture data collection will land.
2026-09-28 docs: rewrite all stage READMEs and stories in plain, direct voice
    Rewrites every 00-08 stage README from the denser spec-sheet tone into
    a clear, conversational write-up: what the stage does, why it matters,
    what actually broke, and what the data/photos prove. Stages 00-02 also
    get a short story.md — the personal, narrative account of that session,
    separate from the more structured README.
    Content and facts are unchanged from the working notes this was drawn
    from (DOCUMENTATION.md, DECISIONS.md, hardware/WIRING.md, and the prior
    README drafts) — only the voice and structure changed.
2026-09-28 docs: cut em dashes, add Mermaid diagrams, sharpen the writing
    Removes every em dash from the root README and all 9 stage write-ups,
    rephrasing around them instead of substituting a different punctuation
    mark. Adds Mermaid diagrams (native GitHub rendering, no image export
    needed) where a picture actually clarifies the mechanism: the system
    architecture and stage pipeline in the root README, the mux channel
    sequence in stage 03, the six-sensor read loop in stage 04, the
    two-pass Madgwick seeding change in stage 05, the wave-vs-curl
    distinction in stage 06, and the clone-chip diagnosis flow plus the
    runtime stuck-watchdog state machine in stage 08.
    Also tightens weaker sentences throughout f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
2026-09-28 fix: simplify Mermaid diagrams so GitHub actually renders them, vary headings
    The root README's stage-pipeline diagram wasn't rendering on GitHub
    (confirmed by screenshot: empty box, no error). Likely cause: HTML
    <br/> tags inside node labels, which GitHub's pinned Mermaid version
    doesn't reliably handle. Stripped every <br/> across all diagrams,
    dropped the custom style/dasharray block on the architecture diagram,
    and simplified node labels to plain single-line text. Also removed
    parentheses from a sequence diagram's participant aliases (03), a
    second likely parse hazard.
    Separately, reworded the repeated template headings ("What it does",
    "What 'done' looks like", "What this isn't", "Proo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
2026-09-29 docs: honest README with status and measured results, add repo hygiene files
    Status table separates what works from what is still a stub (relative
    orientation is dashboard-only, 06 firmware is a placeholder). Loop rate
    now states measured 85-94 Hz instead of 100 Hz. Fix stale paths in
    tools/README, pin pillow, add mailmap, CITATION, SECURITY, CONTRIBUTING
    and GitHub templates.
2026-10-06 dashboard: monochrome drafting-sheet redesign + 17 bug fixes
    Redesign: black ground, white linework, one mono typeface, no radius/shadow/
    blur/gradient/grain; copper accent dropped. State is carried by glyph + word
    (LIVE / NO DATA / CHECK / FAULT with a double rule), axes by line style
    (solid X, dashed Y, dotted Z) in traces, bar fills and a rotating triad. 3D
    hand is a hidden-line-removed wireframe. Colours come from the CSS :root
    tokens. Real doctype/head/body, one font request, SRI on Three.js r128.
    Bugs: reconnect kept stale rxBuf/lastSeq/counters; listener added after
    startNotifications and never removed; failed/wrong device left GATT up; picker
    cancel shown as error; recording and cal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
2026-10-06 stage 08: sync dashboard copy to the redesigned canonical file
    Byte-identical to tools/handrig_dashboard.html (md5 checked).
2026-10-06 tools/README: correct the dashboard section (80-byte frame, 20 s calibration)
    Also documents record/export, noise check and batch capture, and the verify_*.mjs scripts.
2026-10-06 WIRING: the sensor-to-viewer axis remap is implemented, not pending
2026-10-06 stage 08 README: three identical dashboard copies and how to keep them in sync
2026-10-19 tools: check_dataset.py quality gate for Phase 8 batch exports
    Fails on pre-fix (not hand-relative) exports, NaN, non-unit or unpinned
    quaternions, dropped or off-1g sensors, frozen registers between reps, and
    duplicate rows; reports per-letter per-session coverage. A synthetic data
    generator and a fault-injection test (13/13 pass) back it up.
2026-10-19 tools: train_baseline.py kNN baseline with leave-one-session-out
    Three feature sets from the hand-relative quaternions (raw quat, finger
    direction in hand frame, palm-ward curl only). Shows on synthetic data that
    a random split overstates accuracy, and that curl-only features ignore yaw
    drift but cannot separate U from V.
2026-10-19 analyze_drift: line-fit drift rate and a bias on/off --compare mode
    First/last-sample drift was noise-sensitive: finger 1 roll read 1.70 deg/min,
    the fitted slope over the same run is 0.01. Re-ran the Phase 5 drift capture
    and recorded both tables in the stage notes.
2026-10-19 stage READMEs: record board package and library versions
    Read from the build machine's Arduino15 folder: Seeed nRF52 Boards 1.1.13,
    Seeed Arduino LSM6DS3 2.0.7, MPU6050_light 1.2.1. Stages 00-05 note that
    the board package used at flash time was not logged.
2026-10-19 09 firmware v5: runtime bus recovery, hand IMU recovery, checked BLE write
    Written without hardware and not yet compiled. Adds bus unwedge when every
    finger reads dead (all-zero counts, since SDA-low reads 0x00 with ACKs),
    re-init for the hand IMU (on Wire1, so v4's tcaDisable before hand reads was
    a no-op), a hand read that can fail, re-init for sensors that keep failing,
    and a checked bleuart.write with MTU on the report line. Frame unchanged.
2026-10-19 09 firmware v5: full name in scan response, MTU logged after exchange, sleep instead of spin
    Name moved to the scan response (31 B advert held flags+txpower+128-bit UUID,
    so addName() cut it to 'HandR'). MTU now logged from the SoftDevice exchange
    event. loop() delays until the next 20 ms tick instead of returning at once,
    so the RTOS idle task can sleep the chip. Still not compiled or flashed.
2026-10-19 dashboard: curl-sign and model-hand display controls, pending glove check
    Curl readout can be |pitch| (default, unchanged), +pitch or -pitch. Model hand
    can be right (default) or left; left mirrors the static rig geometry across
    the YZ-plane and leaves live quaternions alone. Display only: batch export and
    noise check don't read either setting. Mirrors synced (md5 8f5c2187).
2026-10-31 docs: publish plan, build log and decision log; fix stale status and paths
    - Track GENERAL_PLAN.md, DOCUMENTATION.md and DECISIONS.md (were gitignored).
    CLAUDE.md, docs/log and docs/REFERENCES stay local.
    - Phase status corrected: v4 BLE firmware has been live on the glove since
    2026-08-07 (~47 Hz); v5 still unflashed; Phase 6 math lives in the dashboard.
    - DECISIONS: index table, open decisions (watchdog, numpy pin, samples per
    letter), repaired the merged 2026-07-25 readback/watchdog entry.
    - README rewritten for first-time readers: status, measured results
    (drift now line-fit <= 0.35 deg/min), four key bugs, links into the record.
    - Stage READMEs: drift numbers, live BLE results a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
2026-10-31 chore(firmware): move 09 sketch into matching folder for Arduino IDE
2026-10-31 motion tests T0-T6 on v5: raw CSVs, protocol log, analysis and accel-offset fit scripts
    Captures show 16.7 Hz instead of 50, gyro clipping at +/-500 dps on fast
    fist (11-15 % of finger samples) and a pinky accel zero-g offset of
    (0.25, 0.19, -0.17) g. Videos stay local (gitignored).
2026-10-31 v5 firmware: gyro +/-2000 dps on all six IMUs, request 247 B MTU / 2M PHY / 15 ms interval
    Fixes the 60 ms-per-frame BLE stall (serial now mtu=527 ci_ms=15 hz=50)
    and the +/-500 dps clipping on fast finger snaps. Report line prints ci_ms.
2026-10-31 dashboard: fix 17-27 deg calibration settle error, pinky accel offset, self-healing fusion
    - closed-form calibration settle (40-step loop could only turn ~92 deg)
    - gyro scale 16.384 to match v5 (+/-2000 dps)
    - pinky accel offset corrected, plus live sphere-fit offset learning saved per browser
    - snap-back, auto re-zero on flat hand, live gyro-bias tracking
    - trust flags, HEALTH readout, batch quality gate, smoothed 3D display
    - docs: why the glove works now, decisions, status
2026-10-31 docs: before/after table for motion tests T0-T6, fix v4 gyro scale note (4x too large, not too small)
2026-10-31 dashboard: default hand axes fwd +X (measured from T5 gyro fit), left-hand model, align finger headings at calibration
2026-10-31 dashboard: learn the velcro-mounted hand IMU's in-plane angle live from hand vs finger gyros
2026-10-31 dashboard: measure the hand IMU's tilt from gravity at calibration (fixes pitch/turn swap), remove the hand-axes picker
2026-10-31 README: bring status, results, bugs and run steps up to date with v5 and the self-calibrating dashboard
2026-11-07 README: add current dashboard screenshot and eight glove photos (rotated, resized) to the See it section
2026-11-07 touch detection stage, dashboard black box and audit fixes
    Add 10-touch-detection: pose labels, guided calibration, touch templates,
    trainer and calibration report. The dashboard now records raw frames,
    events and self-test results in the version 3 export.
    Fix a frame stream freeze on a throw in parseFrame, the missing
    setTouchModel, unknown pair names in touch models, an unguarded 3D loop
    and stale coach text. Add verify_blackbox.mjs for export to report.
2026-11-07 thumb display follows the nearest learned pose; first real v3 session
    The thumb snapped back onto the palm once a pose was far from every
    calibration anchor, because all blend weights fell under a fixed floor.
    Weights are now relative to the nearest anchor, and a thumb tip within
    0.75 of a fingertip is drawn closing onto it. Detection is unchanged.
    Add the first version 3 glove export and its report: 16 of 16 holds,
    0 frames lost, Self-test 0 % on touches because repeat touches land as
    far from their holds as the near misses do. Add a replay of the raw
    frames through the page code and a test for the drawn thumb gaps.
