PiyushPapaya/Cheirograph/(notices)

Notices in the files:
README.md:
License: MIT
